omaru-san/casa-freecad/laminas/01_arquitectura.pdf

PLANTA PRIMER PISO | PLANTA SEGUNDO PISO

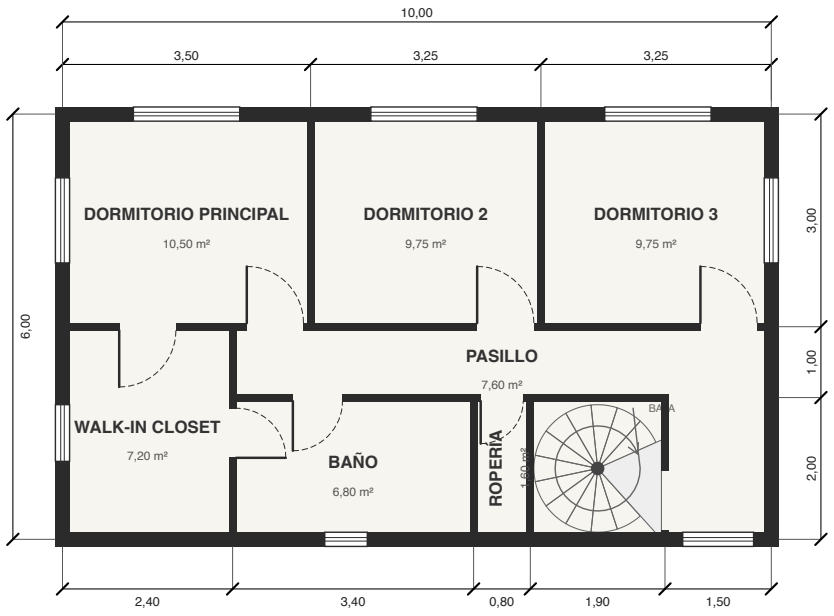
[picture p4: figure]
BAJA; DORMITORIO PRINCIPAL; DORMITORIO 2; DORMITORIO 3; WALK-IN CLOSET; BAÑO; ROPERÍA; PASILLO
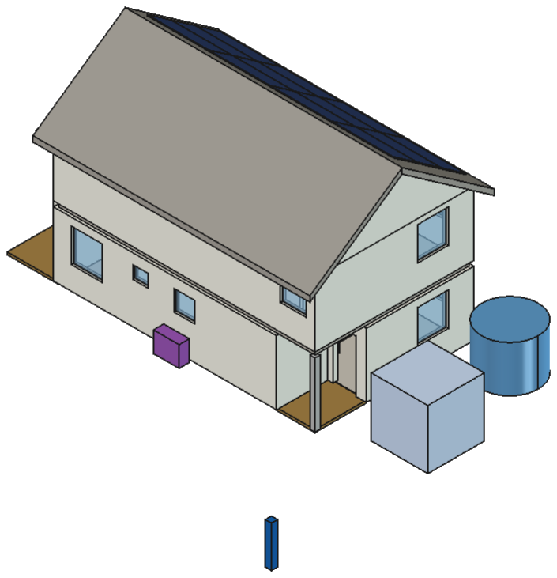
[picture p5: figure]

PROYECTO | VIVIENDA 2 PISOS — ANTEPROYECTO
LÁMINA | PLANTAS DE ARQUITECTURA
ESCALA | 1:100 (imprimir en A3)
FECHA | 20-10-2026
CÓDIGO | ARQ-01 · 1 de 14

Medidas aproximadas — verificar en terreno. +Y = norte geográfico.

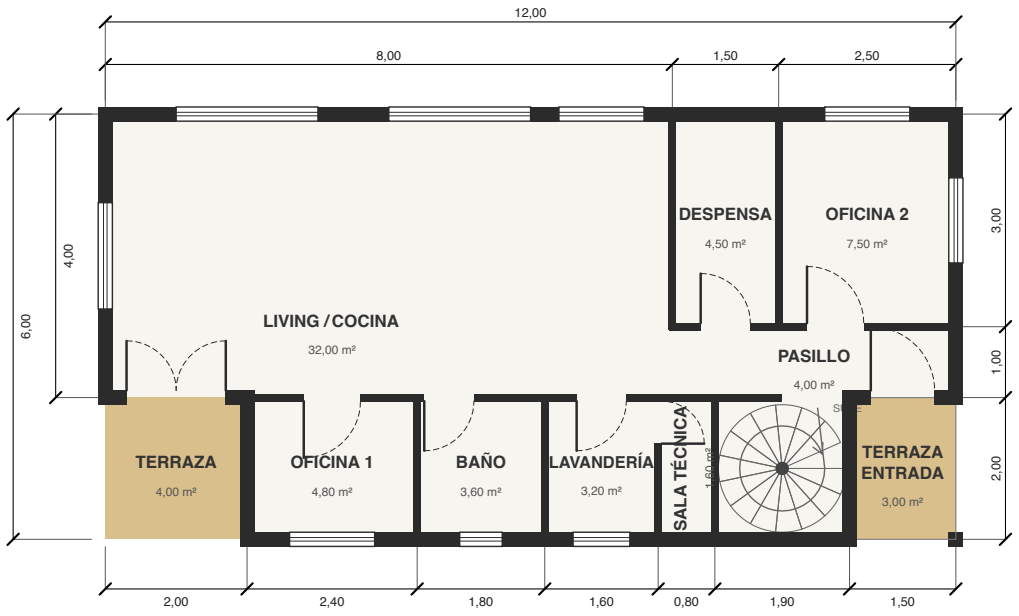
[picture p6: figure]
SUBE; LIVING / COCINA; TERRAZA; OFICINA 1; BAÑO; LAVANDERÍA; SALA TÉCNICA; TERRAZA ENTRADA; DESPENSA; OFICINA 2; PASILLO

CUADRO DE SUPERFICIES | m²
Primer piso | 65,00
Segundo piso | 60,00
Total edificado | 125,00
Terrazas (no edificadas) | 7,00

Superficies medidas a eje de muros

## NOTAS

1. Medidas en metros, a eje de muro. Escala 1:100 en A3.
2. Muros exteriores 20 cm, tabiques 10 cm. Piso-cielo P1 2,36 m, P2 2,50 m (≥ 2,30, OGUC 4.1.1).
3. Entrepiso acústico de madera 34 cm (piso flotante + cielo desacoplado,
detalle en ELE-02). Nivel piso 2 = +2,70 m. El P2 no lleva piso radiante.
4. Escalera helicoidal Ø 1,80 m (ESC-01): 15 contrahuellas de
18 cm, huella 25 cm en la línea de huella. Se entra de frente
desde el pasillo; llega al hall del P2. Barrotes < 10 cm y puertas
de seguridad arriba y abajo (bebé, gatos). Libera la sala técnica.
6. Ventanas P2 con antepecho 1,00 m y limitador de apertura 10 cm.
7. Superficie ≤ 140 m² y 2 pisos → F-15 (OGUC 4.3.5 n°14), DS1 ok.
8. Mesones 0,85 m y muebles altos a 1,40 m (estatura 1,64 m).
9. Medidas en casa_datos.py; regenerar: python3 generar_laminas.py

## VISTA 3D (modelo FreeCAD)

## SIMBOLOGÍA

Muro / tabique

Ventana

Puerta (abatimiento)

Terraza exterior
