omaru-san/casa-freecad/laminas/02_electrico.pdf

PLANTA PRIMER PISO | PLANTA SEGUNDO PISO

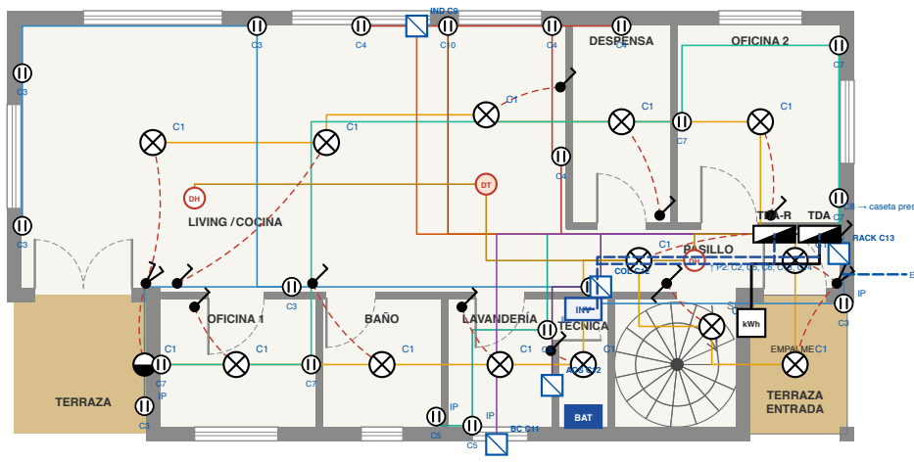
[picture p7: figure]
SUBE; LIVING / COCINA; TERRAZA; OFICINA 1; BAÑO; LAVANDERÍA; SALA; TÉCNICA; TERRAZA ENTRADA; DESPENSA; OFICINA 2; PASILLO; IND C9; ACS C12; COL C12; RACK C13; TDA-R; TDA; kWh; EMPALME; INV; BAT
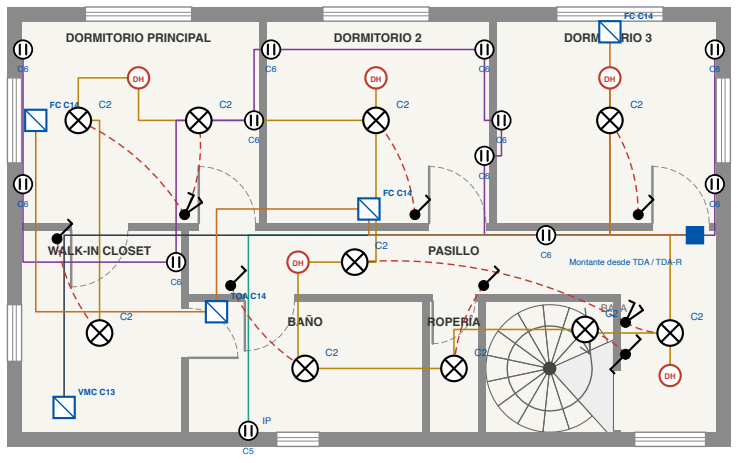
[picture p8: figure]
BAJA; DORMITORIO PRINCIPAL; DORMITORIO 2; DORMITORIO 3; WALK-IN CLOSET; BAÑO; ROPERÍA; PASILLO; VMC C13; TOA C14; Montante desde TDA / TDA-R

C8 → caseta presurizadora / pozo

EV → cargador 11 kW (estac.)

PROYECTO | VIVIENDA 2 PISOS — ANTEPROYECTO
LÁMINA | INSTALACIÓN ELÉCTRICA
ESCALA | 1:100 (imprimir en A3)
FECHA | 20-10-2026
CÓDIGO | ELE-01 · 2 de 14

Medidas aproximadas — verificar en terreno. +Y = norte geográfico.

Circ. | Destino | Protección | Conductor | Fase · dif.
C1 | Alumbrado P1 y terrazas (IP54) | 10 A curva B | 1,5 mm² | R · IDR1
C2 | Alumbrado P2 + detectores de humo | 10 A curva B | 1,5 mm² | S · IDR1
C13 | Ventilación VMC + rack red/domótica | 10 A curva C | 1,5 mm² | R · IDR1
C4 | Enchufes cocina (exclusivo, refrigerador) | 16 A curva C | 2,5 mm² | R · IDR2
C8 | Tablero caseta: presurizadora + bomba pozo | 16 A curva C | 2,5 mm² | T · IDR2
C3 | Enchufes living-comedor y exterior | 16 A curva C | 2,5 mm² | S · ID1
C6 | Enchufes dormitorios P2 | 16 A curva C | 2,5 mm² | T · ID1
C7 | Enchufes oficinas 1 y 2 | 16 A curva C | 2,5 mm² | T · ID1
C5 | Enchufes lavandería y baños | 16 A curva C | 2,5 mm² | T · ID2
C14 | Ventiloconvectores P2 + toallero baño P2 | 10 A curva C | 1,5 mm² | S · ID2
C15 | Exterior: alumbrado, bodega y portón | 16 A curva C | 4 mm² (caída de tensión)T · ID2
C9 | Encimera inducción (limitada a 4,6 kW) | 25 A curva C | 4 mm² | R · ID3
C10 | Horno eléctrico (exclusivo) | 16 A curva C | 2,5 mm² | S · ID3
C11 | Bomba de calor aire-agua (exterior) | 20 A curva C | 4 mm² | S · ID4 tipo A
C12 | Apoyo ACS + circuladores calefacción | 16 A curva C | 2,5 mm² | T · ID4 tipo A
EV | Cargador auto 11 kW (RIC 15, TE6) | 3×16 A curva C | 5×4 mm² | RST · tipo B
FV | Inversor híbrido 6 kW + batería (AFCI) | 3×16 A + DPS | 5×4 mm² | RST · 100 mA

## CUADRO DE CARGAS — TDA (Tablero de distribución)

Empalme trifásico 3×25 A (contratar 3×16 A para mantener BT1 ≤ 10 kW) · general 4P 25 A · alimentador ≥ 6 mm² (apto 3×32 A)

TN-S, tierra ≤ 20 Ω · DPS tipo 1+2 (zona rural, línea aérea) · respaldo desde inversor híbrido: TDA-R con C1, C2, C4, C8, C13

## NOTAS (DS 8/2019 · pliegos RIC SEC)

1. Anteproyecto. Lo calcula, ejecuta y declara (TE1) un instalador SEC; FV con TE4 (RGR 01/02) y cargador EV con TE6 (RIC 15).
2. Diferencial ≤ 30 mA en todo circuito de alumbrado y enchufes, máx. 3 circuitos por diferencial (RIC 10 5.1.3.5 y 5.1.3.7). Tipo A en cargas electrónicas; tipo B en el EV.
3. Enchufes de alvéolos protegidos (RIC 10 5.1.2.8), con tierra.
4. Baños: sin enchufes en volúmenes 0-1-2 (≥ 0,60 m de la ducha). Exterior IP44 bajo alero / IP54 a la intemperie (RIC 10 5.2).
5. Recintos > 10 m²: 2 centros, cada uno con su interruptor.
6. Alturas (estatura 1,64 m): interruptores 1,05 m · enchufes 0,30 m
- cocina y lavandería 1,05 m (mesón 0,85 m) · TDA eje 1,50 m.
7. Canalización PVC conduit Ø20 embutida en cámara técnica (no perfora la barrera de vapor). Nada a la vista (mascotas).
8. Detectores de humo interconectados 220 V + batería (DH) y térmico en cocina (DT). Sin gas: no se requiere detector de CO.
9. Inversor híbrido con AFCI (Res. SEC 33.038, desde 01-01-2026); su salida de respaldo alimenta el TDA-R (C1, C2, C4, C8, C13).
10. Canalización dibujada como árbol por circuito (color) desde su tablero; al P2 sube por una montante en el tabique del pasillo. Diagrama unilineal, cuadro de cargas y frente del tablero: TAB-01.
11. Exterior (C15, EV, C8 caseta, pozo): ductos enterrados en EXT-01.

# SIMBOLOGÍA

### Luminaria de cielo

### Aplique de muro

### Interruptor 9/12

### Interruptor doble 9/32

### Conmutador 9/24

Enchufe 10/16 A alvéolos prot.

IP

### Enchufe IP44 (húmedo)

### Tablero distribución TDA

### Conexión fija de equipo

DH | Detector humo / térmico
kWh | Medidor bidireccional
INV | Inversor híbrido 6 kW
BAT | Batería LiFePO4 11 kWh Retorno interruptor→luz
C3 | N° de circuito
| Montante a P2

## CANALIZACIÓN POR CIRCUITO

C1 | C2 | C3 | C4
C5 | C6 | C7 | C8
C9 | C10 | C11 | C12
C13 | C14 | C15
