omaru-san/casa-freecad/laminas/07_elevaciones_corte.pdf

PROYECTO | VIVIENDA 2 PISOS — ANTEPROYECTO
LÁMINA | ELEVACIONES Y CORTE — ENVOLVENTE TÉRMICA
ESCALA | 1:100 (imprimir en A3)
FECHA | 20-10-2026
CÓDIGO | ELE-02 · 7 de 14

Medidas aproximadas — verificar en terreno. +Y = norte geográfico.

NPT ±0,00 = 26,05 msnm

plataforma −0,30

NPT +2,70

+7,30

# ELEVACIÓN NORTE (paneles y vanos principales)

E O

BC

NPT ±0,00 = 26,05 msnm

plataforma −0,30

NPT +2,70

+7,30

# ELEVACIÓN SUR (acceso y servicios)

O E

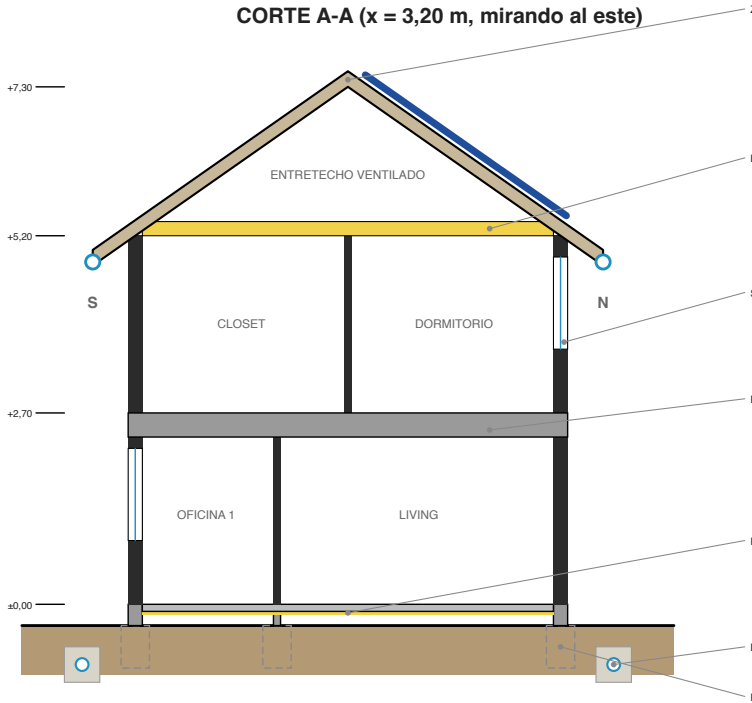
[picture p11: figure]
CORTE A-A (x = 3,20 m, mirando al este); OFICINA 1; LIVING; CLOSET; DORMITORIO; ENTRETECHO VENTILADO

Zinc-alum 0,4 mm · fieltro · OSB 11 mm · cerchas · paneles FV a 35°

Lana mineral 2 × 100 mm · barrera de vapor · yeso-cartón 12,5 mm (U 0,19)

Siding · cámara ventilada · barrera hum. · OSB · 2×6 + lana 140 · b. vapor · cámara técnica 40 · yeso RF 15 (U 0,32, F-15)

Entrepiso acústico 34 cm: porcelanato · piso flotante yeso-fibra · lámina antiimpacto · OSB 18 · vigas 2×10 + lana 100 · canal resiliente · 2 yeso-cartón

Radier 10 cm · polietileno 0,2 mm · grava 10 cm · EPS 50 mm en sobrecimiento

Drenaje perimetral Ø100 + grava + geotextil

Fundación: proyecto por terceros (fuera de alcance)

Elemento | Solución propuesta | U prop. | U máx.
Techumbre | Cielo: 2 capas lana mineral 100 mm cruzadas + barrera vapor | 0,19 | 0,28
Muros | 2×6 + lana min. 140 + OSB + barrera hum. + siding ventilado + cámara técnica + yeso RF (F-15) | 0,32 | 0,40
Piso ventilado | Losa sobre terraza entrada + EPS 80 mm por cara inferior | 0,35 | 0,39
Sobrecimiento | EPS 50 mm por exterior hasta 30 cm bajo terreno (R100 ≈ 130) | — | R100 ≥ 91
Ventanas | PVC DVH low-e, clase 3 de permeabilidad (U 1,6) | 1,60 | según %
Puerta acceso | Puerta aislada con burletes | 1,70 | 1,70

## ENVOLVENTE TÉRMICA — ZONA TÉRMICA G (Mariquina) · OGUC 4.1.10 / DS 15 MINVU

Ventanas sobre muro: N 26 % (máx. 76 %) · S 13 % (máx. 26 %) · O-E 12 % (máx. 40 %) con U 1,6.

Hermeticidad: ≤ 5,0 ren/h a 50 Pa (prov. Valdivia). Partida de sellos en EETT.

Memoria de condensación (Res. Ex. 1802: ext. 3,5 °C / 98 % HR) y ventilación NCh 3309: VMC 35 L/s con recuperador 80 %.

Zona sísmica 3: cálculo estructural (> 100 m²). Fuego: F-15 en soportantes (OGUC 4.3.5 n°14, ≤ 140 m² y 2 pisos).

## DETALLE ENTREPISO ACÚSTICO (34 cm, esquemático · el P2 no lleva piso radiante)

Porcelanato símil madera 20×120 + adhesivo flexible C2S1 · 12 mm

Piso flotante: 2 placas de yeso-fibra 12,5 mm encoladas · 25 mm

Lámina antiimpacto 10 mm (ΔLw ≥ 20 dB) + banda perimetral · 10 mm

OSB 18 mm machihembrado (diafragma estructural) · 18 mm

Vigas 2×10 @ 40 + lana mineral 100 mm en la cavidad · 235 mm

Canal resiliente 13 mm (el cielo no toca las vigas) · 13 mm

2 × yeso-cartón 12,5 mm (la primera RF) · 25 mm

banda

Clave: el piso flotante y el cielo no tocan muros ni vigas rígidamente (banda elástica

perimetral 5 mm, zócalo separado, sello flexible). Escalera apoyada en bandas elastoméricas.

Peso propio 1,06 kN/m² (incluido en calculo/estructura.py). Meta L'nT,w ≤ 55 dB (madera simple ≈ 75 dB).
