omaru-san/casa-freecad/laminas/11_iluminacion_domotica.pdf

PLANTA PRIMER PISO | PLANTA SEGUNDO PISO

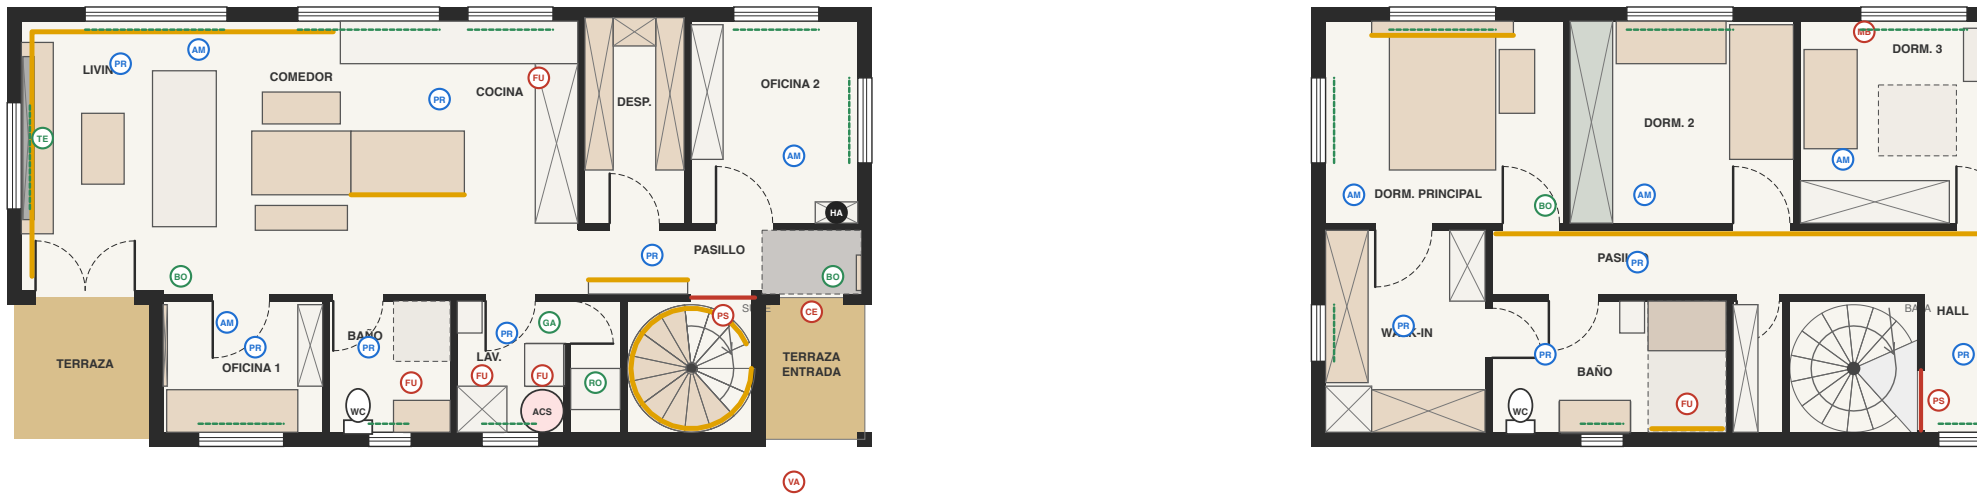
[picture p12: figure]
SUBE; BAJA; LAV; ACS; LIVING; COMEDOR; COCINA; OFICINA 1; BAÑO; LAV.; DESP.; OFICINA 2; PASILLO; TERRAZA; ENTRADA; DORM. PRINCIPAL; DORM. 2; DORM. 3; WALK-IN; HALL
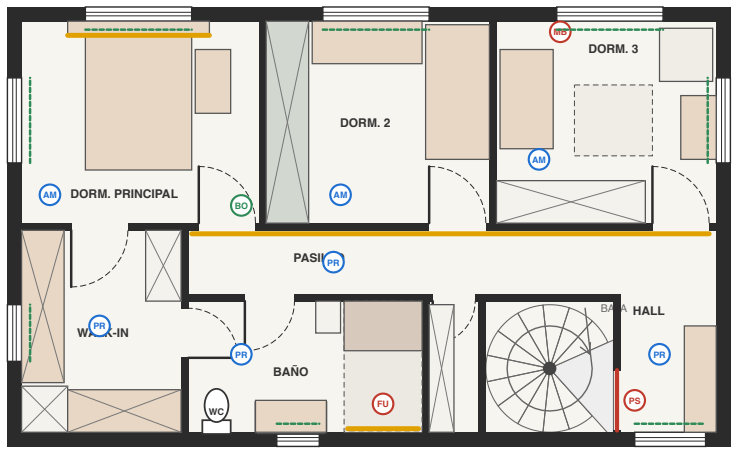
[picture p13: figure]

PROYECTO | VIVIENDA 2 PISOS — ANTEPROYECTO
LÁMINA | ILUMINACIÓN Y DOMÓTICA
ESCALA | 1:100 (imprimir en A3)
FECHA | 20-10-2026
CÓDIGO | INT-02 · 11 de 14

Medidas aproximadas — verificar en terreno. +Y = norte geográfico.

## ESCENAS (Home Assistant, funcionan sin internet)

Escena | Se activa con | Qué hace
Buenos días | Alarma del celular, lun-vie | Cortinas suben, cabecero 30 % → 100 % en 15 min, ACS ok
Cine | Botonera living | Baja el telón, sube el proyector, cortinas cerradas, fosa LED 10 %
Siesta bebé | Botón en dorm. 3 | Timbre en silencio, pasillo P2 ámbar 5 %, VMC en modo bajo
Llegada | Cerradura abre con huella | Genkan + zapatero, clima a confort, aviso si puerta seguridad abierta
Salir | Botonera entrada | Apaga todo, baja temperatura 2 °C, cámaras y sensores de fuga en guardia
Noche | 23:00 o botón cabecero | Guía nocturna ámbar por presencia, puertas de seguridad vigiladas
Sol a favor | Excedente FV > 2 kW | Secadora, lavavajillas, ACS a 60 °C y carga del auto
Fuga | Cualquier sensor FU | Cierra la válvula general y avisa al celular

## ARQUITECTURA DE LA DOMÓTICA

1. Controlador Home Assistant local en el armario técnico G2 (junto al TDA), con UPS. Sin nube obligatoria.
2. Protocolos abiertos: Zigbee 3.0 / Thread-Matter para sensores; Wi-Fi sólo para equipos grandes.
3. Se conservan los interruptores físicos: micromódulos Zigbee detrás (RIC 10, un efecto por luminaria).
4. Cat6 a cada recinto + PoE para cámaras y videoportero. Ducto vacío de reserva al entretecho.
5. Piso radiante: una zona por recinto, termostato = sensor AM; la bomba de calor recibe SG-Ready.
6. VMC sube automáticamente con CO₂ > 900 ppm o HR > 65 % (baños, cocina, lavandería).
7. Cortinas motorizadas a batería recargable (sin cordones: seguridad bebé y gatos).
8. Ver INTERIORISMO.md para equipos sugeridos, etapas y presupuesto.

## EQUIPOS POR ETAPA (referencial 2026, cotizar)

Etapa | Equipos | CLP
1 · Obra gruesa | Cat6 a cada recinto, ducto de reserva, cajas profundas tras interruptores, enchufe en G2 | 0,3–0,5 MM
2 · Mudanza | Home Assistant (mini PC) + coordinador Zigbee/Thread, cerradura digital, 6 sensores de fuga + válvula | 0,6–0,9 MM
3 · Confort | Sensores AM por zona, presencia mmWave, micromódulos en interruptores, contactos puertas seg. | 0,6–1,0 MM
4 · Cuando haya capital | Cortinas motorizadas (17 ventanas), telón + proyector UST, LED indirecto, videoportero PoE | 2,5–4,5 MM

# SIMBOLOGÍA

HA | Home Assistant + rack (en G2)
PR | Sensor de presencia mmWave
AM | Sensor ambiente T° / HR / CO₂ (zona piso radiante)
FU | Sensor de fuga de agua
VA | Válvula motorizada de corte de agua
CE | Cerradura digital + videoportero
PS | Contacto en puerta de seguridad
MB | Monitor de bebé local (sin nube)
TE | Motor del telón + proyector
GA | Gatera con lector de microchip
RO | Base de aspiradora robot
BO | Botonera de escenas (reemplaza interruptor)
| LED indirecto regulable
| Cortina motorizada
| Puerta de seguridad
