omaru-san/casa-freecad/laminas/13_obras_exteriores.pdf

PROYECTO | VIVIENDA 2 PISOS — ANTEPROYECTO
LÁMINA | OBRAS EXTERIORES: CERCO, ACCESOS, LUCES Y DUCTOS
ESCALA | 1:200
FECHA | 20-10-2026
CÓDIGO | EXT-01 · 13 de 14

Medidas aproximadas — verificar en terreno. +Y = norte geográfico.

# PLANTA DE OBRAS EXTERIORES

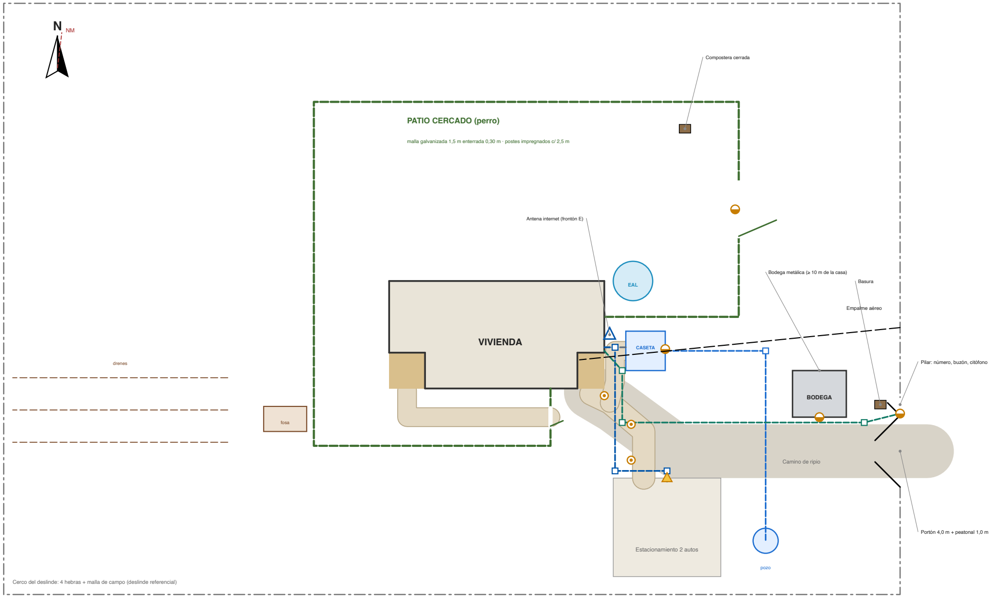
[picture p14: figure]
Estacionamiento 2 autos; Camino de ripio; Portón 4,0 m + peatonal 1,0 m; Pilar: número, buzón, citófono; fosa; drenes; CASETA; pozo; EAL; VIVIENDA; BODEGA; Bodega metálica (≥ 10 m de la casa); PATIO CERCADO (perro); Compostera cerrada; Basura; Antena internet (frontón E); Empalme aéreo

Cerco del deslinde: 4 hebras + malla de campo (deslinde referencial) malla galvanizada 1,5 m enterrada 0,30 m · postes impregnados c/ 2,5 m

0 | 10 m
Ítem | Especificación | Cantidad
Patio cercado (perro) | Malla galv. 1,5 m enterrada 0,30 m, postes 3×3" impregnados c/ 2,5 m | 78,80 m
Puertas del patio | Peatonal 1,0 m con cierre automático + portón 3,0 m de jardín | 2 u
Cerco del deslinde | 4 hebras + malla de campo (largo referencial: definir con la escritura) | 161 m
Portón de acceso | Vehicular 4,0 m batiente con motor 24 V y batería + peatonal 1,0 m | 1 + 1 u
Pilar de acceso | Número iluminado, buzón, citófono IP, caseta de basura cerrada | 1 u
Senderos | Adoquín o baldosa sobre base compactada 15 cm, drenante | 20,53 m²
Bodega exterior | Metálica 3,0 × 2,6 m sobre radier, luz y enchufe (C15) | 7,80 m²
Luminarias exteriores | LED 2700 K apantalladas, sensor + crepuscular (C15) | 3 bal. · 1 foco · 4 apl.
Ductos enterrados | Zanja 0,60 m, energía y datos separados, cinta, cámaras 40×40 | 48 m
Residuos | Caseta de basura junto al camino + compostera de 2 cámaras | 2 u
Internet rural | Antena 4G/5G o satelital en frontón E + ducto al rack | 1 u

## CUADRO DE OBRAS EXTERIORES (cantidades del dibujo; cotizar con el deslinde real)

# SIMBOLOGÍA

## Cerco patio (perro)

## Cerco del deslinde

## Sendero pavimentado

## Baliza de sendero

## Foco con sensor

## Aplique exterior

## Ducto C15 + datos

## Ducto cargador EV

## Ducto C8 caseta

## Cable bomba del pozo

## Cámara de paso 40×40

## Residuos

# CRITERIOS

1. El patio usa la casa como parte del cierre: la entrada, la caseta, la fosa y el estacionamiento quedan fuera (camión limpiafosas sin abrir el patio).
2. La malla enterrada evita que el perro excave. Los gatos no se contienen con cerco.
3. Bodega metálica a ≥ 10 m de la casa (CONAF): no hay leña ni combustibles junto a los muros.
4. Luz cálida 2700 K hacia abajo (fauna, cielo oscuro); se enciende con sensor y escena HA.
5. Zanja común a 0,60 m: energía y datos en ductos separados ≥ 0,20 m, cinta de advertencia encima.
6. Senderos drenantes: el barro de Los Ríos queda fuera del genkan.
7. Basura cerrada junto al camino (recolección rural), compost dentro del patio en compostera cerrada.
8. Fajas CONAF, fosa, drenes y aguas lluvias: EMP-01.
