omaru-san/casa-freecad/laminas/14_escaleras.pdf

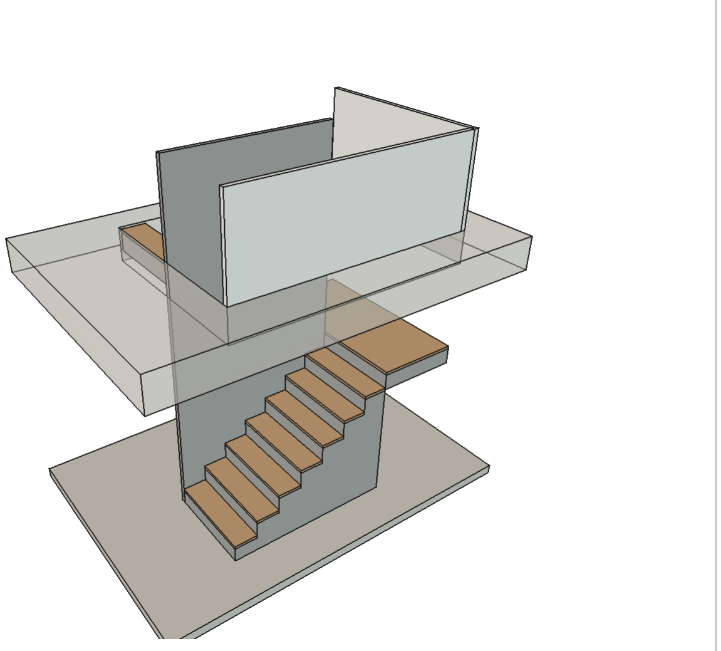
[picture p15: figure]
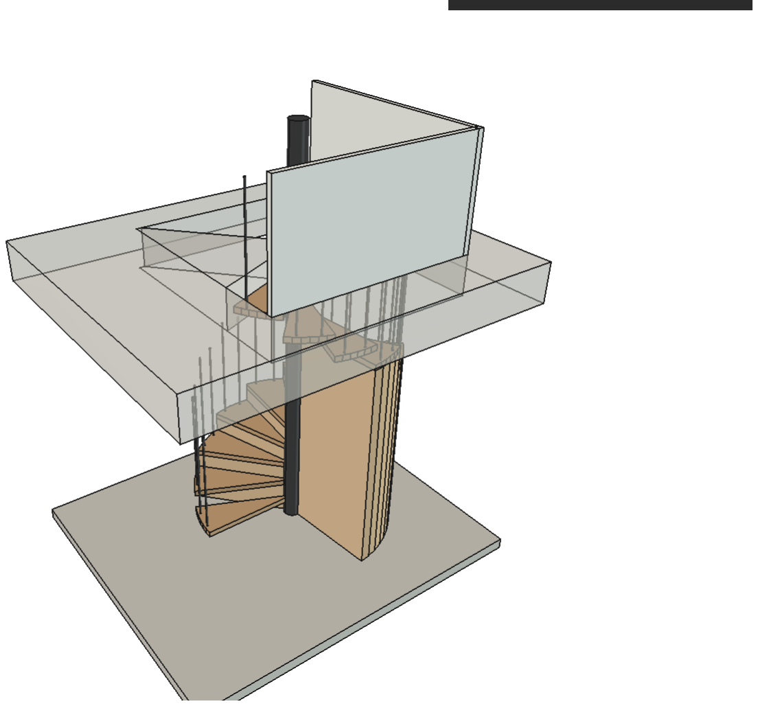
[picture p16: figure]

PROYECTO | VIVIENDA 2 PISOS — ANTEPROYECTO
LÁMINA | ALTERNATIVAS DE ESCALERA
ESCALA | 1:50 (plantas) · 3D sin escala
FECHA | 20-10-2026
CÓDIGO | ESC-01 · 14 de 14

Medidas aproximadas — verificar en terreno. +Y = norte geográfico.

## A · KAIDAN-DANSU (ANTERIOR)

Escalera-mueble japonesa: peldaños macizos con cajones

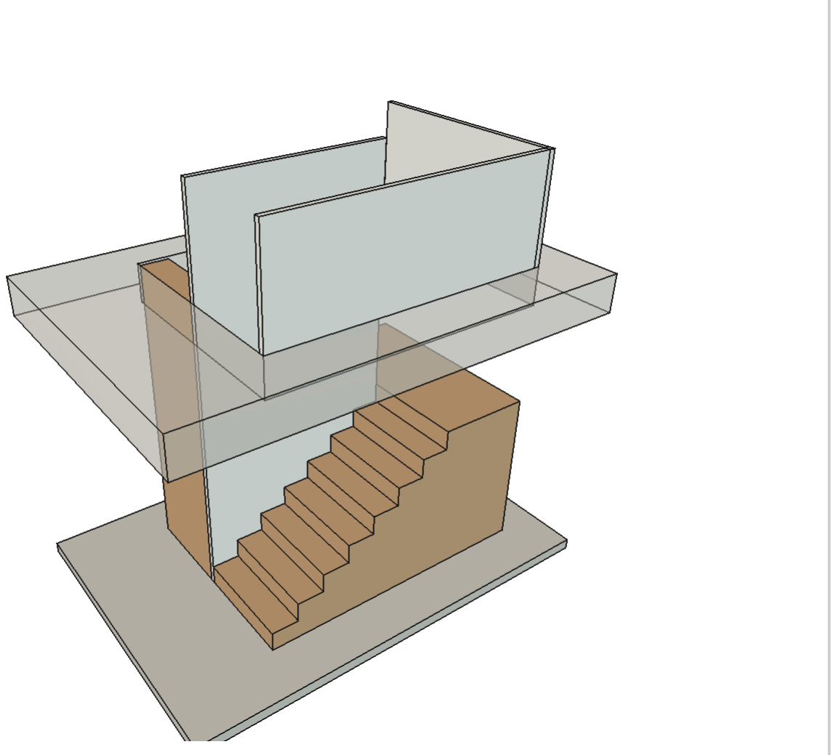
[picture p17: figure]

Vista 3D (muros perimetrales ocultos)

PLANTA P1 1:50

pasillo P1 · SUBE

hall P2

7 cajones (E1)

Bodega + sala técnica

ESTRUCTURA

Cajones-peldaño de lenga sobre zócalo, tramo 2
en zanca de madera apoyada en bandas elastoméricas. Contrahuella cerrada; tabique guarda central.

A FAVOR

- Máximo guardado (cajones + bodega)
- Sin huecos: segura para bebé y gatos
- Peldaños anchos: se sube con la bebé en brazos

CUIDADOS

- Caja cerrada: no pasa luz
- Madera hueca: algo de eco en los pasos
Costo referencial: | base (100 %)
Se construye en: | Terminaciones (Etapa 6)
¿Cambia la planta?: | No

## B · CELOSÍA FLOTANTE (TATEGOSHI)

Peldaños en voladizo y celosía de listones hasta la baranda del P2

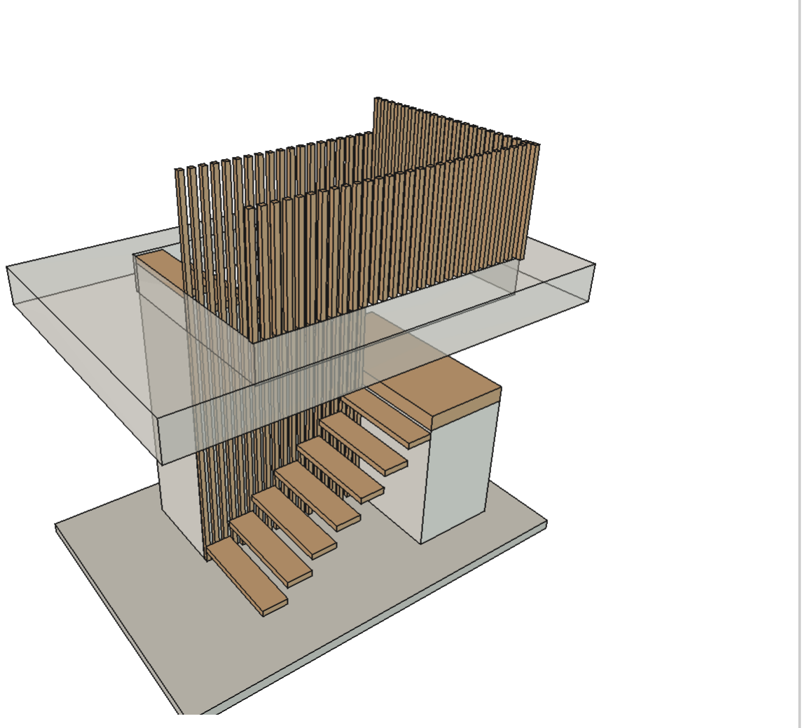
[picture p18: figure]

Vista 3D (muros perimetrales ocultos)

PLANTA P1 1:50

pasillo P1 · SUBE

hall P2

Bodega + sala técnica (cerrada)

ESTRUCTURA

Peldaños de lenga 60 mm empotrados con pletinas de acero 8 mm al muro norte reforzado (pies derechos dobles). Contrahuella abierta con hueco ≤ 10 cm.

A FAVOR

- Luz del hall P2 baja al pasillo P1
- La más liviana a la vista: japandi puro
- La celosía no se escala (listones verticales)

CUIDADOS

- Se pierden los 7 cajones
- Peldaño volado: más resonante
- Pletinas y muro reforzado en obra gruesa
Costo referencial: | +20–30 %
Se construye en: | Pletinas en Etapa 4, peldaños en Etapa 6
¿Cambia la planta?: | No

## C · COMPACTA COMPENSADA

Giro en abanico sin descanso: hueco 0,70 m más corto

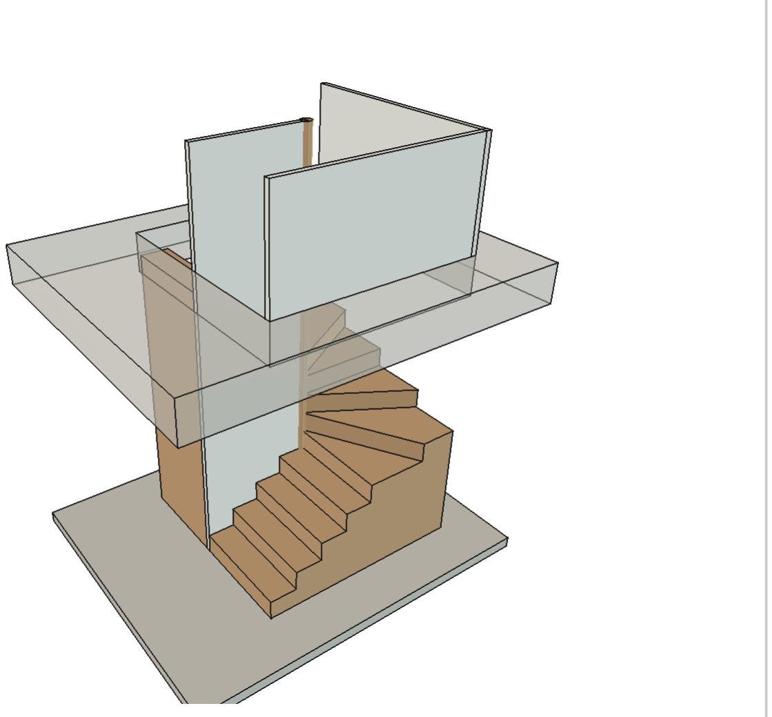
[picture p19: figure]

Vista 3D (muros perimetrales ocultos)

PLANTA P1 1:50

+0,70
lavand.

pasillo P1 · SUBE

hall P2

4 cajones

Sala técnica

ESTRUCTURA

4 peldaños + 6 compensados + 4 peldaños, macizos de lenga; poste-núcleo en el pivote y pasamanos continuo por el lado exterior (línea de huella).

A FAVOR

- Lavandería P1 y baño P2 crecen 0,70 m
- Menos hueco en el entrepiso: más barata
- Sigue cerrada abajo

CUIDADOS

- Borde interior del abanico angosto
- Mover el tabique x 7,80 en ambos pisos
- Bodega bajo la escalera se reduce
Costo referencial: | −10–15 %
Se construye en: | Terminaciones (Etapa 6)
¿Cambia la planta?: | Sí: tabique 7,80 → 8,50

## D · MACIZA ACÚSTICA

Hormigón revestido en lenga, desolidarizada de la casa

Vista 3D (muros perimetrales ocultos)

PLANTA P1 1:50

pasillo P1 · SUBE

hall P2

Bodega + sala técnica

ESTRUCTURA

Tramo 1 macizo sobre radier engrosado; descanso y tramo 2 en losa quebrada 15 cm sobre apoyos de neopreno. Huella de lenga 30 mm sobre antiimpacto.

A FAVOR

- Casi no suena: la masa corta los golpes
- Masa térmica junto al piso radiante
- Dura toda la vida sin crujir

CUIDADOS

- ~5 t: radier engrosado bajo el tramo 1
- Se hace en obra gruesa (moldaje)
- Sin cajones bajo el tramo 1
Costo referencial: | +40–60 %
Se construye en: | Obra gruesa (Etapa 3–4)
¿Cambia la planta?: | No

## E · HELICOIDAL Ø 1,80 (ELEGIDA)

De frente desde el pasillo; guardado oculto bajo los peldaños

Vista 3D (muros perimetrales ocultos)

EN LOS PLANOS

PLANTA P1 1:50

+0,80
sala
técnica

pasillo P1 · SUBE

hall P2

ESTRUCTURA

Pilar de acero Ø 160 anclado al radier; peldaños
de lenga 50 mm en ménsula. Bajo los peldaños 3–11, tambor de listones con puertas push invisibles.

A FAVOR

- Libera 0,80 m: sala técnica y ropería
- ~1,8 m³ de guardado que no se ve
- Primer peldaño de frente al entrar

CUIDADOS

- Muebles grandes no suben: por ventana
- Peldaño angosto junto al pilar
- Tambor curvo: carpintería a medida
Costo referencial: | +10 a +25 %
Se construye en: | Terminaciones (Etapa 6)
¿Cambia la planta?: | Sí: tabique nuevo x 8,60

## COMÚN A TODAS

1. Entrada por el mismo vano del pasillo P1 y llegada al hall del P2: 15 contrahuellas de 18 cm, huella 25 cm en la línea de huella (2ch + h = 0,61 m).
2. Baranda 0,95 m en el P2 y pasamanos continuo a 0,90 m; ningún hueco > 10 cm (bebé y gatos).
3. Puertas de seguridad arriba y abajo con sensor; nariz antideslizante y luz LED en peldaños.
4. Apoyos en bandas elastoméricas, sin contacto rígido con los muros de los dormitorios.

## LECTURA

5. A–D ocupan 2,60 × 1,90 m; E sólo 1,80 × 1,90 y deja 0,80 m para sala técnica (P1) y ropería (P2).
6. Huella a 15 cm del borde interior: C 0,08 m, E 0,10 m (en la línea de huella: 0,25 / 0,25).
7. E: altura libre mínima 2,00 m; camas y clósets al P2 desarmables o por ventana.
8. D pesa ≈ 4,6 t. Costos relativos a la A (lenga + carpintería); cotizar.

## COMPARACIÓN (●●● mejor · ●○○ peor)

Criterio | A · Kaidan-dansu | B · Celosía flotante | C · Compacta compensada | D · Maciza acústica | E · Helicoidal Ø 1,80

Guardado bajo la escalera

Luz natural al 1er piso

Silencio al subir y bajar

Seguridad bebé y gatos

Espacio que libera

Total | 10 | 9 | 9 | 10 | 11
