omaru-san/casa-freecad/normas/README.md

# Biblioteca normativa — Casa Puringue Pobre (Mariquina, Los Ríos)

> **En el repositorio de GitHub los PDF no están incluidos** (656 MB de documentos de terceros). Los índices `INDICE.md` de cada carpeta tienen las fuentes oficiales para volver a descargarlos.

Descargada el 19-10-2026. Son 152 PDF oficiales y gratuitos, unos 656 MB, todos verificados como PDF reales.
Cada carpeta tiene un `INDICE.md` con:
- la tabla de documentos;
- las exigencias concretas que aplican a esta casa;
- las normas pagadas, que no se descargaron;
- los puntos por confirmar.

| Carpeta | Contenido | Abrir primero |
|---|---|---|
| [01_permisos_urbanismo_estructura](01_permisos_urbanismo_estructura/INDICE.md) | Permisos, urbanismo, estructura y aislación. Ver detalle abajo. | OGUC 2026 (art. 4.1.10 y Título 5 Cap. 6), DDU 455 |
| [02_electrico_solar_domotica](02_electrico_solar_domotica/INDICE.md) | Electricidad, solar y telecomunicaciones. Ver detalle abajo. | RIC-10, RGR-02, RIC-15 |
| [03_agua_alcantarillado_gas_calefaccion](03_agua_alcantarillado_gas_calefaccion/INDICE.md) | Agua, alcantarillado, gas y calefacción. Ver detalle abajo. | DS 236, RIDAA, guía de bombas de calor |
| [04_fuego_sustentabilidad_ventilacion_subsidios](04_fuego_sustentabilidad_ventilacion_subsidios/INDICE.md) | Fuego, sustentabilidad, ventilación y subsidios. Ver detalle abajo. | Listado de fuego ED17, ECSV Tomo I, ficha DS1 |
| [05_NCh_INN](05_NCh_INN/INDICE.md) | Normas NCh del INN: cómo leerlas gratis (visor MINVU), precios y valores públicos que las reemplazan | Visor [normastecnicas.minvu.cl](https://normastecnicas.minvu.cl/) |

**Detalle por carpeta:**
- **01 Permisos, urbanismo y estructura:**
  - LGUC y OGUC actualizadas a 2026.
  - Reglamentación térmica DS 15 y LOSCAT Ed. 14.
  - Área rural (art. 55), Ley 21.718 y DS 10/2025.
  - Decretos que oficializan NCh433:2026 y NCh1198:2024.
  - Manuales de madera (CORMA, CIM UC) y de suelos del sur.
- **02 Electricidad, solar y telecomunicaciones:**
  - DS 8/2019 y los 19 pliegos RIC de la SEC.
  - Net billing: Ley 20.571, Ley 21.118, DS 57, RGR 01/02/06 y AFCI 2026.
  - Formularios SAESA y RIC 15 (cargador de auto eléctrico), con su trámite TE6.
  - Tarifas y telecomunicaciones.
- **03 Agua, alcantarillado, gas y calefacción:**
  - RIDAA y DS 236 (fosa séptica).
  - DS 735, Ley 20.998 de servicios sanitarios rurales y DS 40 de aguas grises.
  - Código de Aguas, DS 66 de gas y DS 13/2026.
  - Guía de bombas de calor, guías de agua lluvia y prevención de Legionella.
- **04 Fuego, sustentabilidad, ventilación y subsidios:**
  - Listado de Comportamiento al Fuego ED17.
  - Guías CONAF de interfaz urbano-forestal.
  - Estándares de Construcción Sustentable (ECSV, Tomos I a VI).
  - Manuales de hermeticidad, ventilación y CEV.
  - Fichas de los subsidios DS1 y DS10.

**Las normas NCh del INN son pagadas.** No se descargaron copias piratas. Cada índice lista las relevantes con su link a la tienda del INN.
Las obligatorias (NCh433, NCh1198, NCh853, NCh3308/3309, etc.) se leen gratis en el [visor oficial del MINVU](https://normastecnicas.minvu.cl/), solo en pantalla. Los proyectistas deberían tener las demás.

El manual de construcción que usa todo esto está en [../MANUAL_CONSTRUCCION.md](../MANUAL_CONSTRUCCION.md).
