omaru-san/casa-freecad/CUMPLIMIENTO_NORMATIVO.md

# Cumplimiento normativo — anteproyecto Casa Puringue Pobre

> Generado por `python3 -I calculo/verificar_normas.py` a partir de los archivos de datos. Se vuelve a generar después de cada cambio de diseño.
> **Fundaciones fuera de alcance** (las proyecta un tercero; la lámina 08 entrega las cargas).

**Resultado:** 67 de 67 verificaciones cumplen.

Estados:
- **CUMPLE:** calculado por el script o especificado en los planos.
- **a verificar en obra:** requiere una prueba física.
- Tipo **criterio:** buena práctica más exigente que la norma.

| Tema | Exigencia | Proyecto | Estado | Fuente |
|---|---|---|---|---|
| Arquitectura | Altura piso-cielo ≥ 2,30 m (piso 1) | 2,36 m | CUMPLE | OGUC 4.1.1 |
| Arquitectura | Altura piso-cielo ≥ 2,30 m (piso 2) | 2,50 m | CUMPLE | OGUC 4.1.1 |
| Fuego / subsidio | Superficie edificada ≤ 140 m² y ≤ 2 pisos → F-15 en soportantes; tope DS1 | 125,0 m² | CUMPLE | OGUC 4.3.5 n°14 · DS1 MINVU |
| Arquitectura | Ventana al exterior en local habitable: Living / Cocina | sí | CUMPLE | OGUC 4.1.2 |
| Arquitectura | Ventana al exterior en local habitable: Oficina 1 | sí | CUMPLE | OGUC 4.1.2 |
| Arquitectura | Ventana al exterior en local habitable: Oficina 2 | sí | CUMPLE | OGUC 4.1.2 |
| Arquitectura | Ventana al exterior en local habitable: Dormitorio Principal | sí | CUMPLE | OGUC 4.1.2 |
| Arquitectura | Ventana al exterior en local habitable: Dormitorio 2 | sí | CUMPLE | OGUC 4.1.2 |
| Arquitectura | Ventana al exterior en local habitable: Dormitorio 3 | sí | CUMPLE | OGUC 4.1.2 |
| Seguridad niños | Antepecho ventanas P2 ≥ 0,95 m (art. 4.2.7 no rige en vivienda unifamiliar; se aplica igual) | 1,00 m | CUMPLE | OGUC 4.2.7 (recomendación) |
| Arquitectura | Escalera cómoda: 0,60 ≤ 2·ch + h ≤ 0,65 m, ch ≤ 0,18 m | ch 0,180 · 2ch+h 0,611 | CUMPLE | Buena práctica (OGUC 4.2.11 sólo rige en evacuación) |
| Arquitectura | Escalera helicoidal: altura libre de paso ≥ 2,00 m (bajo el descanso P2 y al entrar) | 2,00 m | CUMPLE | Buena práctica (2,00 m habitual) |
| Arquitectura | Alternativas de escalera (ESC-01): 0,60 ≤ 2·ch + h ≤ 0,65 m en la línea de huella | A 0,611 · B 0,611 · C 0,611 · D 0,611 · E 0,611 | CUMPLE | Buena práctica |
| Térmica zona G | U techumbre ≤ 0,28 W/m²K | 0,19 | CUMPLE | OGUC 4.1.10 (DS 15) |
| Térmica zona G | U muros ≤ 0,40 W/m²K | 0,32 | CUMPLE | OGUC 4.1.10 (DS 15) |
| Térmica zona G | U piso ventilado ≤ 0,39 W/m²K | 0,35 | CUMPLE | OGUC 4.1.10 (DS 15) |
| Térmica zona G | U puerta acceso ≤ 1,70 W/m²K | 1,70 | CUMPLE | OGUC 4.1.10 (DS 15) |
| Térmica zona G | Ventanas N ≤ 76 % del muro (U ventana ≤ 1,6) | 26 % | CUMPLE | DS 15, Tabla 3 |
| Térmica zona G | Ventanas S ≤ 26 % del muro (U ventana ≤ 1,6) | 13 % | CUMPLE | DS 15, Tabla 3 |
| Térmica zona G | Ventanas EO ≤ 40 % del muro (U ventana ≤ 1,6) | 12 % | CUMPLE | DS 15, Tabla 3 |
| Térmica zona G | Hermeticidad ≤ 5,0 ren/h a 50 Pa (prov. Valdivia) | meta 3,0 (blower door) | CUMPLE | DS 15 · Actualización RT DITEC |
| Ventilación | Caudal NCh 3309 ≥ 0,15·A + 3,5·(dorm+1) = 32,8 L/s | impulsión 35 / extracción 35 L/s | CUMPLE | DS 15 → NCh 3309 (vía ECSV Tomo I) |
| Ventilación | Extracción continua Baño P1 ≥ 10 L/s | 10 L/s | CUMPLE | ECSV Tomo I / OGUC 4.1.3 |
| Ventilación | Extracción continua Baño P2 ≥ 10 L/s | 10 L/s | CUMPLE | ECSV Tomo I / OGUC 4.1.3 |
| Ventilación | Extracción continua Cocina ≥ 10 L/s | 10 L/s | CUMPLE | ECSV Tomo I / OGUC 4.1.3 |
| Eléctrico | Centros de luz Living / Cocina P1 (32,0 m²) ≥ 2 | 3 | CUMPLE | RIC 10 5.2 a) |
| Eléctrico | Enchufes Living / Cocina P1: 1 por cada 8 m de perímetro → ≥ 3 | 4 | CUMPLE | RIC 10 5.2 b) |
| Eléctrico | Centros de luz Oficina 1 P1 (4,8 m²) ≥ 1 | 1 | CUMPLE | RIC 10 5.2 a) |
| Eléctrico | Enchufes Oficina 1 P1: 1 por cada 8 m de perímetro → ≥ 2 | 3 | CUMPLE | RIC 10 5.2 b) |
| Eléctrico | Centros de luz Baño P1 (3,6 m²) ≥ 1 | 1 | CUMPLE | RIC 10 5.2 a) |
| Eléctrico | Centros de luz Oficina 2 P1 (7,5 m²) ≥ 1 | 1 | CUMPLE | RIC 10 5.2 a) |
| Eléctrico | Enchufes Oficina 2 P1: 1 por cada 8 m de perímetro → ≥ 2 | 3 | CUMPLE | RIC 10 5.2 b) |
| Eléctrico | Cada centro con interruptor independiente (P1) | 14 centros, 12 mandos | CUMPLE | RIC 10 5.2 a) |
| Eléctrico | Centros de luz Dormitorio Principal P2 (10,5 m²) ≥ 2 | 2 | CUMPLE | RIC 10 5.2 a) |
| Eléctrico | Enchufes Dormitorio Principal P2: 1 por cada 8 m de perímetro → ≥ 2 | 4 | CUMPLE | RIC 10 5.2 b) |
| Eléctrico | Centros de luz Dormitorio 2 P2 (9,8 m²) ≥ 1 | 1 | CUMPLE | RIC 10 5.2 a) |
| Eléctrico | Enchufes Dormitorio 2 P2: 1 por cada 8 m de perímetro → ≥ 2 | 5 | CUMPLE | RIC 10 5.2 b) |
| Eléctrico | Centros de luz Dormitorio 3 P2 (9,8 m²) ≥ 1 | 1 | CUMPLE | RIC 10 5.2 a) |
| Eléctrico | Enchufes Dormitorio 3 P2: 1 por cada 8 m de perímetro → ≥ 2 | 6 | CUMPLE | RIC 10 5.2 b) |
| Eléctrico | Centros de luz Baño P2 (6,8 m²) ≥ 1 | 1 | CUMPLE | RIC 10 5.2 a) |
| Eléctrico | Cada centro con interruptor independiente (P2) | 10 centros, 8 mandos | CUMPLE | RIC 10 5.2 a) |
| Eléctrico | Cocina ≥ 3 enchufes dobles + circuito exclusivo 16 A + circuitos de inducción y horno | 3 en C4 + C9 + C10 | CUMPLE | RIC 10 5.2 d), e) |
| Eléctrico | Diferencial ≤ 30 mA en todo circuito de alumbrado/enchufes y ≤ 3 circuitos por diferencial | 6 diferenciales, máx. 3 circuitos | CUMPLE | RIC 10 5.1.3.5 y 5.1.3.7 |
| Eléctrico | Enchufes del baño P1 fuera de volúmenes 0-1-2 (≥ 0,60 m de la ducha) | 0,85 m | CUMPLE | RIC 11 sección 6 |
| Eléctrico | Enchufes del baño P2 fuera de volúmenes 0-1-2 (≥ 0,60 m de la ducha) | 1,55 m | CUMPLE | RIC 11 sección 6 |
| Eléctrico | Tablero fuera de dormitorios, baños, lavaderos y closets | PASILLO | CUMPLE | RIC 10 5.1.3.2 |
| Eléctrico | Enchufes de alvéolos protegidos; cargador EV con circuito exclusivo y diferencial tipo B | especificado | CUMPLE | RIC 10 5.1.2.8 · RIC 15 |
| Solar | Inversor con detección de arco (AFCI); diferencial 100 mA (5–10 kW) | inversor 6 kW | CUMPLE | Res. SEC 33.038 · RGR 02 |
| Eléctrico | Fases equilibradas: desbalance de demanda ≤ 10 % | R 5.120 · S 5.250 · T 5.200 W (2,5 %) | CUMPLE | Buena práctica (RIC 10) |
| Eléctrico | Demanda por fase ≤ empalme 25 A (EV con gestión dinámica) | 22,8 A | CUMPLE | RIC 10 / cuadro de cargas TAB-01 |
| Eléctrico | Subtablero de respaldo (TDA-R) desde la salida backup del inversor; DPS tipo 1+2 por línea aérea rural | TDA-R: C1, C2, C13, C4, C8 | CUMPLE | RIC 10 · RGR 02 · IEC 61643 |
| Estructura | Flecha viga de entrepiso ≤ L/360 (piso de porcelanato sobre madera) | 10,2 mm ≤ 11,1 mm | CUMPLE | Fabricantes de adhesivos (ANSI A108 / TCNA) |
| Acústica | Entrepiso con piso flotante sobre lámina antiimpacto y cielo desacoplado (meta L'nT,w ≤ 55 dB) | 34 cm · 1,06 kN/m² | **a verificar en obra** | Criterio (OGUC 4.1.6 rige sólo entre unidades distintas) |
| Sanitario | Pendiente de descargas 3 %–15 % (1 % sólo justificado) | 3 % (rótulo y notas) | CUMPLE | RIDAA art. 88 |
| Sanitario | Drenes y fosa a ≥ 20 m del pozo | drenes 30,5 m · fosa 26,3 m | CUMPLE | DS 236 |
| Sanitario | Fosa ≥ 24 h de retención + lodos 2 años (5 pers. ≈ 1,1 m³) | 2,4 m³ | CUMPLE | DS 236 |
| Sanitario | Presión ≥ 14 m.c.a. tras la llave de paso; bomba aspira de estanque; partida-detención ≤ 12 m.c.a. | presurizadora VSD 30–42 m.c.a. desde estanque 3.000 L | CUMPLE | RIDAA art. 52 f) y bombeo k) |
| Sanitario | Agua caliente sin gas: acumulación ≥ 60 °C semanal (Legionella) y salida ≤ 48 °C (niños) | acumulador 300 L + VMT 45 °C | CUMPLE | Guías Legionella (Sanidad ES / Gob. Vasco) |
| Sanitario | Agua fría/caliente fuera del radier (piso radiante): por muros o entrepiso, nunca embutida en el piso | 2 tramos por entrepiso · 0 puntos fuera de muro | CUMPLE | Criterio de mantención (RIDAA art. 52: cañerías accesibles) |
| Sanitario | Cámara desgrasadora en la descarga de la cocina, antes de la fosa | C.D. | CUMPLE | DS 236 · Manual SUBDERE (soluciones particulares) |
| Calefacción | Temperatura superficial de piso radiante (P1) ≤ 29 °C en zonas de estar | 24,9 °C (51 W/m²) | CUMPLE | UNE-EN 1264 (referencia) |
| Calefacción | P2 sin piso radiante: cada dormitorio con ventiloconvector ≥ su carga (equipo mín. 800 W a 35 °C) | Dorm. principal 313 W · Dormitorio 2 291 W · Dormitorio 3 291 W | CUMPLE | Balance térmico VEN-01 |
| Calefacción | Sin artefactos de combustión ni chimeneas (riesgo CO e incendio) | bomba de calor + inducción | CUMPLE | Criterio de diseño (DS 66 no aplica: sin gas) |
| Fuego | Faja de defensa 0–2–10–30 m, techo metálico, aleros cerrados con malla | dibujada en EMP-01 | CUMPLE | CONAF Comunidades Preparadas · MINVU Chile se Prepara |
| Fuego | Detectores de humo interconectados en dormitorios y circulaciones | 7 DH + 1 DT | CUMPLE | Buena práctica (proyecto de ley en trámite) |
| Fuego | Bodega exterior no combustible a ≥ 10 m de la casa | 10,5 m | CUMPLE | CONAF Comunidades Preparadas |
| Exterior | Patio cercado del perro deja fuera fosa (camión), estacionamiento y caseta de agua | ok | CUMPLE | Criterio de diseño (EXT-01) |

## Cambios hechos al diseño para cumplir (20-10-2026)

### Casa todo eléctrica
- Se eliminaron el gas, el calefont y la estufa a pellet.
- **Calefacción:** bomba de calor aire-agua (~6 kW): piso radiante en el 1er piso y ventiloconvectores
  (fancoils) a la misma temperatura en los dormitorios del 2° piso; toallero eléctrico en el baño P2.
- **Agua caliente:** acumulador de 300 L con válvula mezcladora termostática a 45 °C.
- **Cocina:** encimera de inducción.
- **Resultado:** sin CO ni chimeneas, sin trámite TC6.

### Ventilación
- VMC de doble flujo con recuperador de calor 80 %, 35 L/s (NCh 3309).
- Reemplaza los extractores, las rejillas de gas y la microventilación.

### Electricidad
- **Circuitos:** de 9 a 17, con circuitos exclusivos para:
  - cocina;
  - inducción;
  - horno;
  - bomba de calor;
  - apoyo de agua caliente y circuladores de calefacción;
  - ventilación con domótica;
  - cargador EV de 11 kW;
  - ventiloconvectores del 2° piso (C14) y exterior: luces, bodega y portón (C15).
- **Tableros:** TDA general + TDA-R de respaldo (salida backup del inversor: luces, refrigerador,
  bombas de agua, VMC y red siguen con corte de luz). Unilineal y cuadro de cargas en TAB-01.
- **Diferenciales:** 30 mA, con un máximo de 3 circuitos cada uno.
- **Iluminación:**
  - 2° centro de luz en el dormitorio principal (> 10 m²);
  - un interruptor independiente por centro.
- **Enchufes de baño fuera de la zona de ducha:**
  - en el P2 estaba dentro de la ducha;
  - en el P1 estaba a 0,5 m.
- **Detectores:** de humo interconectados, y térmico en la cocina.
- **Empalme:** trifásico, con DPS tipo 1+2 (línea aérea rural) y fases equilibradas.

### Sanitario
- **Pendiente de alcantarillado:** 3 % (antes 1 %).
- **Agua del pozo:** pasa por un estanque de 3.000 L y una presurizadora de velocidad variable en una caseta (RIDAA: la bomba aspira de un estanque).
- **Llaves de paso:** en cada recinto húmedo.
- **Agua fría/caliente fuera del radier:** por la cámara técnica de los muros y el entrepiso.
- **Cámara desgrasadora** en la salida de la cocina; tratamiento del pozo con filtro Fe/Mn si el análisis lo pide.

### Seguridad
- **Ventanas del P2:** antepecho de 1,00 m y limitador de apertura.
- **Escalera:** helicoidal Ø 1,80 m, barrotes < 10 cm, baranda 0,95 m y puertas de seguridad.
- **Faja CONAF:** de 2/10/30 m alrededor de la casa.
- **Cargador EV:** estacionamiento para 2 autos con el cargador.

### Estructura
- Se quitó el diseño de fundaciones.
- Ahora se entregan las cargas a la fundación (D, L, pilar, hold-down y corte basal) para quien las proyecte.

### Acústica y entrepiso
- El 2° piso no lleva piso radiante: entrepiso seco con piso flotante sobre lámina antiimpacto y
  cielo con canal resiliente (34 cm). El cielo del 1er piso queda a 2,36 m; el nivel del 2° piso no cambia.

### Terreno y exterior
- La casa va en un sector plano: sólo escarpe y base granular, sin corte ni relleno.
- Patio cercado para el perro, portón de acceso, senderos, bodega metálica a 10 m, luces exteriores,
  residuos y ductos enterrados (EXT-01).

### Muros
- Se agregó una cámara técnica de 40 mm, para que las instalaciones no perforen la barrera de vapor.
- Revestimiento interior de yeso-cartón RF (F-15).

## Pendiente de proyectos firmados
- Cálculo estructural definitivo (zona sísmica 3; NCh433:2026 rige desde ~feb-2027).
- Proyecto eléctrico TE1, solar TE4 y cargador TE6 (instalador SEC).
- Proyecto sanitario aprobado por la SEREMI de Salud.
- Mecánica de suelos (la hace quien proyecta las fundaciones).
- Prueba de hermeticidad (blower door) en obra.
- Memoria térmica y de condensación firmada para el permiso DOM.
