omaru-san/casa-freecad/normas/01_permisos_urbanismo_estructura/INDICE.md

# Normativa: permisos, urbanismo, térmica y estructura

**Proyecto:** vivienda unifamiliar de 2 pisos y unos 130 m², autoconstruida por etapas.
**Ubicación:** Puringue Pobre, comuna de Mariquina, Región de Los Ríos (rural, −39.47 / −73.00).
**Parámetros:** zona térmica **G** y zona sísmica **3**.
**Fecha de revisión:** 19-10-2026. Todos los PDF se descargaron de fuentes oficiales o institucionales gratuitas y se comprobó con `file` que son PDF válidos.

---

## 1. Ley y Ordenanza (texto actualizado)

| Archivo | Norma | Versión / fecha | Fuente |
|---|---|---|---|
| `2026_BCN_LGUC_DFL-458_texto-actualizado-2026-08-12.pdf` | LGUC, DFL 458 (V. y U.) 1975 | Versión 12-08-2026 (incluye Ley 21.718) | [LeyChile: DFL 458 LGUC](https://www.bcn.cl/leychile/navegar?idNorma=13560) |
| `2026_BCN_OGUC_DS-47_texto-actualizado-2026-10-02.pdf` | OGUC, DS 47 (V. y U.) 1992 | Versión 02-10-2026 (incluye DS 15 térmico y DS 10/2025), 332 págs. | [LeyChile: DS 47 OGUC](https://www.bcn.cl/leychile/navegar?idNorma=8201) |

**LGUC**
- **Art. 55 inc. 1°:** en el área rural solo se puede construir lo necesario para la explotación agrícola y **"las viviendas del propietario del mismo y sus trabajadores"**. Esta casa cabe en esa excepción.
- **Art. 116:** las obras rurales también requieren **permiso de la DOM**. La DOM emite el **Certificado de Informaciones Previas (CIP)** a petición del interesado.
- **Art. 118:** la DOM tiene **25 días hábiles** para resolver el permiso (15 si hay revisor independiente) y 15 para obras menores. A los 5 días hábiles sin declarar inadmisibilidad, la solicitud se entiende acogida a trámite. Si vence el plazo, puede invocarse el silencio administrativo negativo.
- **Art. 130:** derechos municipales de **1,5 % del presupuesto** para obra nueva o ampliación, y 1,0 % para obras menores o alteraciones. El presupuesto se calcula con la tabla de costos unitarios MINVU. Con 130 m² el monto es bajo, pero hay que provisionarlo.

**OGUC**
- **Art. 4.1.1:** altura mínima de piso a cielo de **2,30 m** en locales habitables (obra terminada) y 2,0 m bajo vigas.
- **Art. 4.1.2:** cada local habitable necesita al menos una ventana. En dormitorios se exige **1,5 m libres** frente a la ventana.
- **Art. 4.1.3:** baño o cocina sin ventana se ventila con un ducto de ≥ 0,16 m² que salga 1 m sobre la cubierta.
- **Art. 5.1.6:** expediente de obra nueva:
  - solicitud y FUN;
  - CIP;
  - formulario INE;
  - informe del arquitecto bajo declaración jurada (para una sola vivienda);
  - planos 1:50, cuadro de superficies y especificaciones técnicas que acrediten el art. 4.1.10;
  - levantamiento topográfico;
  - proyecto de cálculo estructural, cuando corresponda.

  En zona rural sin empresa sanitaria se agrega el **proyecto de agua potable y alcantarillado aprobado por la autoridad** (SEREMI de Salud). En vivienda, la acreditación térmica puede reemplazarse por el **Informe de Precalificación Energética** (CEV).
- **Art. 5.1.7:** el proyecto de cálculo estructural se exige sobre **100 m²**. Hay una excepción para las **clases C, D, E (madera) y F con carga de ocupación < 20 personas**, siempre que se declare que la obra se ejecuta según el **Título 5, Capítulo 6** (art. 5.6.1: solo para 1 y 2 pisos).
- **Arts. 5.6.7, 5.6.8 y 5.6.13 (madera sin cálculo):**
  - máximo **2 pisos** (incluida la mansarda) y **7 m** de altura;
  - humedad de la madera en zona Sur entre **12 % y 22 %**;
  - el **pino insigne es "no durable"** y debe ir **preservado según NCh 819**;
  - pilares de **95×95 mm**, o **145×145 mm** si cargan un 2° piso;
  - soleras ancladas al sobrecimiento con **acero liso de Ø6 mm cada ≤ 0,50 m**;
  - diafragmas unidos con **3 pernos de Ø8 mm** por piso;
  - arriostramiento de techumbre de **19×95 mm** como mínimo y peso propio de la techumbre **< 0,8 kPa**.
- **Art. 1.1.2:** una "obra menor" incluye ampliaciones sucesivas hasta **100 m²** en total. **Art. 5.1.4:** el permiso de obra menor se resuelve en 15 días con expediente simplificado. Esto es útil para crecer por etapas, aunque conviene pedir el permiso por los 130 m² completos desde el inicio.
- **Art. 5.3.1:** las clases de construcción son E (madera), C (albañilería confinada), etc. La clase determina tanto la excepción de cálculo como las exigencias contra fuego.

## 2. Área rural (art. 55 LGUC)

| Archivo | Norma | Versión / fecha | Fuente |
|---|---|---|---|
| `2021_MINVU_DDU-455_Recapitulativa-art55-LGUC-area-rural.pdf` | Circular DDU 455 (recapitulativa art. 55 y DL 3.516) | 18-01-2021 | [MINVU: circulares DDU, facultades y responsabilidades](https://www.minvu.gob.cl/elementos-tecnicos/circulares-division-de-desarrollo-urbano-ddu/facultades-y-responsabilidades) |
| `2019_MINVU_DDU-417_Aplicacion-art55-LGUC.pdf` | Circular DDU 417 | 12-04-2019 | [MINVU: construcciones en el área rural](https://www.minvu.gob.cl/elementos-tecnicos/circulares-division-de-desarrollo-urbano-ddu/construcciones-en-el-area-rural) |
| `2024_SAG_RE-8609_Tarifas-IFC.pdf` | SAG Res. Ex. 8.609/2024, tarifas del Informe de Factibilidad para Construcciones (IFC) | 2024 | [SAG: IFC](https://www.sag.gob.cl/ambitos-de-accion/informe-de-factibilidad-para-construcciones-ajenas-la-agricultura-en-area-rural-ifc) |

- **DDU 455 (pág. 5 y pág. 12):** para la **vivienda del propietario** (art. 55 inc. 1°), el permiso **NO requiere los informes favorables de la SEREMI MINVU ni del SAG** (incisos 3° y 4°). Se tramita "conforme a las reglas generales" ante la DOM, y tampoco aplica el art. 2.2.4 bis.
- **El IFC del SAG solo aplica** a construcciones ajenas a la agricultura: industria, equipamiento, turismo, poblaciones o viviendas de hasta 1.000 UF en conjunto. Por eso **no aplica a esta casa**. Se deja el documento de tarifas como referencia, por si la DOM lo pidiera; si lo hace, hay que citarle la DDU 455.
- **DL 3.516:** si el predio viene de una subdivisión rural, el lote mínimo es **0,5 ha**. Conviene confirmar en el CIP y en la inscripción de dominio que el lote es legal.

## 3. Ley 21.718 (agilización de permisos) y DS 10/2025 (declaraciones juradas)

| Archivo | Norma | Versión / fecha | Fuente |
|---|---|---|---|
| `2025_MINVU_PPT-Asistencia-Tecnica-Ley-21718.pdf` | Presentación MINVU sobre la Ley 21.718 | 15-05-2025 | [MINVU: asistencia técnica Ley 21.718](https://www.minvu.gob.cl/wp-content/uploads/2025/05/PPT-Asistencia-Tecnica-Ley-N°21.718.-15-de-mayo-2025.pdf) |
| `2025_MINVU_DDU-513_Ley21718-Grupo1.pdf` | DDU 513, normas del grupo 1 de la Ley 21.718 (vigentes desde 14-01-2025) | 10-01-2025 | [Colegio de Arquitectos: DDU 513](https://colegioarquitectos.com/noticias/wp-content/uploads/2025/06/DDU-513.pdf) |
| `2025_MINVU_DDU-525_Ley21718-Publicidad-permisos.pdf` | DDU 525, normas vigentes desde 30-05-2025 | 2025 | [MINVU: DDU 525](https://www.minvu.gob.cl/wp-content/uploads/2019/06/DDU-525.pdf) |
| `2026_MINVU_DS-10-2025_Tecnicas-habilitantes-alternativas_DO-2026-02-23.pdf` | DS 10 (V. y U.) 2025, que modifica la OGUC (declaraciones juradas) | DO 23-02-2026, vigente desde 25-04-2026 | [Diario Oficial: DS 10](https://www.diariooficial.interior.gob.cl/publicaciones/2026/02/23/44383/01/2768519.pdf) |
| `2026_MINVU_DDU-542_Tecnicas-habilitantes-alternativas-DS10-2025.pdf` | DDU 542, instrucciones sobre el DS 10 | 24-04-2026 | [MINVU: DDU 542](https://www.minvu.gob.cl/wp-content/uploads/2026/04/DDU-542.pdf) |
| `2026_MINVU_Indice-Circulares-DDU-hasta-548.pdf` | Índice de circulares DDU vigentes | 2026 | [MINVU: índice DDU hasta 548](https://www.minvu.gob.cl/wp-content/uploads/2019/06/INDICE-CIRCULARES-DDU-GENERALES-HASTA-DDU-548.pdf) |
| `2025_BCN_Ley-20898_Regularizacion-Autoconstruccion_texto-actualizado.pdf` | Ley 20.898 "Ley del Mono" (modificada por Ley 21.725) | Versión 01-03-2025 | [LeyChile: Ley 20.898](https://www.bcn.cl/leychile/navegar?idNorma=1087285) |

- **DDU 542, punto 5.1:** la declaración jurada de inicio de obras (sin permiso previo) es **obligatoria y taxativa**. Para vivienda solo cubre las obras con **subsidio DS 10/2015 de Habitabilidad Rural (tipología Construcción en Sitio del Residente)** y los casos de catástrofe. **Una casa con financiamiento propio sigue requiriendo permiso de edificación.**
- **Ampliaciones obra menor:** las que se financien con subsidio DS 10 también se habilitan con declaración jurada (OGUC art. 5.1.4 N°1).
- **Ley 20.898:** solo aplica a viviendas **construidas antes del 04-02-2016** con avalúo ≤ 1.000 UF (o ≤ 2.000 UF y 140 m² según el artículo). El plazo vence el 31-12-2027. **No sirve para regularizar después una casa nueva:** hay que tramitar el permiso desde el inicio. Además, la DDU 542 aclara que no se combina con la declaración jurada.
- **Ley 21.718:** plazos de 25 días hábiles para el permiso, examen de admisibilidad en 5 días, silencio negativo y publicación mensual de los permisos (art. 116 bis C).

## 4. Reglamentación térmica DS 15 (art. 4.1.10 OGUC, vigente desde 28-11-2025)

| Archivo | Norma | Versión / fecha | Fuente |
|---|---|---|---|
| `2024_MINVU_DS15_Modificacion-art-4110-OGUC_Reglamentacion-Termica.pdf` | DS 15 (V. y U.) 2021, publicado DO 27-05-2024 | Vigente desde 28-11-2025 | [MINVU: modificación art. 4.1.10 OGUC](https://www.minvu.gob.cl/wp-content/uploads/2024/10/Modificacion-art-4110-OGUC_Reglamentacion-Termica.pdf) |
| `2025_MINVU-DITEC_Actualizacion-Reglamentacion-Termica.pdf` | Presentación DITEC sobre las implicancias | 11-2025 | [MINVU: actualización RT DITEC](https://www.minvu.gob.cl/wp-content/uploads/2025/11/Actualizacion-RT_DITEC.pdf) |
| `2026_MINVU-DITEC_Art-4110-Exigencias-Residencial-Edu-Salud.pdf` | Presentación DITEC de exigencias residenciales | 01-2026 | [MINVU: exigencias art. 4.1.10](https://www.minvu.gob.cl/wp-content/uploads/2026/01/Art-4-1-10-OGUC_RES-EDU-SAL_DITEC.pdf) |
| `2025_MINVU-DITEC_Estandar-Puertas-y-Ventanas.pdf` | Presentación DITEC de puertas y ventanas | 11-2025 | [MINVU: puertas y ventanas](https://www.minvu.gob.cl/wp-content/uploads/2025/11/Puertas-y-Ventanas_DITEC-1.pdf) |
| `2025_MINVU-DITEC_Riesgo-Condensacion.pdf` | Presentación DITEC de condensación | 11-2025 | [MINVU: condensación](https://www.minvu.gob.cl/wp-content/uploads/2025/11/Condensacion_DITEC.pdf) |
| `2025_MINVU_DS-Res-Ex-1802_DO-2025-12-03.pdf` | Res. Ex. 1802/2025 (condiciones del cálculo de condensación) | DO 03-12-2025 | [Diario Oficial: Res. Ex. 1802](https://www.diariooficial.interior.gob.cl/publicaciones/2025/12/03/44315/01/2735266.pdf) |
| `2025_MINVU_Comunicado-Actualizacion-Normativa-Termica.pdf` | Comunicado "Qué debes saber" | 11-2025 | [MINVU: comunicado RT](https://www.minvu.gob.cl/wp-content/uploads/2025/11/COMUNICADO-R-TERMICA.pdf) |
| `2026_MINVU-DITEC_LOSCAT-Ed14_Listado-Oficial-Soluciones-Termicas.pdf` | **Listado Oficial de Soluciones Constructivas para Acondicionamiento Térmico (LOSCAT), Ed. 14 (vigente)** | 05-2026, 373 págs. | [MINVU DITEC: LOSCAT E14](https://www.minvu.gob.cl/wp-content/uploads/2026/04/LOSCAT_E14_MAYO_2026.pdf) |
| `2026_MINVU_Res-abre-inscripcion-Listado-Oficial-Termico_DO-2026-04-28.pdf` | Resolución que abre la inscripción en el LOSCAT 2026 | DO 28-04-2026 | [Diario Oficial: resolución LOSCAT](https://www.diariooficial.interior.gob.cl/publicaciones/2026/04/28/44436/01/2800829.pdf) |
| `2024_MINVU_Tabla-Zonas-Termicas-por-Comuna.pdf` | Tabla de zonas térmicas por comuna (confirma **Mariquina = G**) | 2024 | [Calificación Energética: tabla ZT](https://www.calificacionenergetica.cl/media/TABLA-ZT_REGIONES_PROVINCIAS-Y-COMUNAS.pdf) |
| `2024_MINVU_Plano-Zonificacion-Termica-Nacional.pdf` y `2024_MINVU_Mapa-Zonas-Termicas-Zona-Sur.pdf` | Planos de zonificación térmica (NCh1079) | 2024 | [MINVU: nueva reglamentación térmica](https://www.minvu.gob.cl/nueva-reglamentacion-termica/) |
| `2023_MINVU-DITEC_Oficio-1163_Estandar-higrotermico-FSEV.pdf` | Estándar higrotérmico para viviendas con subsidio FSEV (referencia de buenas prácticas) | 2023 | [MINVU: Oficio 1163](https://www.minvu.gob.cl/wp-content/uploads/2026/06/Oficio-Ord-1163-de-20-7-2023-de-DITEC.pdf) |

No existe un "manual de aplicación" oficial del MINVU. El Instituto de la Construcción publicó un "Manual Práctico para la Reglamentación Térmica 2025", pero no se encontró en descarga libre (ver "Por confirmar"). Las herramientas oficiales están en la [página de la nueva reglamentación térmica](https://www.minvu.gob.cl/nueva-reglamentacion-termica/) y son planillas `.xlsx` y `.zip` que no se descargaron:

- planilla de cálculo de U de ventanas;
- planilla de análisis higrotérmico v2026-07;
- planilla de condensaciones v2026.04.

**Exigencias para zona G (DS 15, Tablas 1 a 9):**
- **Transmitancia U máxima:**
  - techumbre **0,28 W/m²K** (Rt ≥ 3,57);
  - muros **0,40** (Rt ≥ 2,50);
  - piso ventilado **0,39** (Rt ≥ 2,56);
  - puertas opacas **1,70**.

  Si se cumple por aislante rotulado según NCh 2251 (Tabla 2), el R100 mínimo es: techumbre **357**, muros **250**, piso ventilado **256**. Por ejemplo, R100 = 250 equivale a unos 100 mm de lana mineral de λ 0,040.
- **Ventanas (Tabla 3, zona G):** porcentaje máximo de ventana sobre el muro según el U de la ventana. Con U ≤ 2,8 (PVC con DVH típico): **Norte 67 %, Oriente-Poniente 34 %, Sur 19 %**, OGT 21 %. Con U ≤ 2,0: N 74 %, O-P 38 %, S 24 %. En la columna U ≤ 5,8 (vidrio simple) el porcentaje permitido es **0 %**, así que **el vidrio simple queda prohibido**. Con U ≤ 4,4 se permite N 46 %, O-P 20 % y S 0 %. Alternativamente se puede usar Upvm (Tabla 5). Las ventanas de techo (inclinación ≤ 60°) deben tener **U ≤ 3,6 W/m²K**.
- **Sobrecimiento (Tabla 6):** aislante **R100 ≥ 91**, por el exterior, desde el nivel de piso terminado hasta 30 cm bajo el terreno o hasta el hombro de la fundación. El radier no exige aislación inferior.
- **Infiltración y ventilación:**
  - provincia de **Valdivia: clase de infiltración ≤ 5,0 ach a 50 Pa** (Tabla 7). En lotes de ≤ 10 viviendas puede reemplazarse el ensayo NCh 3295 por una **partida de sellos** en las especificaciones técnicas (encuentros de vanos, soleras, perforaciones, etc.);
  - ventanas y puertas con **clase 3 de permeabilidad al aire** (NCh 3297, Tabla 9);
  - ventilación según **NCh 3308**, con un informe de acreditación de la tasa.
- **Condensación (Res. 1802):** memoria según NCh 1973 con exterior **3,5 °C / 98 % HR** (zona G) e interior **19 °C / 75 % HR**. Se exige incluir los puentes térmicos y que el vapor que entre a la solución pueda salir al exterior.

## 5. Estructura y sismo (decretos gratuitos)

| Archivo | Norma | Versión / fecha | Fuente |
|---|---|---|---|
| `2011_BCN_DS-61_Diseno-Sismico-Edificios.pdf` | DS 61 (V. y U.) 2011, reglamento de diseño sísmico que complementa NCh433 | DO 13-12-2011 (vigente hasta que rija NCh433:2026) | [LeyChile: DS 61](https://www.bcn.cl/leychile/navegar?idNorma=1034101) |
| `2026_MINVU_DEx-28_oficializa-NCh433-2026_DO.pdf` | D. Ex. 28/2026, que oficializa **NCh433:2026** (y NCh223, NCh523, NCh723) | DO 10-08-2026, **rige desde ~10-02-2027** | [Diario Oficial: D. Ex. 28](https://www.diariooficial.interior.gob.cl/publicaciones/2026/08/10/44521/01/2850138.pdf) |
| `2024_MINVU_DEx-54_oficializa-NCh1198-2024-y-NCh3171_DO.pdf` | D. Ex. 54/2024, que oficializa **NCh1198:2024** (madera) y la nueva NCh3171 | DO 17-10-2024 (NCh1198 rige ~17-01-2025 y NCh3171 ~17-04-2025) | [Diario Oficial: D. Ex. 54](https://www.diariooficial.interior.gob.cl/publicaciones/2024/10/17/43975/01/2555768.pdf) |
| `2011_MINVU_DS-60_Diseno-Calculo-Hormigon-Armado.pdf` | DS 60 (V. y U.) 2011, requisitos de hormigón armado (complementa NCh430) | 2011 | [MINVU: DS 60](https://www.minvu.gob.cl/wp-content/uploads/2019/05/DECRETO-60-2011-DISEN%CC%83O-Y-CALCULO-HORMIGON-ARMADO.pdf) |

- **Zona sísmica 3:** A₀ = **0,40 g** (NCh433). El DS 61 fija la clasificación de suelo (A–E) por Vs30 y ensayos. Cualquier estructura con cálculo debe declarar zona y tipo de suelo, según OGUC 5.1.7 N°4.
- **Proyecto con permiso antes de febrero de 2027:** se calcula con **NCh433 Of.96 Mod.2009 + DS 61**. Si el permiso se ingresa después de **~10-02-2027**, rige **NCh433:2026**, que trae nueva clasificación de sitios y fallas activas. **Conviene ingresar el permiso antes de esa fecha** o diseñar ya con la 2026.
- **Madera calculada:** se rige por **NCh1198:2024** desde enero de 2025. Las combinaciones de carga, por la nueva **NCh3171**.
- **Fundaciones de hormigón armado (sobrecimientos, zapatas):** NCh430 + DS 60.

## 6. Manuales gratuitos de buenas prácticas

| Archivo | Documento | Versión | Fuente |
|---|---|---|---|
| `2004_CORMA-CTT_Viviendas-Madera_Cap1…Cap5_*.pdf` (5 archivos) | **"La Construcción de Viviendas en Madera"**, CORMA, Centro de Transferencia Tecnológica | ~2004 (PDF de 2016) | [Curriculum Nacional (Mineduc): Cap. I](https://www.curriculumnacional.cl/614/articles-89533_recurso_pdf.pdf), [Cap. II](https://www.curriculumnacional.cl/614/articles-89534_recurso_pdf.pdf), [Cap. III](https://www.curriculumnacional.cl/614/articles-89535_recurso_pdf.pdf), [Cap. IV](https://www.curriculumnacional.cl/614/articles-89536_recurso_pdf.pdf), [Cap. V](https://www.curriculumnacional.cl/614/articles-89537_recurso_pdf.pdf) |
| `2021_CIM-UC_Manual-Diseno-Estructuras-en-Madera.pdf` | Manual de Diseño de Estructuras en Madera, CIM UC (v8) | 2021 | [CIM UC: manual de diseño](https://madera.uc.cl/images/recursos/manual-de-diseno-de-estructuras-en-madera.pdf) |
| `2021_CIM-UC_Manual-Soluciones-Constructivas-Edificaciones-Madera.pdf` | Manual de Soluciones Constructivas de entramado ligero, CIM UC | 2021 | [CIM UC: soluciones constructivas](https://madera.uc.cl/images/recursos/manual-de-soluciones-constructivas-para-edificaciones-en-madera.pdf) |
| `2026_CIM-UC-CENAMAD_Manual-Preservacion-Madera-TomoII.pdf` | Manual de Preservación de la Madera, Tomo II (75 MB) | 2026 | [Diseña Madera: manual de preservación](https://www.disenamadera.cl/Documentos%20y%20Guias/Manual_Preservacion_madera-Proteccion_de_Madera.pdf) |
| `2025_MINVU_Recomendaciones-Edificaciones-Suelos-Organicos-Sur-de-Chile.pdf` | Recomendaciones para edificaciones en **suelos orgánicos del sur de Chile** (ñadis, turbas, hualves; incluye Los Ríos) | 2025 | [MINVU: manuales técnicos DITEC](https://www.minvu.gob.cl/ditec/manuales-tecnicos-ditec/) |
| `2025_MINVU_Manual-Estudio-Suelos-Licuables.pdf` | Manual de estudio de suelos licuables | 2025 | [MINVU: manuales técnicos DITEC](https://www.minvu.gob.cl/ditec/manuales-tecnicos-ditec/) |
| `2025_MINVU_Caracterizacion-Analisis-Geotecnico-Mejoramiento-Suelos.pdf` | Caracterización y análisis geotécnico y mejoramiento de suelos | 2025 | [MINVU: manuales técnicos DITEC](https://www.minvu.gob.cl/ditec/manuales-tecnicos-ditec/) |
| `2018_MINVU_Manual-Control-de-Calidad-de-Obra.pdf` | Manual de Control de Calidad de Obra | 2018 | [MINVU: control de calidad de obra](https://csustentable.minvu.gob.cl/wp-content/uploads/2018/04/MANUAL-DE-CONTROL-DE-CALIDAD-DE-OBRA.pdf) |

- **CORMA (Caps. II y IV):**
  - entramados de pino radiata;
  - fundaciones aisladas de la humedad, con solera de montaje sobre barrera;
  - escuadrías típicas para 2 pisos;
  - cubiertas y revestimientos con cámara ventilada.

  Es el texto base para la autoconstrucción en madera.
- **Suelos orgánicos MINVU (cap. 1.4.1, Los Ríos):** en la zona de Valdivia y Mariquina son frecuentes los **ñadis, hualves y turbas**. Recomienda calicata y retiro del suelo orgánico antes de fundar. Es especialmente relevante en Puringue, cerca del río Cruces y de vegas.
- **Preservación:** el pino radiata estructural en contacto con el suelo o al exterior debe tener tratamiento CCA/CA según NCh 819, con la categoría de riesgo que corresponda (UC3 o UC4). Esto se vincula con el art. 5.6.8 de la OGUC.

---

## Normas pagadas / no descargadas

Las NCh del INN se venden. **No se descargaron copias no oficiales.** Se pueden comprar en la [tienda INN](https://ecommerce.inn.cl/search?q=NCh), y el INN tiene además una modalidad de visualización. El art. 2° de la LGUC obliga a publicarlas gratis: el MINVU las muestra en su visor oficial [Listado de Normas Técnicas Obligatorias](https://normastecnicas.minvu.cl/) (solo lectura en pantalla, sin descarga). Ver [05_NCh_INN](../05_NCh_INN/INDICE.md).

| Norma | Tema | Link |
|---|---|---|
| NCh433 Of.1996 Mod.2009 / **NCh433:2026** | Diseño sísmico de edificios | [INN: NCh433](https://ecommerce.inn.cl/search?q=NCh433) |
| **NCh1198:2024** | Madera, construcciones en madera, cálculo | [INN: NCh1198](https://ecommerce.inn.cl/search?q=NCh1198) |
| NCh1537:2009 | Cargas permanentes y sobrecargas de uso (vivienda ≈ 2,0 kPa, verificar) | [INN: NCh1537](https://ecommerce.inn.cl/search?q=NCh1537) |
| NCh3171 (vigente desde 2025) | Combinaciones de carga | [INN: NCh3171](https://ecommerce.inn.cl/search?q=NCh3171) |
| NCh430:2008 | Hormigón armado | [INN: NCh430](https://ecommerce.inn.cl/search?q=NCh430) |
| NCh432 / NCh431 | Viento / nieve | [INN: NCh432](https://ecommerce.inn.cl/search?q=NCh432), [INN: NCh431](https://ecommerce.inn.cl/search?q=NCh431) |
| NCh1207 / NCh1989 / NCh1970 | Pino radiata: clasificación visual y grados estructurales | [INN: NCh1207](https://ecommerce.inn.cl/search?q=NCh1207) |
| NCh819 / NCh789-1 | Preservación y durabilidad natural de la madera | [INN: NCh819](https://ecommerce.inn.cl/search?q=NCh819) |
| NCh1508 | Estudio de mecánica de suelos | [INN: NCh1508](https://ecommerce.inn.cl/search?q=NCh1508) |
| NCh853 / NCh1973 / NCh2251 / NCh1079 | Cálculo de U, condensación, rotulado de aislantes y zonificación | [INN: NCh853](https://ecommerce.inn.cl/search?q=NCh853) |
| NCh3295 / NCh3296 / NCh3297 / NCh3308 | Hermeticidad, permeabilidad de ventanas y ventilación | [INN: NCh3308](https://ecommerce.inn.cl/search?q=NCh3308) |

**Otros documentos gratuitos que no se pudieron descargar:**
- **CDT:** [Manual de Tolerancias para Edificaciones (2009)](https://cdt.cl/download/76541), [Condensación superficial (Ed. Técnicas N° 26)](https://cdt.cl/download/77003) y [Condensación intersticial (N° 27)](https://cdt.cl/download/77004). Son gratuitos pero exigen **iniciar sesión en cdt.cl** (el servidor devuelve HTML de login).
- **Planillas MINVU (.xlsx / .zip, no son PDF):** [cálculo de U de ventanas](https://www.minvu.gob.cl/wp-content/uploads/2025/11/Calculo-U-Ventanas-DITEC-V.2024.1.0.xlsx), [análisis higrotérmico](https://www.minvu.gob.cl/wp-content/uploads/2026/07/Analisis-higrotermico-v2026-07-13.zip) y [condensaciones](https://www.minvu.gob.cl/wp-content/uploads/2026/07/Condensaciones_DITEC_V2026.04.zip).
- **SAG:** [formulario de solicitud del IFC 2026 (.docx)](https://www.sag.gob.cl/sites/default/files/Solicitud_de_ifc_2026.docx), que no aplica a vivienda del propietario.
- **Listado de fuego (pertenece a la carpeta 04):** [LOFC Ed. 17 2025](https://www.minvu.gob.cl/wp-content/uploads/2025/02/00_Listado-Oficial-de-Comportamiento-al-Fuego-de-Elementos-y-Componentes-de-la-Construccion_-ED17-2025-NVO.pdf).
- **Ley 21.718 (texto original):** no se obtuvo la exportación en LeyChile. Su contenido ya está incorporado en la LGUC actualizada (art. 116, 116 bis C, 118, 144 bis, etc.).

## Por confirmar

1. **CIP en la DOM de Mariquina:** confirmar que Puringue Pobre está fuera del límite urbano y que no lo afecta un plan intercomunal, zona de riesgo (inundación por el río Cruces o el Mehuín) ni franja de restricción. También pedir las normas de distanciamiento y rasantes que aplicarán.
2. **Dominio del predio:** confirmar que el terreno está a nombre de quien construye. Así se encuadra como "vivienda del propietario" (art. 55 inc. 1°). Si es parcela del DL 3.516, verificar que el lote tiene ≥ 0,5 ha y que la subdivisión fue certificada por el SAG.
3. **Excepción de cálculo:** decidir si se usa la excepción del art. 5.1.7 (madera clase E, sin cálculo, ≤ 2 pisos y 7 m, ejecución según Tít. 5 Cap. 6) o si se encarga un cálculo a un ingeniero, que es lo recomendable en zona 3 con suelo blando u orgánico. Verificar el criterio de la DOM de Mariquina, porque algunas DOM exigen cálculo sobre 100 m² de todos modos.
4. **Fecha de ingreso del permiso frente a NCh433:2026** (rige ~10-02-2027): hay que definir con qué versión se calcula.
5. **Subsidio DS 10 Habitabilidad Rural:** si la familia postula, la obra se habilita por **declaración jurada** en vez de permiso (DDU 542) y los plazos cambian. Ver la carpeta 04 (subsidios).
6. **Precalificación energética (CEV)** en lugar de la memoria térmica completa: evaluar su costo frente a usar soluciones del LOSCAT E14 para zona G.
7. **"Manual Práctico para la Reglamentación Térmica 2025"** (Instituto de la Construcción y CChC): no se encontró una descarga libre oficial.
8. **Proyecto de ley de parcelaciones rurales** (que modifica el art. 55) y **boletines 18189/18163** (que extienden la Ley del Mono): siguen en tramitación a 10-2026 y no están vigentes.
9. **Sobrecarga de uso NCh1537** (≈ 2,0 kPa en vivienda), **viento NCh432** y **nieve NCh431** en Mariquina: verificar los valores en la norma comprada.
