omaru-san/casa-freecad/normas/05_NCh_INN/INDICE.md

# 05 · Normas chilenas NCh (INN): acceso legítimo y gratuito

Revisado el 20-10-2026 para la casa de Puringue Pobre (Mariquina, Los Ríos), en zona térmica **G** y zona sísmica **3**.

## Resumen

- **Hay un visor oficial y gratuito de las NCh obligatorias:** [MINVU: Listado de Normas Técnicas Obligatorias](https://normastecnicas.minvu.cl/). Existe porque el **art. 2° de la LGUC** obliga a publicar en internet, gratis, las normas técnicas obligatorias. Se sostiene en el convenio INN–MINVU (D. Ex. 315 del 30-12-2015). Tiene **228 registros**, entre ellos NCh433, NCh1198:2024, NCh1537, NCh432, NCh431, NCh3171, NCh819, NCh853, NCh1079, NCh1973, NCh3308, NCh3309, NCh3295/3296, NCh1928, NCh2123, NCh170 y NCh935.
  - **Solo permite ver las páginas, no descargarlas.** Cada página es una imagen con la marca de agua *"USO EXCLUSIVO – Convenio vigente entre INN y MINVU (Decreto Exento 315 del 30/12/2015) (PROHIBIDO LA REPRODUCCIÓN)"*. La portada dice además *"Prohibida reproducción y venta"*.
  - Por eso **no se armaron PDF a partir de esas imágenes**: sería reproducir el texto contra lo que dice la marca. Las normas se consultan en línea.
  - Esto corrige la nota de `01_permisos_urbanismo_estructura/INDICE.md`, que decía que no se había encontrado un visor oficial.
- **Se descargó 1 PDF oficial:** la NCh Elec. 4/2003, publicada por la propia SEC. Ya **no rige**: la reemplazaron el DS 8/2019 y los pliegos RIC, que están en `02_electrico_solar_domotica`. Se guarda como referencia histórica.
- **Proyectos de norma (prNCh) en consulta pública:** se revisó el [portal de consulta pública del INN](https://www.consultapublica.cl/) el 20-10-2026. **No hay ninguno abierto**: la búsqueda en los comités de Ingeniería Estructural, Madera, Comportamiento térmico, Especialidades y Materiales de construcción responde "No existen registros". El proyecto prNCh433 ya terminó su trámite: el INN aprobó la **NCh433:2026** y el D. Ex. 28/2026 la oficializó. Ese decreto está en la carpeta 01.
- **Copias no autorizadas (no se descargaron):** hay copias de NCh433 Mod 2009 en Scribd, de NCh409 en studylib y en ciperchile.cl, y de NCh Elec 4/2003 en un espejo del Banco Mundial (ESMAP RISE). En el último caso se usó la copia original de la SEC.

## Archivos descargados

| Archivo | Norma | Fuente | Verificación |
|---|---|---|---|
| `NChElec4_2003_SEC_Instalaciones-consumo-baja-tension.pdf` | NCh Elec. 4/2003, *Instalaciones de consumo en baja tensión* (SEC, oct. 2003). **Derogada** por el DS 8/2019 y los RIC. | [SEC: NCh Elec. 4/2003 completa](https://www.sec.cl/sitioweb/electricidad_norma4/norma4_completa.pdf) | PDF 1.5, 175 páginas, 3,9 MB |

## Tabla de normas

Estados posibles:
- **visor MINVU gratis:** se lee gratis en línea en el visor oficial, pero no se puede descargar;
- **solo pagada:** se vende en la tienda INN y no está en el visor MINVU;
- **descargada:** se bajó un PDF oficial.

Los precios son los de la [tienda INN](https://ecommerce.inn.cl/normas-chilenas), en formato "Visualización con impresión", con IVA incluido, consultados el 20-10-2026.

| Norma | Versión | Estado | Fuente | Precio INN aprox. |
|---|---|---|---|---|
| NCh433 Diseño sísmico de edificios | Of.1996 Mod.2009 (oficial; rige con DS 61 hasta ~10-02-2027) | visor MINVU gratis (con D. 406/2010 como anexo) | [MINVU: Normas Técnicas Obligatorias](https://normastecnicas.minvu.cl/) | [INN: NCh433:1996 Mod 2009](https://ecommerce.inn.cl/nch4331996-mod-200945350) $67.830 (no vigente en INN) |
| NCh433 Diseño sísmico de edificios | **2026** (oficializada por D. Ex. 28/2026) | solo pagada (aún no está en el visor) | [INN: NCh433:2026](https://ecommerce.inn.cl/nch433202688560) | $89.250 |
| prNCh433 (proyecto 2022–2025) | — | consulta cerrada, reemplazada por la NCh433:2026 | [INN: Sistema de Consultas Públicas](https://www.consultapublica.cl/) | — |
| NCh1198 Madera, cálculo | 2024 | visor MINVU gratis | [MINVU: Normas Técnicas Obligatorias](https://normastecnicas.minvu.cl/) | [INN: NCh1198:2024](https://ecommerce.inn.cl/nch1198202488155) $97.580 |
| NCh1537 Cargas permanentes y de uso | 2009 | visor MINVU gratis | [MINVU: Normas Técnicas Obligatorias](https://normastecnicas.minvu.cl/) | [INN: NCh1537:2009](https://ecommerce.inn.cl/nch1537200945398) $55.930 |
| NCh432 Viento | Of.1971 (la versión que figura como oficial en el visor) | visor MINVU gratis | [MINVU: Normas Técnicas Obligatorias](https://normastecnicas.minvu.cl/) | [INN: NCh432:2025](https://ecommerce.inn.cl/nch432202588539) $97.580 (vigente en INN, pero aún no oficializada) |
| NCh431 Nieve | 2010 | visor MINVU gratis | [MINVU: Normas Técnicas Obligatorias](https://normastecnicas.minvu.cl/) | [INN: NCh431:2010](https://ecommerce.inn.cl/nch431201045605) $47.600 |
| NCh3171 Combinaciones de carga | 2017 | visor MINVU gratis | [MINVU: Normas Técnicas Obligatorias](https://normastecnicas.minvu.cl/) | [INN: NCh3171:2017](https://ecommerce.inn.cl/nch3171201760757) $42.840 |
| NCh819 Madera preservada, pino radiata | 2019 | visor MINVU gratis | [MINVU: Normas Técnicas Obligatorias](https://normastecnicas.minvu.cl/) | [INN: NCh819:2019](https://ecommerce.inn.cl/nch819201968329) $45.220 |
| NCh1207 / NCh1970-2 / NCh1989 / NCh1990 Clasificación y tensiones de la madera | 2024 / 2017 | visor MINVU gratis | [MINVU: Normas Técnicas Obligatorias](https://normastecnicas.minvu.cl/) | — |
| NCh853 Resistencia y transmitancia térmica | 2021 | visor MINVU gratis | [MINVU: Normas Técnicas Obligatorias](https://normastecnicas.minvu.cl/) | [INN: NCh853:2021](https://ecommerce.inn.cl/nch853202179509) $89.250 |
| NCh1079 Zonificación climática y térmica | 2019 | visor MINVU gratis | [MINVU: Normas Técnicas Obligatorias](https://normastecnicas.minvu.cl/) | [INN: NCh1079:2019](https://ecommerce.inn.cl/nch10792019-es74937) $89.250 |
| NCh1973 Condensación (higrotérmico) | 2014 | visor MINVU gratis | [MINVU: Normas Técnicas Obligatorias](https://normastecnicas.minvu.cl/) | [INN: NCh1973:2014](https://ecommerce.inn.cl/nch1973201445963) $67.830 |
| NCh2251 Rotulado de aislantes térmicos | 2010 | visor MINVU gratis | [MINVU: Normas Técnicas Obligatorias](https://normastecnicas.minvu.cl/) | [INN: NCh2251:2010](https://ecommerce.inn.cl/nch2251201045658) $26.180 |
| NCh2457 / NCh3117 / NCh3136 / NCh3137 Vapor, suelo, puentes térmicos y ventanas | 2014–2018 | visor MINVU gratis | [MINVU: Normas Técnicas Obligatorias](https://normastecnicas.minvu.cl/) | — |
| NCh3308 Ventilación, calidad de aire interior | 2024 | visor MINVU gratis | [MINVU: Normas Técnicas Obligatorias](https://normastecnicas.minvu.cl/) | [INN: NCh3308:2024](https://ecommerce.inn.cl/nch3308202488313) $97.580 |
| NCh3309 Ventilación en edificios residenciales | 2022 | visor MINVU gratis | [MINVU: Normas Técnicas Obligatorias](https://normastecnicas.minvu.cl/) | [INN: NCh3309:2022](https://ecommerce.inn.cl/nch3309202277032) $55.930 |
| NCh3295 Hermeticidad (ensayo blower door) | 2013 | visor MINVU gratis | [MINVU: Normas Técnicas Obligatorias](https://normastecnicas.minvu.cl/) | [INN: NCh3295:2013](https://ecommerce.inn.cl/nch3295201345855) $55.930 |
| NCh3296 / NCh3297 Permeabilidad al aire de puertas y ventanas | 2013 | visor MINVU gratis | [MINVU: Normas Técnicas Obligatorias](https://normastecnicas.minvu.cl/) | [INN: NCh3296:2013](https://ecommerce.inn.cl/nch3296201345940) $26.180 |
| NCh888 Ventanas, requisitos generales | 2000 | solo pagada (el visor sí tiene NCh523, NCh890, NCh1972 y NCh2434) | [INN: NCh888:2000](https://ecommerce.inn.cl/nch888200041938) | $45.220 |
| NCh2485 Agua potable domiciliaria, diseño interior | 2000 | solo pagada | [INN: NCh2485:2000](https://ecommerce.inn.cl/nch2485200041601) | $45.220 |
| NCh3371 Alcantarillado domiciliario, diseño y cálculo | 2017 | solo pagada | [INN: NCh3371:2017](https://ecommerce.inn.cl/nch3371201749030) | $55.930 |
| NCh1105 Alcantarillado de aguas servidas, diseño | 2019 | solo pagada | [INN: NCh1105:2019](https://ecommerce.inn.cl/nch1105201971706) | $45.220 |
| NCh2592 Uniones domiciliarias de alcantarillado de PVC | 2019 | solo pagada | [INN: NCh2592:2019](https://ecommerce.inn.cl/nch2592201973464) | $47.600 |
| NCh691 Agua potable: producción, conducción y distribución | 2015 | solo pagada | [INN: NCh691:2015](https://ecommerce.inn.cl/nch691201547026) | $45.220 |
| NCh409/1 y /2 Calidad del agua potable | 2005 / 2004 | solo pagada (la SISS la deja consultar solo en su Centro de Documentación, sin reproducirla) | [SISS: Normas técnicas](https://www.siss.gob.cl/586/w3-propertyvalue-6375.html) | [INN: NCh409/1:2005](https://ecommerce.inn.cl/nch4091200545041) $42.840 |
| NCh935/1 a /3 Resistencia al fuego | 1997 / 1984 / 2013 | visor MINVU gratis | [MINVU: Normas Técnicas Obligatorias](https://normastecnicas.minvu.cl/) | [INN: NCh935/1:1997](https://ecommerce.inn.cl/nch9351199742655) $55.930 |
| NCh Elec. 4/2003 Instalaciones de consumo en baja tensión | 2003 (derogada) | **descargada** | [SEC: NCh Elec. 4/2003](https://www.sec.cl/sitioweb/electricidad_norma4/norma4_completa.pdf) | — (publicación SEC) |
| NCh2369 Diseño sísmico industrial | 2025 | visor MINVU gratis (no aplica a vivienda) | [MINVU: Normas Técnicas Obligatorias](https://normastecnicas.minvu.cl/) | [INN: NCh2369:2025](https://ecommerce.inn.cl/nch2369202587953) $97.580 |
| NCh1928 Albañilería armada | 1993 Mod.2009 | visor MINVU gratis | [MINVU: Normas Técnicas Obligatorias](https://normastecnicas.minvu.cl/) | [INN: NCh1928](https://ecommerce.inn.cl/nch19281993-modificaci%C3%B3n-200945058) $89.250 |
| NCh2123 Albañilería confinada | 1997 Mod.2003 | visor MINVU gratis | [MINVU: Normas Técnicas Obligatorias](https://normastecnicas.minvu.cl/) | [INN: NCh2123](https://ecommerce.inn.cl/nch21231997-mod-200344449) $55.930 |
| NCh170 Hormigón, requisitos generales | 2016 | visor MINVU gratis | [MINVU: Normas Técnicas Obligatorias](https://normastecnicas.minvu.cl/) | [INN: NCh170:2016](https://ecommerce.inn.cl/nch170201658328) $67.830 |
| NCh430 Hormigón armado | 2008 | visor MINVU gratis | [MINVU: Normas Técnicas Obligatorias](https://normastecnicas.minvu.cl/) | — |

**Nota sobre NCh2485 y NCh3371:** la NCh2485 es la norma de **agua potable** interior y la NCh3371 la de **alcantarillado** domiciliario. Ninguna trata de aguas lluvia. Para la casa, el reglamento que manda es el **RIDAA (DS 50/2002)**, que está en la carpeta 03 y transcribe gran parte de los criterios.

## Cómo acceder gratis

1. **Visor MINVU en línea (la vía principal).** Entrar a [MINVU: Listado de Normas Técnicas Obligatorias](https://normastecnicas.minvu.cl/) y buscar por código, por ejemplo "NCh1537". No pide registro.
   - Cada norma muestra además el **decreto que la oficializa** como anexo.
   - Se lee en pantalla. Las páginas llevan marca de agua de **uso exclusivo y prohibida la reproducción**: se pueden consultar y tomar notas, pero no redistribuir.
2. **Centro de Consulta Digital del INN, presencial.** Según las [FAQ del INN](https://www.inn.cl/faqs), las normas "pueden consultarse sin costo" en sala.
   - Dirección: Av. Libertador Bernardo O'Higgins 1449, Torre 7, piso 16, Santiago (Santiago Downtown). Teléfono +56 2 2445 8800.
   - Sirve para las normas que **no** están en el visor MINVU: NCh433:2026, NCh2485, NCh3371, NCh1105, NCh691, NCh409 y NCh888. Conviene llamar antes para confirmar horario.
3. **SISS, Centro de Documentación.** Permite consultar en sala las normas sanitarias (NCh409, NCh691, NCh1105, etc.), sin reproducirlas ([SISS: Normas técnicas](https://www.siss.gob.cl/586/w3-propertyvalue-6375.html)).
4. **Proyectos de norma en consulta pública.** En el [INN: Sistema de Consultas Públicas](https://www.consultapublica.cl/) se pueden leer y comentar gratis mientras están abiertos. El 20-10-2026 no había ninguno abierto. Hay que revisarlo periódicamente, porque ahí aparecerán las futuras revisiones de NCh1537, NCh853, etc.
5. **Prevención de incendios.** El INN indica que gran parte de las 34 NCh de protección contra incendio están gratis en el MINVU gracias al convenio ([INN: Normas vinculadas a la prevención de incendios](https://www.inn.cl/contenedor-de-noticias/normas-chilenas-vinculadas-a-la-prevencion-de-incendios/)). En la práctica están en el mismo visor.
6. **Profesionales del proyecto.** El calculista, el arquitecto y el proyectista sanitario deberían tener sus normas compradas. Se les puede pedir que citen en la memoria los valores usados.

## Datos técnicos clave que sí son públicos

Son valores que aparecen escritos en reglamentos oficiales gratuitos, y en esta casa sirven en lugar de la NCh. Los PDF están en las carpetas 01 a 03.

**Sismo (DS 61/2011 + NCh433 Of.96 Mod.2009, hasta ~10-02-2027):**
- Mariquina está en **zona sísmica 3**, con **A₀ = 0,40 g**.
- **El DS 61** clasifica el suelo de fundación en tipos A a E según Vs30 y fija los parámetros de cada tipo:

  | Tipo | S | T₀ | T' | n | p |
  |---|---|---|---|---|---|
  | A | 0,90 | 0,15 | 0,20 | 1,00 | 2,0 |
  | B | 1,00 | 0,30 | 0,35 | 1,33 | 1,5 |
  | C | 1,05 | 0,40 | 0,45 | 1,40 | 1,6 |
  | D | 1,20 | 0,75 | 0,85 | 1,80 | 1,0 |
  | E | 1,30 | 1,20 | 1,35 | 1,80 | 1,0 |

  En el PDF de LeyChile esa tabla viene como imagen: hay que verificarla. Los suelos orgánicos y turbas (ñadis) quedan **fuera de clasificación** y requieren estudio especial.
- **Exención de Vs30 in situ:** no es obligatorio medir Vs30 en estructuras de menos de 500 m², de no más de 2 pisos y menos de 8 m de altura (DS 61, art. 6). En ese caso basta el estudio de mecánica de suelos según NCh1508:2008.
- **Desde ~10-02-2027 rige la NCh433:2026** (D. Ex. 28/2026, carpeta 01).

**Madera sin cálculo (OGUC art. 5.1.7 y Título 5 Cap. 6):**
- Una vivienda de madera de hasta 2 pisos y 7 m puede construirse **sin cálculo estructural**, siguiendo las disposiciones prescriptivas de la OGUC: escuadrías, espaciamientos y anclajes.
- En esos casos la OGUC reemplaza a la NCh1198. El pino radiata debe ir **preservado según NCh819** cuando el riesgo lo exige (UC3 o UC4 en contacto con suelo o al exterior).

**Térmica, zona G (OGUC art. 4.1.10, texto del DS 15 de 2024):**
- **U máxima:** techumbre **0,28 W/m²K**; piso ventilado **0,39 W/m²K**. Los muros están en la tabla de la carpeta 01.
- **R100 mínimo de aislantes rotulados (NCh2251):** techumbre 357, muros 250, piso ventilado 256.
- **Ventanas:** el vidrio simple queda prohibido (0 % con U ≤ 5,8). Con U ≤ 2,8 se permite N 67 %, O-P 34 % y S 19 %. Las ventanas de techo deben tener U ≤ 3,6.
- **Infiltración:** en la provincia de Valdivia, **≤ 5,0 renovaciones por hora a 50 Pa** (Tabla 7). En lotes de 10 viviendas o menos, el ensayo NCh3295 puede reemplazarse por una partida de sellos.
- **Ventanas y puertas:** **clase 3** de permeabilidad al aire (NCh3297).
- **Ventilación:** según **NCh3308**, con su informe de tasa.
- **Condensación (Res. Ex. 1802/2025):** se calcula según NCh1973 con exterior **3,5 °C / 98 % HR** e interior **19 °C / 75 % HR**, incluyendo los puentes térmicos.
- **Alternativa sin cálculo:** usar soluciones del **LOSCAT Ed. 14** (carpeta 01). Así no se necesitan NCh853 ni NCh1973 para acreditar.

**Electricidad:** el DS 8/2019 y los RIC 01 a 19 de la SEC (carpeta 02) **reemplazan íntegramente** a la NCh Elec. 4/2003. Todos son gratuitos.

**Agua y alcantarillado:** el RIDAA (DS 50/2002) fija dotaciones, presiones y diámetros mínimos de instalaciones domiciliarias, y el DS 236 regula la fosa séptica y el drenaje. Ambos están en la carpeta 03 y bastan para el proyecto sanitario rural sin comprar NCh2485 ni NCh3371.

**Cargas, viento y nieve:** **no hay valores públicos** que reemplacen a NCh1537, NCh432 o NCh431. Se pueden leer **gratis en el visor MINVU**. Por ejemplo, la sobrecarga de uso de vivienda (≈ 2,0 kPa) hay que confirmarla ahí.

## Por confirmar

- Que el visor MINVU incorpore la NCh433:2026 y la NCh432:2025 cuando se oficialicen. Por ahora muestra NCh433 Of.96 Mod.2009 y NCh432 Of.71.
- El horario y las condiciones del Centro de Consulta Digital del INN: la página de FAQ no los publica.
