omaru-san/casa-freecad/normas/02_electrico_solar_domotica/INDICE.md

# Índice: normativa eléctrica, solar FV, electromovilidad y domótica

Casa rural en Puringue Pobre (Mariquina, Región de Los Ríos). Tiene 2 pisos y unos 130 m². Considera bomba de calor aire-agua con piso radiante, bomba de calor para agua caliente, FV on-grid de 3,6 kWp que pasa a 7,2 kWp (net billing), cargador de auto eléctrico y domótica.

Revisado el 19 y 20 de octubre de 2026. Todos los PDF se descargaron de fuentes oficiales: SEC, BCN/LeyChile, Diario Oficial, SAESA y Subtel. Se verificó con `file` que cada uno es un PDF real.

> **Ojo con la numeración de los RIC.** En el encargo, RIC 12 aparece como "autogeneración/respaldo" y RIC 11 como "baños". La numeración oficial es otra:
> - RIC 09 es Sistemas de autogeneración.
> - RIC 11 es Instalaciones especiales; los baños están en su sección 6 y la domótica en su sección 22.
> - RIC 12 es Ambientes explosivos.
> - RIC 15 es Infraestructura de recarga de vehículos eléctricos (IRVE).

---

## 1. Reglamento de instalaciones de consumo (DS 8/2019) y pliegos RIC

Los pliegos fueron dictados por la Res. Ex. SEC 33.877 (30-12-2020), publicada en el Diario Oficial el 12-01-2021. Rigen desde el 12-07-2021. Las versiones de abajo son las que la SEC publica como vigentes en su [página de Pliegos Técnicos RIC](https://www.sec.cl/pliegos-tecnicos-ric/) a octubre de 2026.

| Archivo | Norma | Versión/fecha | Fuente |
|---|---|---|---|
| `2019_Energia_DS-8_Reglamento-seguridad-instalaciones-consumo.pdf` | DS 8/2019 Min. Energía, Reglamento de Seguridad de las Instalaciones de Consumo de Energía Eléctrica | 31-01-2019 | [SEC – Reglamento DS 8](https://www.sec.cl/reglamento-de-seguridad-de-las-instalaciones-de-consumo-de-energia-electrica-decreto-08/) |
| `2020_SEC_ResEx-33877_Dicta-pliegos-RIC.pdf` / `2021_SEC_ResEx-33877_Diario-Oficial.pdf` | Res. Ex. 33.877, que dicta los pliegos RIC 01 a 19 | 30-12-2020 / DO 12-01-2021 | [SEC – Reglamento DS 8](https://www.sec.cl/reglamento-de-seguridad-de-las-instalaciones-de-consumo-de-energia-electrica-decreto-08/) |
| `2020_SEC_RIC-01_Empalmes.pdf` | RIC N°01 Empalmes | 2020 | [SEC – Pliegos RIC](https://www.sec.cl/pliegos-tecnicos-ric/) |
| `2021_SEC_RIC-02_Tableros-electricos.pdf` | RIC N°02 Tableros eléctricos | rev. 17-06-2021 | [SEC – Reglamento DS 8](https://www.sec.cl/reglamento-de-seguridad-de-las-instalaciones-de-consumo-de-energia-electrica-decreto-08/) |
| `2021_SEC_RIC-03_Alimentadores-y-demanda-V1.1.pdf` | RIC N°03 Alimentadores y demanda | V1.1 (03-2021) | [SEC – Pliegos RIC](https://www.sec.cl/pliegos-tecnicos-ric/) |
| `2020_SEC_RIC-04_Conductores-y-canalizaciones.pdf` | RIC N°04 Conductores, materiales y canalizaciones | 2020 | [SEC – Pliegos RIC](https://www.sec.cl/pliegos-tecnicos-ric/) |
| `2020_SEC_RIC-05_Medidas-de-proteccion.pdf` | RIC N°05 Medidas de protección contra tensiones peligrosas | 2020 | [SEC – Pliegos RIC](https://www.sec.cl/pliegos-tecnicos-ric/) |
| `2020_SEC_RIC-06_Puesta-a-tierra.pdf` | RIC N°06 Puesta a tierra y enlace equipotencial | 2020 | [SEC – Pliegos RIC](https://www.sec.cl/pliegos-tecnicos-ric/) |
| `2021_SEC_RIC-07_Instalaciones-de-equipos-V1.1.pdf` | RIC N°07 Instalaciones de equipos (motores, etc.) | V1.1 (03-2021) | [SEC – Pliegos RIC](https://www.sec.cl/pliegos-tecnicos-ric/) |
| `2020_SEC_RIC-08_Sistemas-de-emergencia.pdf` | RIC N°08 Sistemas de emergencia | 2020 | [SEC – Pliegos RIC](https://www.sec.cl/pliegos-tecnicos-ric/) |
| `2020_SEC_RIC-09_Sistemas-de-autogeneracion.pdf` | RIC N°09 Sistemas de autogeneración (respaldo, grupo electrógeno) | 2020 | [SEC – Pliegos RIC](https://www.sec.cl/pliegos-tecnicos-ric/) |
| `2020_SEC_RIC-10_Instalaciones-uso-general.pdf` | RIC N°10 Instalaciones de uso general (viviendas) | 2020 | [SEC – Pliegos RIC](https://www.sec.cl/pliegos-tecnicos-ric/) |
| `2020_SEC_RIC-11_Instalaciones-especiales.pdf` | RIC N°11 Instalaciones especiales (baños §6, domótica §22) | 2020 | [SEC – Pliegos RIC](https://www.sec.cl/pliegos-tecnicos-ric/) |
| `2020_SEC_RIC-12_Ambientes-explosivos.pdf` | RIC N°12 Ambientes explosivos | 2020 | [SEC – Pliegos RIC](https://www.sec.cl/pliegos-tecnicos-ric/) |
| `2020_SEC_RIC-13_Subestaciones-y-salas-electricas.pdf` | RIC N°13 Subestaciones y salas eléctricas | 2020 | [SEC – Pliegos RIC](https://www.sec.cl/pliegos-tecnicos-ric/) |
| `2020_SEC_RIC-14_Eficiencia-energetica-edificios.pdf` | RIC N°14 Eficiencia energética | 2020 | [SEC – Pliegos RIC](https://www.sec.cl/pliegos-tecnicos-ric/) |
| `2024_SEC_RIC-15_Infraestructura-recarga-VE.pdf` | RIC N°15 Infraestructura de recarga de vehículos eléctricos | **versión 2024** | [SEC – Pliegos RIC](https://www.sec.cl/pliegos-tecnicos-ric/) |
| `2020_SEC_RIC-16_Subsistemas-de-distribucion.pdf` | RIC N°16 Subsistemas de distribución | 2020 | [SEC – Pliegos RIC](https://www.sec.cl/pliegos-tecnicos-ric/) |
| `2020_SEC_RIC-17_Operacion-y-mantenimiento.pdf` | RIC N°17 Operación y mantenimiento | 2020 | [SEC – Pliegos RIC](https://www.sec.cl/pliegos-tecnicos-ric/) |
| `2020_SEC_RIC-18_Presentacion-de-proyectos.pdf` | RIC N°18 Presentación de proyectos (planos) | 2020 | [SEC – Pliegos RIC](https://www.sec.cl/pliegos-tecnicos-ric/) |
| `2021_SEC_RIC-19_Puesta-en-servicio.pdf` | RIC N°19 Puesta en servicio (TE1) | rev. 08-06-2021 | [SEC – Reglamento DS 8](https://www.sec.cl/reglamento-de-seguridad-de-las-instalaciones-de-consumo-de-energia-electrica-decreto-08/) |
| `2022_SEC_Consultas-y-respuestas-DS8.pdf` | Preguntas frecuentes SEC sobre el DS 8 | 01-2022 | [SEC – Documentos complementarios RIC](https://www.sec.cl/documentos-complementarios-de-los-pliegos-ric/) |
| `2021_SEC_Oficio-Circular-9677.pdf`, `2021_SEC_Oficio-Circular-89015.pdf`, `2025_SEC_Oficio-Circular-291953_Proyectos-por-etapas.pdf`, `2026_SEC_Oficio-Circular-338253.pdf` | Oficios sobre la transición al DS 8 y los proyectos por etapas | 2021 a 06-2026 | [SEC – Documentos complementarios RIC](https://www.sec.cl/documentos-complementarios-de-los-pliegos-ric/) |

### Exigencias concretas para esta casa

**DS 8/2019**
- Toda instalación debe ser proyectada, ejecutada y declarada por un **instalador eléctrico autorizado SEC** (DS 92) con licencia vigente.
- La puesta en servicio se comunica a la SEC con el **TE1**, según el RIC 19. La distribuidora conecta el empalme definitivo con el TE1 inscrito.
- Es obra nueva sin permiso de edificación anterior a 2021, así que **aplican todos los pliegos**. Los oficios de transición (9677, 89015, 291953, 338253) no la eximen.

**RIC 01, Empalmes**
- La capacidad del empalme se elige de la tabla normalizada del Anexo 1.3:
  - **Monofásico BT1:** hasta **40 A = 8 kW** (tipo A-9).
  - **Monofásico de 50 A (10 kW) o 63 A (13 kW):** tipo A-16, solo con tarifas residenciales distintas de BT1.
  - **Trifásico:** 16 A = 9,7 kW (A-16); 25 A = 15 kW; 32 A = 19 kW (A-27).
- El medidor va en la fachada, visible desde la vía de acceso y a no más de **15 m** de la puerta de acceso, con el borde inferior entre **0,80 y 2,10 m**. Si no, la ubicación se acuerda con la distribuidora (§7.2 y §7.4).
- La acometida no puede cruzar predios vecinos sin servidumbre. Si mide más de 10 m, se usa concéntrico de **2×6 mm²** (nota del estándar SAESA).

**RIC 02, Tableros**
- Todo tablero lleva **puerta exterior y cubierta cubre-equipos**. Grado mínimo **IP41 en interior, IP44 en exterior bajo techo e IP54 a la intemperie**.
- Los mandos van entre **0,45 y 2,0 m** de altura.
- En obra nueva, el gabinete debe tener **25 % de espacio de reserva** (§6.1.16.3). Para domótica y la etapa 2 FV, conviene más.
- No se permiten tableros en dormitorios, baños, lavaderos ni closets (RIC 10 §5.1.3.2).

**RIC 03, Alimentadores**
- La caída de tensión puede ser de hasta **3 % en el alimentador y 5 % total** en el punto más desfavorable. En una casa rural con un alimentador largo desde el medidor, esto fija la sección del cable.
- Factor de demanda para casa habitación (alumbrado): **100 % de los primeros 3 kW, 35 % de 3 a 120 kW**.
- Ese factor no se aplica a los circuitos finales ni a cargas permanentes (bomba de calor, cargador EV).

**RIC 04, Conductores y canalizaciones**
- Secciones mínimas: **1,5 mm² para iluminación, 2,5 mm² para enchufes y circuitos mixtos, 2,5 mm² para subalimentadores**. Los alimentadores y el neutro de la red llevan al menos 4 mm².
- Código de colores:
  - fase 1 **azul**, fase 2 **negro**, fase 3 **rojo**;
  - neutro **blanco**;
  - tierra **verde o verde/amarillo**.
- Las líneas aéreas a la intemperie llevan al menos 4 mm².
- Los cables libres de halógenos solo son obligatorios en lugares de reunión de personas. En la casa son **recomendables** (mascotas, niños, humo).

**RIC 05, Protecciones**
- La tensión de contacto límite es **50 V CA en lugares secos y 24 V CA en lugares húmedos**.
- El esquema preferente es **TN-S** (neutralización). Para viviendas es obligatorio (RIC 10 §5.2 f).
- Los diferenciales de **≤ 30 mA** se reconocen como protección complementaria contra contactos directos.

**RIC 06, Puesta a tierra**
- La **tierra de servicio debe ser ≤ 20 Ω**. Puede llegar a **≤ 80 Ω** en dos casos:
  - instalación de **≤ 10 kW** en TN-S, con interruptor general omnipolar, **diferencial de 300 mA en los alimentadores y 30 mA en todos los circuitos**; o
  - con protección de sobretensión permanente (UNE-EN 50550) y transitoria (IEC 61643-11) en todos los tableros.
- El neutro y el conductor de tierra de servicio llevan al menos **4 mm²**. Los electrodos de conductor desnudo, al menos **25 mm²**, y las barras se unen con al menos 16 mm².
- Se acepta como electrodo la enfierradura de las fundaciones si suma **≥ 15 m** de barras. Conviene coordinarlo con la obra gruesa.
- Debe quedar un **punto de medición accesible**.

**RIC 07, Equipos**
- Aplica a los motores y compresores de la bomba de calor aire-agua y de la bomba de calor ACS. Cada equipo lleva **circuito exclusivo y protección según la corriente de arranque** del fabricante.

**RIC 09, Autogeneración**
- Aplica si se instala un grupo electrógeno de respaldo, típico en zona rural con cortes de SAESA. Se exige **transferencia abierta con enclavamiento**: el grupo no puede inyectar a la red.
- Si la transferencia es cerrada, se exige todo el pliego (control de inyección cero, sellos, etc.).

**RIC 10, Viviendas (el más importante)**
- Empalme con **protección mínima de 25 A** y alimentador **≥ 4 mm²**. Interruptor general **omnipolar (fase y neutro)**, que no es el que está junto al medidor.
- Circuitos:
  - **mínimo 3 circuitos** (vivienda ≥ 30 m²);
  - **1 circuito exclusivo de enchufes de cocina y/o lavadero de ≥ 16 A**;
  - **circuito independiente adicional para horno o cocina eléctrica** (inducción), de ≥ 16 A según potencia.
- **Todo circuito de iluminación y enchufes lleva diferencial de ≤ 30 mA.** Un diferencial puede alimentar **máximo 3 circuitos** y nunca el 100 % de la instalación.
- **Todos los enchufes deben ser de alvéolos protegidos.** Es la protección para niños y mascotas que exige la norma.
- Interruptores entre **0,80 y 1,40 m**. La altura de los enchufes es libre ("según necesidades de uso").
- Cantidad mínima de enchufes y centros:
  - **1 enchufe doble/triple cada 8 m de perímetro** en dormitorios y living;
  - **3 enchufes 10/16 A en la cocina** y **1 en el lavadero**, más uno de ≥ 16 A por cada horno o cocina eléctrica;
  - **1 centro de luz por recinto de ≤ 10 m²** y **2 si es mayor**, cada uno con su interruptor.
- Cálculo de cargas:
  - **250 W por enchufe**, y **100 W por centro** si no se conoce la luminaria;
  - un circuito se carga hasta el 90 % de su capacidad, y se agrega 10 % de reserva.
- Curvas de referencia: **B para iluminación, C para enchufes, D o K para la protección general**.

**RIC 11 §6, Baños y duchas**
- Volúmenes:
  - **Volumen 0:** dentro de la tina o ducha.
  - **Volumen 1:** hasta 2,25 m de altura sobre la tina o ducha. Si la ducha no tiene receptáculo, radio de 0,6 m (rociador fijo) o 1,2 m (flexible).
  - **Volumen 2:** 0,6 m más allá del volumen 1. El **lavamanos también es volumen 2**: 0,3 m alrededor y 0,3 m por sobre él.
  - **Volumen 3:** 2,4 m más allá del volumen 2.
- Enchufes:
  - **Prohibidos en los volúmenes 0, 1 y 2**, salvo la toma de afeitadora con transformador de aislación en el volumen 2.
  - En el volumen 3 se permiten con **diferencial de ≤ 30 mA**.
  - En el volumen 1 solo se admite **MBTS de ≤ 12 V CA**, y calentadores fijos.
- Grado IP: **IPX7 en el volumen 0, IPX4 en el 1 y el 2** (IPX5 si hay chorros).
- Debe haber una **conexión equipotencial local suplementaria** que una las partes metálicas: tuberías, tina y la malla del piso radiante si es metálica.
- Los calefactores bajo el piso pueden ir bajo cualquier volumen si tienen malla o cubierta metálica conectada a la equipotencial.

**RIC 11 §22, Domótica ("instalaciones inteligentes")**
- Si los buses o nodos funcionan en **extra baja tensión**, se rigen por el RIC 05 §8.6.2 (MBTS).
- Si un cable de señal comparte ducto con cables de 220 V, **su aislación debe ser equivalente a la de los cables de 220 V**. Lo recomendable es usar ductos separados.
- Los equipos deben traer instrucciones de instalación y de compatibilidad electromagnética (EMC).

**RIC 14, Eficiencia energética**
- Exige uso eficiente: iluminación eficiente y control. En la práctica, su peso cae sobre edificios no residenciales.

**RIC 15 (2024), Cargador de vehículo eléctrico (IRVE)**
- **Modo 1 está prohibido** para autos. En la casa se usa **modo 3**: un cargador de pared (SAVE) con conector **Tipo 2**, o Tipo 1 o GB/T AC.
- Circuito:
  - **exclusivo por cada cargador**, con sección **≥ 2,5 mm²**;
  - **diferencial tipo B**, o **tipo A de 30 mA más detección de fuga en corriente continua de 6 mA** (RDC-DD, a menudo integrada en el wallbox);
  - **protección contra sobretensiones de tipo 2 o superior**.
- El cargador va **≥ 10 cm sobre el suelo** (riesgo de inundación).
- La puesta a tierra se comprueba con el RIC 06 (método de caída de potencial). Si se instala una tierra nueva para el cargador, se une a la existente con soldadura exotérmica o compresión.
- Se declara a la SEC con el **TE6**. Puede declararlo un instalador **clase A, B, C o D** en modo 2 o 3, y **A o B** en modo 4 (DC).
- El cargador debe estar **autorizado por la SEC** (Res. Ex. 26.804/2024). En vivienda, con una sola salida y las protecciones integradas, el cargador puede conectarse directo al empalme si está a ≤ 3 m de él.

**RIC 17, Operación y mantenimiento**
- Pide mantener la documentación y los registros de la instalación y de sus pruebas periódicas.
- Recomendación práctica: probar los diferenciales una vez al mes con su botón "T".

**RIC 18, Proyecto y planos**
- La **memoria explicativa es obligatoria si la potencia declarada supera 10 kW**. Si se declara más de 10 kW (por ejemplo, un empalme trifásico de 15 kW), habrá que hacerla.
- Planos en **formatos serie A** (NCh 13), de preferencia a **escala 1:50**. Incluyen cuadro de cargas, diagrama unilineal, simbología del Anexo 18.3 y archivo DWG.

**RIC 19, Puesta en servicio (TE1)**
- Antes de energizar se inspecciona y luego se ensaya, en este orden:
  - continuidad de los conductores de protección;
  - **resistencia de aislamiento ≥ 0,5 MΩ a 500 V CC**, o **≥ 0,25 MΩ a 250 V** en circuitos MBTS (domótica);
  - puesta a tierra, disparo de los diferenciales, polaridad, orden de fases y pruebas de funcionalidad.
- Un ensayo negativo obliga a repetir ese ensayo y todos los anteriores tras corregir.

---

## 2. Generación distribuida y net billing (FV 3,6 a 7,2 kWp, baterías)

| Archivo | Norma | Versión/fecha | Fuente |
|---|---|---|---|
| `2012_DO_Ley-20571_Generacion-distribuida.pdf` | Ley 20.571 (art. 149 bis de la LGSE), generadoras residenciales | DO 22-03-2012 | [SEC – Marco regulatorio GD](https://www.sec.cl/gda/marco-regulatorio/) |
| `2018_BCN_Ley-21118_Incentiva-generadoras-residenciales.pdf` | Ley 21.118, que modifica la Ley 20.571 (límite de 300 kW, excedentes, GD conjunta) | DO 17-11-2018 | [LeyChile – Ley 21.118](https://www.bcn.cl/leychile/navegar?idNorma=1125560) |
| `2020_DO_DS-57-2019_Reglamento-generacion-distribuida-autoconsumo.pdf` | DS 57/2019 Energía, Reglamento de Generación Distribuida para Autoconsumo | DO 24-09-2020 | [Diario Oficial – DS 57](https://www.diariooficial.interior.gob.cl/publicaciones/2020/09/24/42763/01/1819801.pdf) |
| `2019_CNE_Norma-tecnica-conexion-netbilling.pdf` | Norma Técnica de Conexión y Operación de Equipamiento de Generación en BT (net billing) | 2019 | [SEC – Declaración TE4](https://www.sec.cl/gda/declaracion-te4/) |
| `2022_BCN_Ley-21505_Almacenamiento-y-electromovilidad.pdf` | Ley 21.505, que promueve el almacenamiento y la electromovilidad | DO 21-11-2022 | [LeyChile – Ley 21.505](https://www.bcn.cl/leychile/navegar?idNorma=1184572) |
| `2025_SEC_RGR-01-2024-v8_Procedimiento-comunicacion-energizacion.pdf` | Instructivo **RGR N°01/2024 v8**, procedimiento TE4 | 01-2025 (Res. 29.787) | [SEC – Marco regulatorio GD](https://www.sec.cl/gda/marco-regulatorio/) |
| `2025_SEC_RGR-02-2024-v11_Instalaciones-FV-conectadas-red_REX33038.pdf` | Instructivo **RGR N°02/2024 v11**, diseño y ejecución de FV conectada a red | 07-2025 (Res. 33.038) | [SEC – Marco regulatorio GD](https://www.sec.cl/gda/marco-regulatorio/) |
| `2025_SEC_RGR-06-2024-v4_Almacenamiento-BESS_REX33038.pdf` | Instructivo **RGR N°06/2024 v4**, sistemas de almacenamiento (BESS) | 07-2025 | [SEC – Marco regulatorio GD](https://www.sec.cl/gda/marco-regulatorio/) |
| `2024_SEC_REX-29787_Modifica-instructivos-GD.pdf` | Res. Ex. 29.787, que establece RGR 01, 02 y 06 versión 2024 | 30-12-2024 | [SEC – Marco regulatorio GD](https://www.sec.cl/gda/marco-regulatorio/) |
| `2025_SEC_REX-33038_Modifica-instructivos-tecnicos-AFCI.pdf` | Res. Ex. 33.038, que modifica RGR 02 y 06 (diferencial según potencia, AFCI) | 08-07-2025 | [SEC – Plataforma autorización productos](https://www.sec.cl/gda/plataforma-autorizacion-de-productos/) |
| `2016_SEC_REX-13530_Obligatoriedad-TE4-electronico.pdf` | Res. Ex. 13.530, que hace obligatorio el TE4 electrónico | 16-05-2016 | [SEC – Declaración TE4](https://www.sec.cl/gda/declaracion-te4/) |
| `2023_SEC_Manual-usuario-TE4.pdf` | Manual de usuario de la plataforma TE4 | 12-2023 | [SEC – Declaración TE4](https://www.sec.cl/gda/declaracion-te4/) |
| `2019_SEC_Guia-checklist-prefiscalizacion-TE4.pdf` | Guía checklist de prefiscalización TE4 | 2019 | [SEC – Documentación GD](https://www.sec.cl/gda/documentacion-y-presentaciones/) |
| `2019_SEC_Guia-buenas-malas-practicas-FV.pdf` | Guía de buenas y malas prácticas FV | 2019 | [SEC – Documentación GD](https://www.sec.cl/gda/documentacion-y-presentaciones/) |
| `2019_SEC_Guia-operacion-mantenimiento-FV.pdf` | Guía de operación y mantenimiento FV | 2019 | [SEC – Documentación GD](https://www.sec.cl/gda/documentacion-y-presentaciones/) |
| `2021_SEC_Consideraciones-diseno-BESS.pdf` | Presentación SEC sobre diseño de BESS | 12-2021 | [SEC – Documentación GD](https://www.sec.cl/gda/documentacion-y-presentaciones/) |
| `2026_SAESA_NetBilling-Formulario-Solicitud-de-Conexion.pdf` | SAESA, formulario de Solicitud de Conexión (SC) | 01-2026 | [SAESA – Formularios](https://web.gruposaesa.cl/web/saesa/cliente-hogar/informacion-comercial/formularios) |
| `2026_SAESA_NetBilling-Formulario-Notificacion-de-Conexion-BT1.pdf` | SAESA, Notificación de Conexión (NC) para BT1 | 01-2026 | [SAESA – Formularios](https://web.gruposaesa.cl/web/saesa/cliente-hogar/informacion-comercial/formularios) |
| `2026_SAESA_NetBilling-Borrador-Contrato-BT1.pdf` | SAESA, borrador de contrato de generación residencial BT1 | 01-2026 | [SAESA – Formularios](https://web.gruposaesa.cl/web/saesa/cliente-hogar/informacion-comercial/formularios) |
| `2026_SAESA_NetBilling-Protocolo-conexion.pdf` | SAESA, protocolo de conexión del servicio | 01-2026 | [SAESA – Formularios](https://web.gruposaesa.cl/web/saesa/cliente-hogar/informacion-comercial/formularios) |
| `2026_SAESA_NetBilling-Solicitud-Factibilidad.pdf` | SAESA, solicitud de factibilidad | 01-2026 | [SAESA – Formularios](https://web.gruposaesa.cl/web/saesa/cliente-hogar/informacion-comercial/formularios) |
| `2025_SAESA_Empalme-EA-1F-*.pdf` (PF, VF, PP) | SAESA, estándar de empalme aéreo monofásico A-6/A-9 | 28-02-2025 | [SAESA – Formularios](https://web.gruposaesa.cl/web/saesa/cliente-hogar/informacion-comercial/formularios) |
| `2025_SAESA_Empalme-EAD-3F-*.pdf` (PF, PP) | SAESA, estándar de empalme aéreo trifásico directo EAD-18/27/42/75 | 02-2025 | [SAESA – Formularios](https://web.gruposaesa.cl/web/saesa/cliente-hogar/informacion-comercial/formularios) |

### Exigencias concretas

**Leyes 20.571 y 21.118, y DS 57**
- Límite de **300 kW** por inmueble: la casa está muy lejos de ese tope.
- La **energía inyectada se valoriza al precio de nudo** que la distribuidora traspasa a regulados, no a la tarifa minorista completa. Por eso conviene **maximizar el autoconsumo**: programar la bomba de calor de ACS y la carga del auto a mediodía.
- Los excedentes se descuentan en las boletas siguientes. Si no se usan, pueden aplicarse a otro inmueble del mismo titular con la misma distribuidora, o pagarse.
- Trámite del DS 57 (los plazos son en días hábiles):
  1. Solicitud de Información, opcional.
  2. **Solicitud de Conexión (SC)** a SAESA. SAESA puede pedir correcciones en 5 días.
  3. Respuesta de SAESA en **20 días**.
  4. **Manifestación de conformidad** del usuario, vigente por 6 meses.
  5. Construcción.
  6. **TE4** ante la SEC.
  7. **Notificación de Conexión (NC)**, con correcciones en 5 días.
  8. SAESA instala el medidor bidireccional y se firma el contrato.

**Norma técnica de conexión**
- Si el **empalme es monofásico, la capacidad del equipo de generación (EG) debe ser menor a 10 kW**: los 7,2 kWp de la etapa 2 caben con un inversor de ≤ 9,9 kW AC.
- La **capacidad del EG debe ser ≤ la capacidad del empalme**. Con un empalme monofásico de 25 A (5 kW), un inversor de 6 kW no cabe.
- Desbalance máximo de **5 kVA por fase**.
- Un EG total de **≥ 10 kW debe ser trifásico simétrico**.

**RGR 02/2024 v11 (FV)**
- Módulos con **IEC 61215 e IEC 61730**. Inversor con **IEC 62109-1 y -2** (o UL 1741) y **anti-isla IEC 62116 siempre activa**. Todo debe estar **autorizado por la SEC**.
- **Desde el 01-01-2026 solo se aceptan en el TE4 inversores con AFCI integrado** (IEC 63027 o UL 1699B), con un máximo de **80 m de cable CC** entre el AFCI y el último módulo.
- Diferencial del lado AC del EG, según la Res. 33.038:
  - **≤ 30 mA si el EG es de ≤ 5 kW** (etapa 1, 3,6 kWp);
  - **≤ 100 mA si es de más de 5 y hasta 10 kW** (etapa 2).
- Descargadores de sobretensión **tipo 2** en CC y CA.
- Los inversores individuales de **más de 5 kW deben tener Modbus** (RTU, TCP o RS485) o IEC 61850. Esto sirve también para la domótica.
- Rotulación y placas de advertencia según el §18.
- Zona costera salina = franja de **10 km** desde la costa. Puringue Pobre podría estar cerca: hay que verificarlo, porque exige estructura y materiales anticorrosión.

**RGR 01/2024 v8 (TE4)**
- **Instalador clase A o B.** Con microinversores (≤ 60 V CC) también clase C, o clase D si el EG es ≤ 10 kW y el conductor principal mide < 10 m.
- Si se amplía el empalme por consumo y además se instala el EG, se hacen **TE1 (consumo) y TE4 (EG)**.
- Si hay un tablero general para el cargador EV según RIC 15, **no puede ponerse otro tablero general FV aguas arriba**. Se usan los esquemas de los Anexos 6 y 7.

**RGR 06/2024 v4 (baterías, para el futuro)**
- Baterías con **IEC 62619 / UL 9540** y BMS obligatorio en litio.
- **Prohibido instalarlas**:
  - a menos de **600 mm** de salidas, **calentadores de agua o bombas de calor** y ventanas o tomas de ventilación (1.200 mm por debajo de ellas);
  - **en el entretecho o bajo escaleras**;
  - **a la intemperie**, salvo IP55 bajo techo.
- Ojo con la sala técnica: no pegar la batería al acumulador de ACS.

**Ley 21.505 (2022)**
- Reconoce el almacenamiento y la electromovilidad en la ley eléctrica, y eximió temporalmente del permiso de circulación a los vehículos eléctricos.
- **No encontré** cambios legales de 2025 o 2026 al net billing residencial. El último cambio técnico es el AFCI obligatorio desde 2026.

---

## 3. Certificación SEC de productos (inversores, paneles, cargadores)

| Archivo | Norma | Versión/fecha | Fuente |
|---|---|---|---|
| `2025_SEC_REX-31661_Autorizacion-productos-FV.pdf` + `2025_SEC_REX-31661_Anexo.pdf` | Res. Ex. 31.661, medida transitoria: autorización previa de unidades y componentes FV | 14-04-2025 | [SEC – Plataforma autorización productos](https://www.sec.cl/gda/plataforma-autorizacion-de-productos/) |
| `2024_SEC_Manual-plataforma-autorizacion-productos-ERNC.pdf` | Manual de la plataforma de autorización de productos ERNC | v3 | [SEC – Plataforma autorización productos](https://www.sec.cl/gda/plataforma-autorizacion-de-productos/) |

- **Antes de comprar** un panel, inversor, microinversor o batería, hay que verificar marca y modelo en el [buscador SEC de equipamiento autorizado](https://wlhttp.sec.cl/productManager/search) (ver la página [Equipamiento autorizado SEC](https://www.sec.cl/gda/equipamiento-autorizado/)). Si no aparece, **no se puede declarar en el TE4**.
- Los productos eléctricos de consumo (enchufes, interruptores, diferenciales, cables, luminarias) deben tener **sello SEC**. Se verifica en el [Sistema de Certificación de Productos SEC](https://www.sec.cl/sistema-de-certificacion-de-productos-sec/).
- Los cargadores EV deben estar autorizados según la Res. Ex. SEC 26.804/2024 (citada en la instrucción TE6; el PDF de la resolución no se descargó).

---

## 4. Electromovilidad: trámite TE6

| Archivo | Norma | Versión/fecha | Fuente |
|---|---|---|---|
| `2026_SEC_Instruccion-tecnica-TE6_Puesta-en-servicio-IRVE.pdf` | Instrucción Técnica General **RIC N°15.1/2026**, comunicación de puesta en servicio de la IRVE (TE6) | 01-2026 | [SEC – Instrucción técnica TE6 2026](https://www.sec.cl/sitio-web/descargar/1305/documentos-oficiales/47823/instruccion-tecnica-te6_2026.pdf) |
| `2024_SEC_Manual-usuario-TE6.pdf` | Manual de usuario de la plataforma TE6 | 2024 v5.1 | [SEC – Manual TE6](https://www.sec.cl/sitio-web/descargar/1172/te6/43740/manual-de-usuario-te6-2024-v5-1.pdf) |

- El proyecto IRVE lleva formato de planos, unilineal y cuadro de cargas (Anexos 1 a 5). Si después se cambia el cargador por uno igual o de menor potencia y autorizado, no hace falta redeclarar.
- Un cargador privado no debe declararse como público. Si se mezclan ambos usos, toda la instalación pasa a ser pública e interoperable.

---

## 5. Tarifas (SAESA, decreto VAD vigente)

| Archivo | Norma | Versión/fecha | Fuente |
|---|---|---|---|
| `2024_BCN_DS-5T_Formulas-tarifarias-distribucion-VAD-2020-2024.pdf` | DS 5T/2024 Energía, fórmulas tarifarias y opciones (BT1a, BT1b, TRBT, TRBT2, TRBT3, BT2 a BT4) | DO 07-06-2024 | [LeyChile – DS 5T](https://www.bcn.cl/leychile/navegar?idNorma=1204074) |
| `2018_SAESA_Tarifas-vigentes-Opciones-tarifarias.pdf` | SAESA, descripción de las opciones tarifarias | 27-02-2018 (publicado como "vigente" en 2026) | [SAESA – Tarifas vigentes](https://web.gruposaesa.cl/web/saesa/pago-y-boleta/tarifas-vigentes) |
| `2018_SAESA_Tarifas-vigentes-Cargos-tarifarios.pdf` | SAESA, estructura de cargos | 27-02-2018 | [SAESA – Tarifas vigentes](https://web.gruposaesa.cl/web/saesa/pago-y-boleta/tarifas-vigentes) |

Pliegos con valores en $ (ZIP, no descargados): [SAESA – Pliego tarifario octubre 2026 (ZIP)](https://webserver-websaesa-prd.lfr.cloud/documents/37727/10411315/2026.10.zip/23856b36-4b45-704e-3e11-921089760706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). Ver también [CNE – Opciones tarifarias a usuarios finales](https://www.cne.cl/en/tarificacion/electrica/valor-agregado-de-distribucion/opciones-tarifarias-a-usuarios-finales/).

- **BT1a o BT1b (tarifa simple por kWh):** solo para residenciales con **potencia conectada ≤ 10 kW o con limitador**. No tiene cargo por potencia.
  - En invierno puede haber cargo por "energía adicional de invierno" sobre el límite de invierno, si se consumen más de 430 kWh/mes.
  - Una **bomba de calor más el auto eléctrico** hacen que el consumo de invierno supere fácilmente ese umbral.
- **TRBT2 (≤ 10 kW) y TRBT3 (> 10 kW):** son las tarifas residenciales con **medidor inteligente de 15 minutos**. Cobran energía más **demanda máxima leída en horas de punta** y demanda máxima suministrada.
  - En SAESA, la **punta es de 18:00 a 23:00, del 1 de abril al 30 de septiembre** (según el documento SAESA de 2018; hay que confirmarlo para 2026).
  - Conviene si **no se carga el auto ni se usa resistencia de respaldo de 18 a 23 h en invierno**. La domótica puede bloquear esas cargas en ese horario.
- **TRBT:** requiere un medidor del SMMC (sistema de medición inteligente). El DS 5T agrega el "reconocimiento horario" para clientes con medidor de 15 minutos (§5.7), que paga según el aporte real a la punta.
- **BT4.3 (horaria):** es para clientes no residenciales o con contrato de potencia. En general no conviene para una casa.
- **Recomendación:** partir en **BT1** si el empalme se contrata en ≤ 10 kW. Con el cargador EV y la bomba de calor ya funcionando, pedir a SAESA una simulación **TRBT2/TRBT3** con 12 meses de datos y una estrategia de carga fuera de punta.

---

## 6. Telecomunicaciones, domótica y detectores de humo

| Archivo | Norma | Versión/fecha | Fuente |
|---|---|---|---|
| `2015_BCN_Ley-20808_Libre-eleccion-servicios-telecom.pdf` | Ley 20.808 ("ley de ductos"), libre elección de servicios de telecomunicaciones | DO 28-01-2015 | [LeyChile – Ley 20.808](https://www.bcn.cl/leychile/navegar?idNorma=1074272) |
| `2018_SUBTEL_Resumen-libre-eleccion-RIT.pdf` | Subtel, resumen del Reglamento (DS 167/2016) y la Norma Técnica de la Red Interna de Telecomunicaciones (RIT) | 2018 | [Subtel – Resumen libre elección](https://www.subtel.gob.cl/wp-content/uploads/2018/04/RESUMEN_LibreEleccion_24072018.pdf) |

- **Telecom:** el DS 167/2016 y la Res. 766/2018 de Subtel (RIT) aplican a **loteos, edificaciones y copropiedades con varias unidades**. Una **vivienda unifamiliar aislada en predio rural, en principio, no está obligada** (por confirmar con el art. 2 del DS 167).
  - Buena práctica igualmente: un ducto de reserva de Ø32 mm desde el límite del predio hasta el gabinete de telecomunicaciones, y un ducto aparte para la antena o el enlace 4G/5G o Starlink.
- **Domótica:** no tiene norma chilena propia aparte del RIC 11 §22. Buenas prácticas:
  - bus cableado (KNX, que es ISO/IEC 14543-3, o Modbus/RS485 para el inversor y la bomba de calor) en **ductos separados del 220 V**;
  - **rack con UPS** en la sala técnica;
  - cable UTP Cat6 en estrella a cada recinto;
  - **ningún actuador domótico debe reemplazar a una protección** (RIC 10 §5.1.3.8: las protecciones no se usan como maniobra).
- **Detectores de humo:** **hoy no son obligatorios** en viviendas en Chile.
  - El [Boletín 16.919 sobre detectores de humo y monóxido de carbono en viviendas](https://www.camara.cl/cms/2025/04/21/a-sala-obligacion-para-viviendas-de-contar-con-detectores-de-humo-para-prevenir-incendios/) fue aprobado por la Cámara en junio de 2025 y pasó al Senado.
  - En junio de 2026 se presentó otra moción que exige el detector antes de la recepción final ([Meganoticias – Proyecto detectores de humo viviendas nuevas](https://www.meganoticias.cl/nacional/525228-proyecto-instalacion-detectores-humo-viviendas-nuevas-caso-hijo-mariana-derderian-22-06-2026.html)).
  - **Recomendación:** instalar detectores **interconectados** (alimentados a 220 V con batería, o inalámbricos integrados a la domótica) en cada dormitorio, en el pasillo de cada piso y en la sala técnica. Agregar un **detector de CO** si hay cualquier combustión (estufa, cocina a gas, grupo electrógeno).

---

## Recomendaciones de diseño eléctrico para esta casa

### Cuadro de cargas estimado

| Carga | Potencia instalada | Simultaneidad en punta de invierno | Circuito sugerido |
|---|---|---|---|
| Iluminación LED (≈ 40 centros) | 0,8 kW reales (4 kW de cálculo con 100 W por centro si no se declaran) | 0,5 kW | 3 circuitos de 10 A (por piso o zona), 1,5 mm², curva B |
| Enchufes generales (≈ 30 puntos) | 7,5 kW de cálculo (250 W por punto) | 1,5 kW | 3 a 4 circuitos de 16 A, 2,5 mm², curva C |
| Enchufes de cocina | 3 kW | 1,5 kW | 1 circuito exclusivo de 16 A (obligatorio) |
| Cocina de inducción | 7,2 kW (4 zonas) | 3,5 kW (limitable en el equipo) | Exclusivo de 32 A, 6 mm² (o 2×16 A si es bifásica) |
| Horno eléctrico | 3 kW | 1,5 kW | Exclusivo de 16 A, 2,5 mm² |
| Lavadora, secadora con bomba de calor y lavavajillas | 2 + 1 + 2 kW | 1 kW | 2 circuitos de 16 A (lavadero y cocina) |
| **Bomba de calor aire-agua** (calefacción) | **3 kW de compresor** (+ resistencia de respaldo de 3 a 6 kW) | 3 kW (**resistencia bloqueada en punta**) | Exclusivo de 20 A, 4 mm² (o trifásico); diferencial tipo A o tipo F si tiene inverter |
| Bomba de calor ACS | 0,6 kW (+ resistencia de 1,5 kW) | 0,6 kW | Exclusivo de 16 A |
| Bombas de circulación del piso radiante y control | 0,2 kW | 0,2 kW | 10 A |
| **Cargador EV** (wallbox modo 3) | **7,4 kW** (32 A, monofásico) / 11 kW (3×16 A) | **0 en punta** (programado de noche o a mediodía con FV) | Exclusivo según RIC 15: 6 mm² monofásico (o 5×2,5–4 mm² trifásico); diferencial tipo B o tipo A + RDC-DD de 6 mA; SPD tipo 2 |
| Bomba de pozo o presurizadora (rural, si existe) | 1 kW | 0,5 kW | Exclusivo de 16 A |
| Rack de domótica, red, cámaras y portón | 0,3 kW | 0,3 kW | 10 A con UPS |
| Exterior (jardín, estacionamiento) | 1 kW | 0,2 kW | 16 A, IP44 o superior |
| **Total** | **≈ 37 kW instalados** | **≈ 14 kW sin gestión; ≈ 9 a 10 kW con gestión de cargas** | |

Consumo anual estimado: calefacción con SCOP de unos 3,5 da ≈ 3.000 a 3.700 kWh. ACS, ≈ 800 kWh. Un auto con unos 12.000 km/año, ≈ 2.000 kWh. Base de la casa, ≈ 3.000 kWh. **Total ≈ 9.000 a 10.000 kWh/año.**

La FV produce **≈ 5.400 kWh/año en la etapa 1** (3,6 kWp × 1.500) y **≈ 10.800 kWh/año en la etapa 2**. Pero la producción se concentra en verano y la demanda en invierno, así que el net billing hará de "batería" estacional, valorizada a precio de nudo.

### Empalme: monofásico o trifásico

- **El monofásico BT1 llega como máximo a 40 A (8 kW, tipo A-9).** No alcanza para inducción + bomba de calor + auto al mismo tiempo, salvo con una gestión de cargas muy estricta: wallbox a 10–16 A y bloqueo mutuo de cargas.
- **Recomendado: empalme trifásico 3×25 A (15 kW)**, ampliable a 3×32 A (19 kW, tipo A-27). Ventajas:
  - el wallbox puede cargar a 11 kW, o a 7,4 kW en una fase;
  - las cargas se reparten por fase;
  - la FV de la etapa 2 puede ser trifásica, y deja espacio para más de 10 kW a futuro.
- Si se quiere conservar la **tarifa BT1** (≤ 10 kW), una alternativa intermedia es **contratar el trifásico de 3×16 A (9,7 kW)**. El **alimentador y el tablero se dimensionan desde el principio para 3×32 A**, y luego se amplía solo el empalme con un TE1.
- Un empalme de más de 10 kW obliga a la **memoria explicativa** (RIC 18) y deja fuera la BT1, con lo que se pasa a TRBT3.
- Para cualquier opción hay que **pedir factibilidad a SAESA** (formulario descargado). En zona rural, la red de baja tensión cercana podría ser solo monofásica, y el trifásico podría requerir extensión de red con costo.
- **Gestión de cargas obligatoria en el diseño:** wallbox con balanceo dinámico (sensor de corriente en el empalme) y bomba de calor con entrada SG-Ready o EVU para bloquear la resistencia de respaldo. La domótica orquesta todo con la producción FV.

### Protecciones seguras para niños y mascotas

1. **Diferencial de 30 mA en todos los circuitos**, con máximo 3 circuitos por diferencial (obligatorio). Usar **tipo A** como mínimo (cargas electrónicas, inducción, inverter), **tipo B o A + RDC-DD** para el auto, y **≤ 30 mA en el diferencial del inversor FV de la etapa 1**. Agregar un diferencial general selectivo de 300 mA si se aprovecha la tierra de 80 Ω.
2. **Enchufes de alvéolos protegidos** en todos los puntos (obligatorio). En dormitorios infantiles y el living, ponerlos a **≥ 1,10 m** o detrás de muebles fijos (no es obligatorio).
3. **Nada de cables a la vista ni alargadores**: hay 3 gatos y 1 perro que muerden. Canalización **embutida o en tubo rígido**. El cable CC de la FV va en **tubo metálico** y fuera del alcance. Inversor, tablero y baterías en la **sala técnica con llave**.
4. **Protección contra sobretensiones tipo 2** en el tablero general (y en el de la FV y el del EV). Las líneas aéreas rurales de SAESA tienen muchas descargas y maniobras.
5. **Puesta a tierra ≤ 20 Ω** (o ≤ 80 Ω con 300 mA + 30 mA). Usar las fundaciones como electrodo (≥ 15 m de barra) más una barra copperweld en una cámara registrable.
6. **Baños:** ningún enchufe en los volúmenes 0 a 2. Equipotencial local. Luminarias **IPX4**.
7. **Exterior** (perro y lluvia de Los Ríos): enchufes y luminarias **IP44 o superior**. El wallbox va **≥ 10 cm sobre el piso** y con el cable recogido en un soporte.
8. **Detectores de humo interconectados más CO**, y **luz de emergencia** en la escalera (RIC 08 no lo exige en vivienda, pero es recomendable).
9. **Tablero en un lugar accesible** para adultos, no en un dormitorio, con **puerta con llave o pestillo** y **25 % o más de reserva** para la etapa 2 de la FV, baterías y domótica.

---

## Normas pagadas / no descargadas (solo link)

| Norma | Para qué | Dónde |
|---|---|---|
| IEC 60364 (serie), IEC 61008/61009 (diferenciales), IEC 62955 (RDC-DD de 6 mA) | Base técnica de los RIC 05 y 10, y del cargador EV | [IEC Webstore](https://webstore.iec.ch/) |
| IEC 61851-1, IEC 62196-2 | Cargador EV modo 3 y conector Tipo 2 | [IEC Webstore](https://webstore.iec.ch/) |
| IEC 62109-1/-2, IEC 62116, IEC 63027 / UL 1699B | Inversor FV: seguridad, anti-isla y AFCI | [IEC Webstore](https://webstore.iec.ch/) / [UL Standards](https://www.shopulstandards.com/) |
| IEC 61215, IEC 61730 | Módulos FV | [IEC Webstore](https://webstore.iec.ch/) |
| IEC 62619, UL 9540 | Baterías (BESS) | [IEC Webstore](https://webstore.iec.ch/) / [UL Standards](https://www.shopulstandards.com/) |
| IEC 61643-11, UNE-EN 50550 | Protección de sobretensión transitoria y permanente (para usar la tierra de 80 Ω) | [IEC Webstore](https://webstore.iec.ch/) / [UNE](https://www.une.org/) |
| NCh 13 Of.93 | Formatos de planos (RIC 18) | [INN – Catálogo de normas](https://ecommerce.inn.cl/) |
| ISO/IEC 14543-3 (KNX), EN 50491 | Domótica | [ISO](https://www.iso.org/) / [CENELEC](https://www.cenelec.eu/) |
| UNE-EN 14604 / UL 217 | Detectores de humo autónomos | [UNE](https://www.une.org/) / [UL Standards](https://www.shopulstandards.com/) |
| DS 167/2016 MTT (texto completo) | Reglamento de libre elección y RIT | Copia de terceros: [DO Decreto 167 (Televés)](https://docs.televes.com/web/Legislacion/latam/DO_decreto_167.pdf). No se descargó porque no es una fuente oficial. |
| Pliegos tarifarios SAESA 2026 con valores en $ | Comparar BT1 con TRBT | [SAESA – Pliego tarifario octubre 2026 (ZIP)](https://webserver-websaesa-prd.lfr.cloud/documents/37727/10411315/2026.10.zip/23856b36-4b45-704e-3e11-921089760706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). Es un ZIP, no un PDF. |
| Res. Ex. SEC 26.804/2024 | Autorización de cargadores EV | Citada en la instrucción TE6; no se encontró el PDF en sec.cl |

## Por confirmar

- **Distribuidora:** SAESA tiene concesión en Mariquina (línea Pichoy–Pelchuquín, decreto de 1994), pero no se confirmó para Puringue Pobre en particular. Revisar la boleta de un vecino o pedir factibilidad. Si fuera una cooperativa, cambian los formularios y los estándares de empalme.
- **Red trifásica disponible** en el poste más cercano, y el costo de extenderla si no la hay.
- **Distancia a la costa:** si la casa está a menos de 10 km del mar, la RGR 02 la trata como **zona salina** (estructura y conectores anticorrosión).
- **Horas de punta 2026 de SAESA** (en 2018 eran de 18 a 23 h, de abril a septiembre) y si existe en 2026 el "límite de invierno" en BT1a. Revisar el ZIP del pliego de octubre de 2026.
- **Si SAESA ya ofrece la tarifa TRBT** con medidor inteligente (SMMC) en la zona rural.
- **Si los pliegos RIC 01 a 14 y 16 a 19 tienen una nueva versión en consulta.** La SEC tiene un proceso de modificación abierto, pero a octubre de 2026 publica como vigentes las versiones 2020–2021, salvo el RIC 15, que es de 2024.
- **Estado en el Senado del Boletín 16.919** (detectores de humo obligatorios).
- **Bomba de calor:** si el modelo elegido es monofásico o trifásico, la potencia real de la resistencia de respaldo y si tiene entrada SG-Ready. Esto define el circuito y la gestión de cargas.
