omaru-san/casa-freecad/normas/03_agua_alcantarillado_gas_calefaccion/INDICE.md

# 03 · Agua potable, alcantarillado, aguas grises/lluvias, gas y calefacción

Normativa vigente a **octubre 2026** para una vivienda rural en Puringue Pobre, Mariquina (Región de Los Ríos): sin alcantarillado público (fosa séptica y drenes), agua desde APR/SSR o pozo propio, cosecha de aguas lluvia, ACS y piso radiante con bomba de calor aire-agua, y gas solo para cocina si se usa.

Descargado el 19-20 oct 2026. Los textos legales vienen de la [Biblioteca del Congreso Nacional, LeyChile](https://www.bcn.cl/leychile) en su última versión, generados en PDF por el servicio de exportación de LeyChile. Todos los archivos se verificaron con `file` y son PDF reales.

---

## 1. Tabla de archivos

| Archivo | Norma | Versión / fecha | Fuente |
|---|---|---|---|
| `2002_MOP_DS50-RIDAA-Reglamento-Instalaciones-Domiciliarias-AP-Alc.pdf` | DS 50/2002 MOP: RIDAA (Reglamento de Instalaciones Domiciliarias de Agua Potable y Alcantarillado) | Última versión 10-feb-2009 | [LeyChile, DS 50 MOP 2002](https://www.leychile.cl/Navegar?idNorma=207101) |
| `1926_MINSAL_DS236-Reglamento-Alcantarillados-Particulares-Fosas-Septicas.pdf` | DS 236/1926: Reglamento General de Alcantarillados Particulares | Última versión 26-jul-2004 (DS 75/2004) | [LeyChile, DS 236 de 1926](https://www.leychile.cl/Navegar?idNorma=171085) |
| `1969_MINSAL_DS735-Reglamento-Servicios-Agua-Consumo-Humano.pdf` | DS 735/1969: Reglamento de los servicios de agua destinados al consumo humano | Última versión 30-jul-2010 (DS 76/2010) | [LeyChile, DS 735 de 1969](https://www.leychile.cl/Navegar?idNorma=197226) |
| `2017_Ley20998-Servicios-Sanitarios-Rurales.pdf` | Ley 20.998, que regula los Servicios Sanitarios Rurales | Última versión 17-jul-2023 (Ley 21.581) | [LeyChile, Ley 20.998](https://www.leychile.cl/Navegar?idNorma=1100197) |
| `2020_MOP_DS50-Reglamento-Ley20998-SSR.pdf` | DS 50/2020 MOP: Reglamento de la Ley 20.998 | Versión 19-ene-2021 | [LeyChile, DS 50 MOP 2020](https://www.leychile.cl/Navegar?idNorma=1150724) |
| `2018_Ley21075-Aguas-Grises.pdf` | Ley 21.075 sobre recolección, reutilización y disposición de aguas grises | Última versión 29-sep-2025 | [LeyChile, Ley 21.075](https://www.leychile.cl/Navegar?idNorma=1115066) |
| `2024_MINSAL_DS40-Reglamento-Reutilizacion-Aguas-Grises.pdf` | **DS 40/2022 MINSAL** (publicado en el D.O. el 09-may-2024): Reglamento sobre condiciones sanitarias básicas para la reutilización de aguas grises. **Es el reglamento de la Ley 21.075**; no existe un "DS 47/2022". | Vigente desde 06-nov-2024 | [LeyChile, DS 40 Salud](https://www.leychile.cl/Navegar?idNorma=1203416) |
| `2007_MINECON_DS66-Reglamento-Instalaciones-Interiores-Gas.pdf` | DS 66/2007: Reglamento de Instalaciones Interiores y Medidores de Gas | Última versión 09-sep-2026 | [LeyChile, DS 66 de 2007](https://www.leychile.cl/Navegar?idNorma=263058) |
| `2026_MINENERGIA_DS13-Modifica-DS66-Gas-Multicapa_DiarioOficial.pdf` | DS 13/2026 Energía, que modifica el DS 66 (tuberías multicapa con capa de aluminio) | Diario Oficial 10-ago-2026 | [Diario Oficial, CVE 2851196](https://www.diariooficial.interior.gob.cl/publicaciones/2026/08/10/44521/01/2851196.pdf) |
| `1981_DFL1122-Codigo-de-Aguas-actualizado.pdf` | DFL 1.122/1981, Código de Aguas (incluye la reforma de la Ley 21.435 de 2022) | Última versión 09-oct-2026 (Ley 21.841) | [LeyChile, Código de Aguas](https://www.leychile.cl/Navegar?idNorma=5605) |
| `2023_DGA_Res2356-Art56-Pozos-Consumo-Humano.pdf` | Res. DGA 2.356/2023, criterios de caudal y volumen para consumo humano, saneamiento y subsistencia. Resume la Res. DGA 1.655/2022 (art. 56). | 2023 | [DGA, Res. 2356 de 2023](https://dga.mop.gob.cl/uploads/sites/13/2024/06/res_2356_2023.pdf) |
| `2026_ChileAtiende_Ficha-Derecho-Aguas-Subterraneas-DGA.pdf` | Ficha del trámite DGA para solicitar un derecho de aguas subterráneas | Actualizada 02-oct-2026 | [ChileAtiende, Derecho de aprovechamiento de aguas subterráneas](https://www.chileatiende.gob.cl/fichas/7106) |
| `2026_ChileAtiende_Ficha-Aprobacion-Proyecto-AP-Alc-Particular.pdf` | Ficha SEREMI de Salud: aprobación de un proyecto particular de agua potable o aguas servidas | Actualizada 19-feb-2026 | [ChileAtiende, Aprobación de proyectos de agua potable o aguas servidas particular](https://www.chileatiende.gob.cl/fichas/16614) |
| `2026_ChileAtiende_Ficha-Autorizacion-Funcionamiento-AP-Alc-Particular.pdf` | Ficha SEREMI de Salud: autorización de funcionamiento del sistema particular | Actualizada 19-feb-2026 | [ChileAtiende, Autorización de funcionamiento de sistema particular](https://www.chileatiende.gob.cl/fichas/16932) |
| `2026_SEREMISalud-Arica_Checklist-Proyecto-AP-Alc-Particular.pdf` | Checklist de la SEREMI de Salud de Arica para el proyecto particular (no se encontró uno publicado por Los Ríos) | ene-2026 | [SEREMI Salud Arica, checklist](https://www.seremisalud15.cl/docs/formularios/PROYECTO_AGUA_POTABLE_ALCANTARILLADO_PARTICULAR.pdf) |
| `2026_SEREMISalud-Arica_Instructivo-Autorizacion-AP-Alc-Particular.pdf` | Instructivo de la SEREMI de Salud de Arica para la autorización de funcionamiento | ene-2026 | [SEREMI Salud Arica, instructivo](https://www.seremisalud15.cl/docs/formularios/INSTRUCTIVO_AUTORIZACION_AGUA_POTABLE_ALCANTARILLADO_PARTICULAR.pdf) |
| `2026_ChileAtiende_Ficha-E-Declarador-SEC-TC6.pdf` | Ficha SEC: declaración de instalaciones por e-Declarador (TC6 corresponde al gas) | 2026 | [ChileAtiende, Declaración de instalaciones a través de e-Declarador](https://www.chileatiende.gob.cl/fichas/2656) |
| `2009_Ley20365-Franquicia-Sistemas-Solares-Termicos.pdf` | Ley 20.365, franquicia tributaria para sistemas solares térmicos | Última versión 05-feb-2016 (Ley 20.897) | [LeyChile, Ley 20.365](https://www.leychile.cl/Navegar?idNorma=1005169) |
| `2020_MinEnergia-GIZ_Guia-Bombas-de-Calor.pdf` | Ministerio de Energía y GIZ, "Bombas de Calor: Guía del usuario" | oct-2020 | [Ministerio de Energía, Guía Bombas de Calor](https://autoconsumo.minenergia.cl/wp-content/uploads/2020/10/Guia-Bombas-de-Calor.pdf) |
| `2016_INIA_Boletin321-Captacion-Aguas-Lluvias.pdf` | INIA, Boletín 321 "Técnicas de captación, acumulación y aprovechamiento de aguas lluvias" (copia espejo) | 2016 | [Boletín INIA 321 (espejo produccion-animal.com.ar)](https://www.produccion-animal.com.ar/agua_cono_sur_de_america/86-captacion_inia.pdf) |
| `2015_PNUD-INIA_Cosecha-Agua-Lluvia-Chile.pdf` | PNUD e INIA, guía de cosecha de agua lluvia (Chile) | dic-2015 | [PNUD, Cosecha de agua lluvia en Chile](https://global-prod.acquia.undp.org/sites/g/files/zskgke326/files/migration/latinamerica/UNDP-RBLAC-CosechaAguaLluviaCL.pdf) |
| `2018_SERVIU-RM_Cap5-Diseno-Elementos-Urbanos-Aguas-Lluvias.pdf` | MINVU/SERVIU RM, Cap. 5 "Diseño de elementos urbanos de infraestructura de aguas lluvias" | MOV SERVIU 2018 | [MINVU SERVIU RM, Cap. 5 Aguas Lluvias](https://pavimentacion.metropolitana.minvu.cl/doc/MPALL/mpall3docs/Cap%205%20Diseno%20elementos%20Urbanos%20de%20Infraestructura%20de%20Aguas%20Lluvias.pdf) |
| `2026_GobiernoVasco_Prevencion-Legionella-Viviendas.pdf` | Gobierno Vasco (Departamento de Salud), "Legionella y legionelosis: prevención en viviendas" | 2026 | [Euskadi.eus, Prevención de Legionella en viviendas](https://www.euskadi.eus/contenidos/informacion/legionella_prevencion/es_llo/adjuntos/Prevencion-de-Legionella-en-viviendas.pdf) |
| `2001_MSanidad-ES_Acciones-Preventivas-Legionella.pdf` | Ministerio de Sanidad de España, "Acciones preventivas" contra Legionella | 2001 | [Ministerio de Sanidad, acciones preventivas Legionella](https://www.sanidad.gob.es/ciudadanos/saludAmbLaboral/docs/accpreventivas_legionella.pdf) |

---

## 2. Exigencias concretas por norma

### RIDAA, DS 50/2002 MOP
- **Presión mínima de diseño:** 14 m.c.a. después de la llave de paso aguas abajo del medidor (art. 52 f, remite a NCh 2485). En el artefacto más desfavorable no se acepta menos de **7 m.c.a. cuando el agua viene de medios mecánicos** (bomba). El valor exigido para el abastecimiento desde la red aparece en blanco en el texto de BCN; ver "Por confirmar". La presión máxima es la que fija NCh 2485.
- **Velocidades y diámetros:** máximo 2,5 m/s en tuberías exteriores y de distribución principal, y 2,0 m/s en la red interior. Diámetro mínimo de **13 mm en cobre y 16 mm en plástico**. El gasto máximo probable se calcula como QMP = 1,7391·QI^0,6891 (L/min). Cada baño o cocina lleva llave de paso de agua fría y de agua caliente.
- **Elevación (bombas):** la bomba debe aspirar de un **estanque de acumulación sin presión**; no puede aspirar directo de la red (art. 81). La diferencia entre presión de partida y de detención es de **12 m.c.a. como máximo** (art. 84 k). Se exige válvula de retención en la impulsión y corte por nivel a 0,10 m sobre el chupador. Los estanques tienen radier con pendiente ≥1 % hacia el desagüe, y el nivel máximo queda ≥0,10 m bajo la boca de alimentación (arts. 69-71).
- **Alcantarillado:** la unión domiciliaria tiene un mínimo de **100 mm**. Pendiente de **3 % a 15 %** en tuberías con materia fecal (1 % como mínimo en casos justificados) y de 3 % a 33 % en la unión domiciliaria. Sifón con sello ≥50 mm. Hay **cámaras de inspección** en cada confluencia o cambio de dirección, separadas a lo más **30 m (D100)** o 50 m (D150). Ventilación principal hasta la techumbre.

### DS 236/1926: fosas sépticas y alcantarillado particular
- **Volumen de la fosa:** debe permitir una **retención de 24 h** del caudal diario más el lodo acumulado en **al menos 2 años**, con un claro libre ≥**25 cm** sobre el nivel del agua (arts. 25-26). Tapa de registro hermética de ≥**60 cm** (art. 27). Por debajo de 20 personas, la fosa se ventila por la cañería principal prolongada ≥30 cm sobre el techo (art. 28). La cañería de entrada es de ≥**100 mm** con pendiente ≥**3 %** (2 % en casos calificados, art. 29). Sobre 2.000 L útiles se exige cámara de dosificación con sifón (art. 31).
- **Drenes (infiltración):** tubería de juntas abiertas a ≥**50 cm de profundidad** en terreno permeable, con **5 a 25 m de dren por persona** según la permeabilidad (art. 8). Para 4-5 personas eso da entre 20 y 125 m. La cámara o pozo absorbente tiene ≥1,50 m de profundidad útil y 1 m² de superficie absorbente por cada 500 L/día (art. 59).
- **Distancias:** la cámara absorbente queda a ≥**20 m** de cualquier pozo, noria o fuente de agua de bebida (art. 60). Descargar al subsuelo sin tratamiento exige ≥**100 m** de las fuentes (art. 6). El lodo se retira cuando ocupa más de 1/4 de la capacidad, dejando un remanente (art. 73).
- El efluente que va a un curso de agua debe salir con <1.000 coliformes fecales/100 mL (art. 5). La SEREMI de Salud aprueba el proyecto y autoriza el funcionamiento (ver fichas de ChileAtiende).

### DS 735/1969 MINSAL: servicios de agua para consumo humano
- Rige todo servicio particular de agua potable, incluido un pozo propio que abastece una vivienda, y exige calidad de agua potable (NCh 409).
- **Cloro libre residual entre 0,2 mg/L como mínimo y 2 mg/L como máximo** cuando se desinfecta con cloro. El sistema se desinfecta antes de ponerlo en servicio.
- En la práctica, la SEREMI pide un análisis físico-químico y bacteriológico del pozo para la autorización sanitaria.

### Ley 20.998 y DS 50/2020 MOP (Servicios Sanitarios Rurales, ex APR)
- Dotación de referencia: **20 m³/mes por arranque** (15 m³ de consumo familiar y 5 m³ de subsistencia), según el art. 9 del DS 50/2020. Para 4 personas equivale a unos 125-165 L/hab/día.
- El operador SSR prioriza el consumo familiar y el saneamiento cuando hay escasez.
- Hay que pedir al comité APR/SSR local un **certificado de factibilidad**. Si es negativo, ese certificado es requisito para aprobar un proyecto particular ante la SEREMI.

### Ley 21.075 y DS 40/2022 MINSAL (aguas grises)
- **Aguas grises** son las de tinas, duchas, lavaderos y lavatorios, excluidas las aguas negras (art. 2 de la ley). Usos permitidos en vivienda: **riego de jardín y descarga de inodoros**. Usos prohibidos: consumo humano, riego de hortalizas a ras de suelo que se comen crudas, piscinas y similares (art. 9 de la ley).
- Requieren **aprobación del proyecto y autorización de funcionamiento de la SEREMI de Salud**. **Las aguas grises tratadas no se almacenan más de 48 h** (art. 17) y nunca se almacenan sin tratar (art. 18). Las tuberías son **de color morado** o llevan franjas moradas (art. 19).
- La red de aguas grises va **bajo la de agua potable** y **sobre la de aguas negras** en cruces y paralelismos (art. 20). El riego subsuperficial inyecta a ≥**15 cm** de profundidad (art. 23).
- El sistema debe mantener siempre una descarga de respaldo al alcantarillado o a la fosa (art. 24). Ojo: esa descarga suma caudal hidráulico a la fosa y a los drenes.

### Código de Aguas (DFL 1.122, reformado por la Ley 21.435/2022) y resoluciones DGA
- **Art. 56:** cualquiera puede cavar en suelo propio pozos para bebida y **usos domésticos de subsistencia** sin pedir un derecho de aguas, extrayendo hasta el volumen que fije la DGA para cada cuenca.
- **Res. DGA 1.655/2022**, según el resumen de la Res. 2.356/2023: para consumo humano y saneamiento, **caudal ≤0,5 L/s y hasta 20 m³/mes por familia**. Si se suma subsistencia (huerta, animales), ≤0,5 L/s y hasta 650 m³/mes. Para soluciones individuales se usa 0,05 L/s por habitante.
- Con un uso mayor, o para regularizar e inscribir, se pide un **derecho de aprovechamiento de aguas subterráneas** en la DGA: publicaciones en el Diario Oficial y aviso radial, más 30 días hábiles para oposiciones. La Ley 21.841 (oct-2026) prorrogó el plazo de regularización.

### DS 66/2007 (gas), DS 13/2026 y TC6
- Los cilindros de GLP de 45 kg van **al exterior**. Deben respetar las distancias de la **Tabla XIX** (aberturas, cámaras de alcantarillado, fuentes de ignición) y quedar a ≥0,60 m bajo cualquier abertura si están en gabinete (art. 65). Junto a una pared combustible, se interpone una plancha incombustible con 2 cm de separación (art. 65.5).
- Los artefactos y cilindros de 5/11/15 kg **no se instalan en dormitorios ni en baños**. El recinto necesita ventilación permanente de ≥**100 cm²** arriba y abajo (art. 64 y siguientes).
- Las tuberías pueden ser de cobre tipo K o L, acero, o **multicapa con capa de aluminio**. El DS 13/2026 permite esta última con restricciones: no sirve como conexión a artefactos y exige protección mecánica.
- Toda instalación interior nueva se declara ante la SEC con el **TC6** antes de su puesta en servicio, por un instalador de gas autorizado SEC (art. 85 y siguientes; e-Declarador).

### Ley 20.365 (franquicia para sistemas solares térmicos)
- Es un crédito tributario para **empresas constructoras**, solo por **colectores solares térmicos**, no por bombas de calor. Las tablas del beneficio terminan en **2020** y no hay prórroga en LeyChile a oct-2026. **No aplica a esta casa.**

### Guía de Bombas de Calor (Ministerio de Energía y GIZ, 2020)
- Una bomba de calor aire-agua típica calienta agua hasta ~60 °C, con COP de ~3-5. El caso de ejemplo de la guía usa una **bomba de calor de ACS con acumulador de 300 L**.
- El piso radiante es el emisor que mejor aprovecha la bomba de calor porque trabaja a baja temperatura de impulsión.

### Legionella (Gobierno Vasco y Ministerio de Sanidad de España; Chile no tiene una guía MINSAL específica para viviendas)
- Mantener el **acumulador de ACS sobre 60 °C** en todo momento. Purgar el fondo del acumulador semanalmente y limpiarlo y desinfectarlo una vez al año.
- Purgar semanalmente los grifos de poco uso, y desmontar y descalcificar duchas y aireadores una vez al año.
- Los sistemas instantáneos no presentan riesgo. La Legionella prolifera entre 20 y 45 °C.

### Aguas lluvias (INIA, PNUD/INIA y MINVU/SERVIU)
- No hay un reglamento chileno que regule la captación domiciliaria de aguas lluvias para uso no potable. Las guías INIA y PNUD dan el método: área de techo × precipitación × coeficiente de escorrentía (~0,8-0,9 en techo metálico), más **desviador de primeras aguas**, filtro y estanque opaco.
- El Cap. 5 del MINVU fija el diseño de la evacuación de aguas lluvias (tormentas de diseño, coeficientes de escorrentía). El RIDAA exige que las **aguas lluvias vayan separadas del alcantarillado de aguas servidas**: **no se conectan a la fosa**.

---

## 3. Recomendaciones para esta casa

Las cifras de esta sección son criterio de diseño (referencias de norma y buenas prácticas). Las debe validar el proyectista sanitario o térmico.

1. **Demanda de agua:** 4 personas × 150 L/hab/día dan unos **600 L/día**. Eso es coherente con los 20 m³/mes de la DGA y del SSR.
2. **Estanque de acumulación de agua potable y bomba presurizadora:**
   - Estanque de **2.000 a 3.000 L** (3 a 5 días de reserva ante cortes del APR o falla del pozo), de polietileno apto para agua potable, opaco, con tapa hermética y ventilación protegida.
   - Bomba presurizadora **de velocidad variable (presión constante)** ajustada a **~30-35 m.c.a.** de partida, más un hidroneumático pequeño de 20-24 L. Así cumple el diferencial de partida y detención ≤12 m.c.a. y deja ≥14 m.c.a. en el artefacto más desfavorable.
   - Válvula reductora si se superan ~40 m.c.a. (verificar el máximo de NCh 2485). Instalar válvula de retención, by-pass manual de servicio (no conectado a la red pública) y protección contra marcha en seco.
   - Dejar prevista una alimentación de respaldo para la bomba (UPS o solar), según la carpeta 02.
3. **Fosa séptica y drenes (napa alta):**
   - Volumen útil de ~**1.500-2.400 L** para 5 personas: 24 h × 750 L más lodos de 2 años más claro libre. Una fosa prefabricada certificada de ~2.000-2.400 L suele ser la que acepta la SEREMI.
   - Hacer un **test de infiltración** y una calicata en invierno para conocer la napa. Si la napa está cerca, usar drenes elevados, un montículo o un **biofiltro o planta domiciliaria**, que aprueba la SEREMI.
   - Mantener el fondo del dren a ≥1 m sobre la napa (criterio usual; confirmar con la SEREMI).
   - Ubicar la fosa y los drenes **aguas abajo del pozo y a ≥20 m de él** (art. 60; se recomiendan 30 m o más), con acceso para el camión limpiafosas.
4. **Cosecha de aguas lluvia:** un techo de ~150 m² × 1.700 mm × 0,85 capta unos **215 m³/año**. Para cubrir riego e inodoros (~150-200 L/día) en 2-3 meses secos de verano hacen falta **15-20 m³**. Una solución razonable es un estanque soterrado o un par de estanques de **10.000 L** con desviador de primeras aguas y filtro. Debe ser una **red no potable separada, identificada y sin conexión cruzada** con el agua potable. Si se agregan aguas grises, hay que tramitarlas según el DS 40.
5. **ACS con bomba de calor:** acumulador de **250-300 L** para 4 personas (40-60 L/persona/día a 60 °C, con margen para tina y duchas largas). Debe tener serpentín de intercambio de gran superficie, compatible con la bomba de calor, y resistencia de apoyo.
   - Programar un **ciclo antilegionella semanal a ≥60-65 °C**, y si la bomba de calor no lo alcanza, usar la resistencia.
   - Acumular a 55-60 °C.
6. **Seguridad de los niños:**
   - **Válvula mezcladora termostática a la salida del acumulador**, limitada a 45-48 °C.
   - **Griferías termostáticas** en la ducha y la tina, regulables a 38 °C, con tope de seguridad. Para bañar a niños pequeños, 37 °C comprobado con termómetro.
   - El ACS **nunca** se distribuye al consumo directamente a 60 °C.
7. **Piso radiante con la misma bomba de calor:**
   - Temperatura de impulsión de **30-40 °C** (en diseño, ~35 °C con el exterior a −2 °C en Mariquina) y salto térmico de 5-7 K.
   - Temperatura superficial ≤**29 °C** en zonas de estar y ≤35 °C en la periferia, según la referencia UNE-EN 1264.
   - Tubo **PEX-a o PE-RT** de 16-17 mm **con barrera antioxígeno (EVOH)**, a 10-20 cm entre tubos, con **circuitos de ≤100-120 m** y colector con caudalímetros.
   - Aislación bajo el radier (EPS ≥50-80 mm, en especial con napa alta) y banda perimetral.
   - Termostatos por zona. Agregar un buffer o una válvula de 3 vías para priorizar el ACS. Tubería multicapa o PEX también para las redes de agua fría y caliente.
8. **Gas solo para cocina:** cilindros de 45 kg en una caseta exterior ventilada, una sola cocina conectada, instalador SEC y TC6. Con encimera de inducción se elimina el gas por completo (sin TC6 ni riesgo de CO). Es la opción recomendada con niños pequeños en casa y una bomba de calor eléctrica.
9. **Trámites:**
   - Certificado de factibilidad del APR/SSR (o negativo).
   - Proyecto de agua potable y alcantarillado particular ante la **SEREMI de Salud Los Ríos**, a través de SEREMI en Línea, con un proyectista inscrito.
   - Autorización de funcionamiento al terminar la obra.
   - Si hay pozo: análisis de agua y uso dentro de los límites del art. 56 (≤0,5 L/s y 20 m³/mes) o derecho DGA.
   - Gas: TC6.

---

## 4. Normas pagadas o no descargadas (no hay copias oficiales gratuitas)

Se compran en el [catálogo de normas del INN](https://ecommerce.inn.cl/). No se descargaron copias no oficiales.

| Norma | Tema | Para qué sirve aquí |
|---|---|---|
| NCh 409/1 Of.2005 y NCh 409/2 Of.2004 | Calidad del agua potable y muestreo | Análisis del pozo o del estanque. La norma está en revisión y hubo consulta pública en 2022. |
| NCh 2485 Of.2000 | Instalaciones domiciliarias de agua potable: diseño, cálculo y requisitos de redes interiores | Presiones mínima y máxima en artefactos, velocidades (la cita el RIDAA) |
| NCh 691 | Agua potable: conducción, regulación y distribución | Presiones de la red pública o del SSR |
| NCh 1105 | Alcantarillado de aguas residuales: diseño y cálculo de la red | Diseño del alcantarillado |
| NCh 2592 | Cámaras de inspección domiciliarias | Cámaras (art. 91 del RIDAA) |
| NCh 3371 | Aguas lluvias (sistemas de recolección) | Referencia para la cosecha y la evacuación pluvial |
| NCh 2794 | Artefactos sanitarios / griferías | Certificación de los artefactos |
| NCh 1411/1 | Letreros de seguridad | Señalética de aguas grises (DS 40) |
| UNE-EN 1264 (partes 1-5) | Sistemas de calefacción por superficies radiantes | Diseño del piso radiante: temperaturas superficiales, cálculo y ensayo. Se compra en [UNE](https://www.une.org/). |
| UNE-EN 15316 / UNE 100030 | Rendimiento de sistemas de ACS / prevención de Legionella | Referencia para el ACS |
| DIN 4726 | Estanqueidad al oxígeno de tubos plásticos | Barrera EVOH del piso radiante |

**No se encontraron en versión gratuita oficial:**
- El "Manual de Normas Técnicas" SISS de 1981-1988: lo modificaron decretos antiguos, y en la práctica lo reemplazan el RIDAA y las NCh.
- El "Estudio de Soluciones Sanitarias para el Sector Rural" de SUBDERE: solo hay notas de prensa ([SUBDERE, estudio de soluciones sanitarias rurales](https://www.subdere.gov.cl/node/76779)), sin PDF público.
- Una guía específica de la SEREMI de Salud Los Ríos: se usaron las fichas nacionales de ChileAtiende y el checklist de Arica como referencia.
- El "Manual de diseño de sistemas solares térmicos" de la CDT: el enlace del sitio de la CDT exige registro ([CDT, descargas](https://cdt.cl/download/76474)).
- Una guía oficial chilena de piso radiante: no existe.
- Una guía MINSAL de Legionella en ACS domiciliaria: no se encontró.
- El texto completo de la Res. DGA 1.655/2022: solo existe el resumen dentro de la Res. 2.356/2023 ([vLex, Res. 1655 DGA](https://vlex.cl/vid/resolucion-n-1655-direccion-912640885)).
- El DS 10/2020 MINVU, que modifica la OGUC para permisos con aguas grises: LeyChile no tiene el texto, solo la ficha ([LeyChile, DS 10 Vivienda 2020](https://www.leychile.cl/Navegar?idNorma=1153728)).

---

## 5. Por confirmar

- **Presión mínima en el artefacto desde la red:** el texto de BCN del art. 52 d del RIDAA trae la cifra en blanco ("presión menor a __ mca"). Hay que confirmar el valor (según la práctica, 2-4 m.c.a.) y la **presión máxima de NCh 2485** (en la práctica ~40 m.c.a.) en la norma comprada o con el proyectista.
- **Volumen mínimo de fosa** y **distancia a la napa** que exige hoy la SEREMI de Salud Los Ríos (criterios internos), y si acepta drenes con napa alta o pide planta o biofiltro.
- **Distancias de la Tabla XIX del DS 66** (cilindros de 45 kg a aberturas): la tabla es imagen en el PDF de BCN y hay que leerla directamente en las págs. ~120-121.
- **Tablas de calidad de las aguas grises tratadas** del DS 40 (art. 36): están como imagen en el PDF, así que hay que revisar los coliformes, la DBO5 y la turbiedad para riego e inodoros.
- Si el **volumen fijado por la DGA para la cuenca del río Mariquina/Cruces** difiere de los 20 m³/mes por familia, y si el pozo debe informarse a la DGA (la Ley 21.435 exige registrar las extracciones de pozos del art. 56; verificar en la [DGA](https://dga.mop.gob.cl/)).
- Que el APR/SSR de Puringue tenga capacidad y entregue un certificado de factibilidad.
- Subsidios vigentes en 2026 para bomba de calor o calefacción sustentable en Los Ríos (MINVU, programa de Calefacción Sustentable del Ministerio de Energía o la AgenciaSE). La Ley 20.365 no aplica.
- Si Chile aplica una norma o guía MINSAL sobre Legionella en ACS domiciliaria; por ahora se usan las referencias españolas y vascas.
