omaru-san/casa-freecad/laminas/01_arquitectura.png

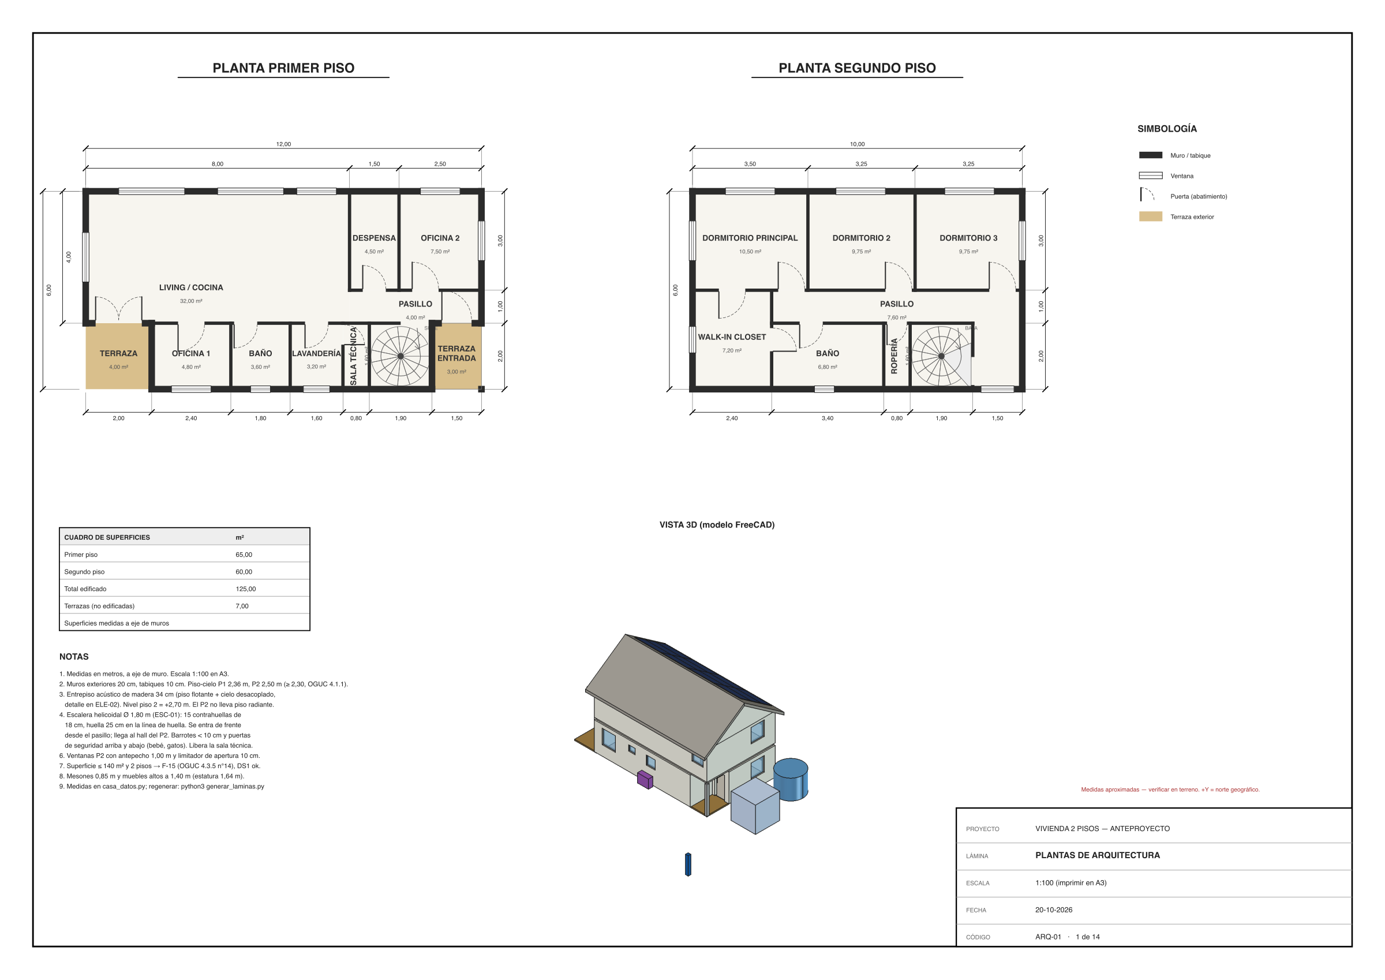
laminas/01_arquitectura.png
