omaru-san/casa-freecad/laminas/02_electrico.png

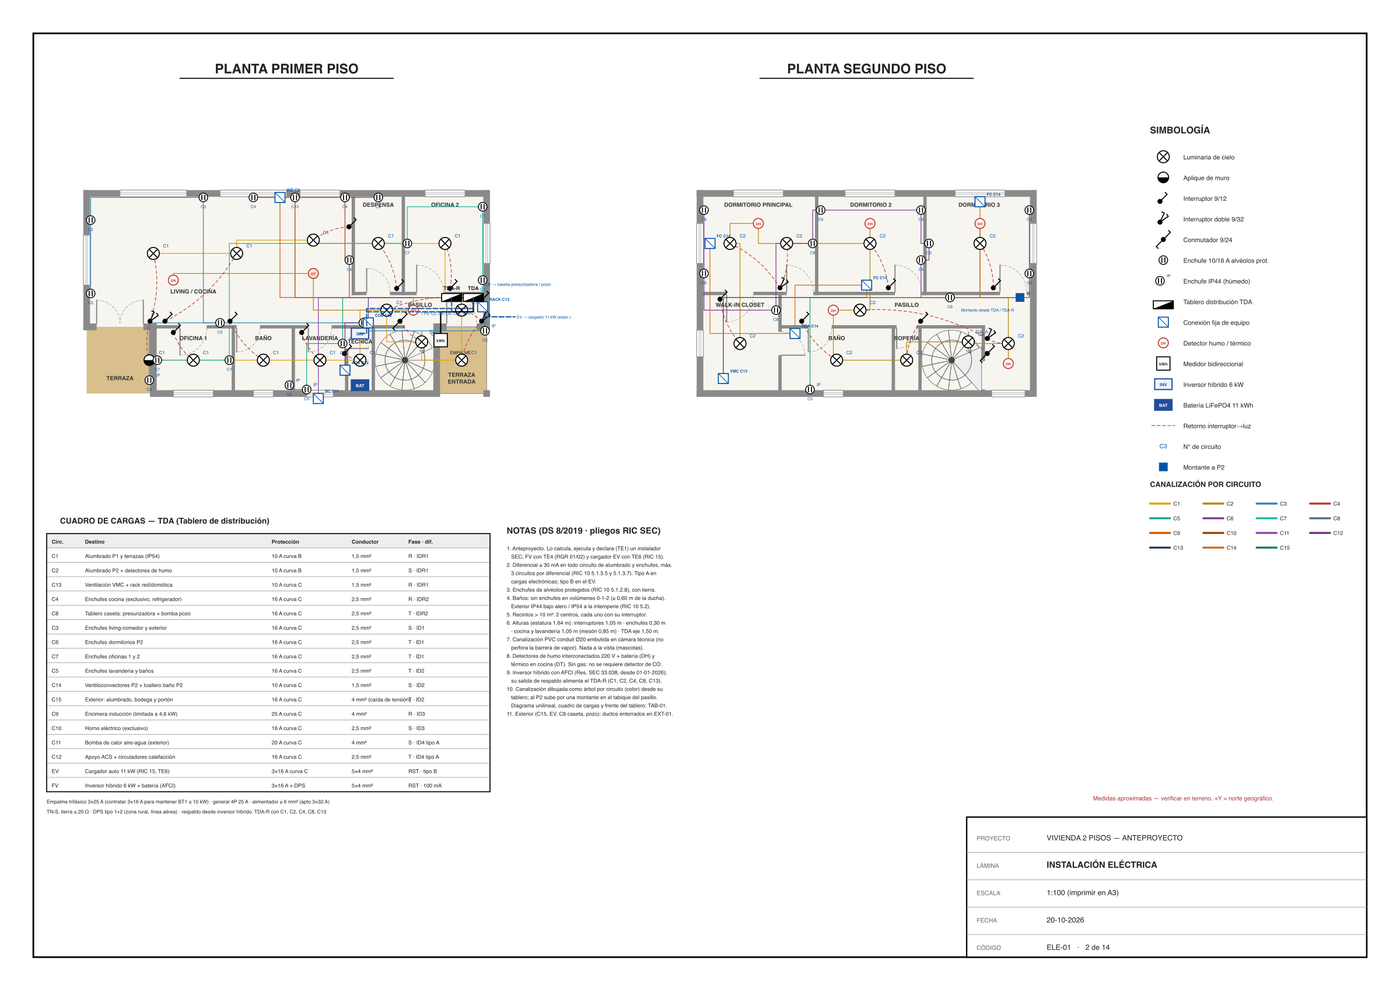
laminas/02_electrico.png
