omaru-san/casa-freecad/laminas/03_gasfiteria.png

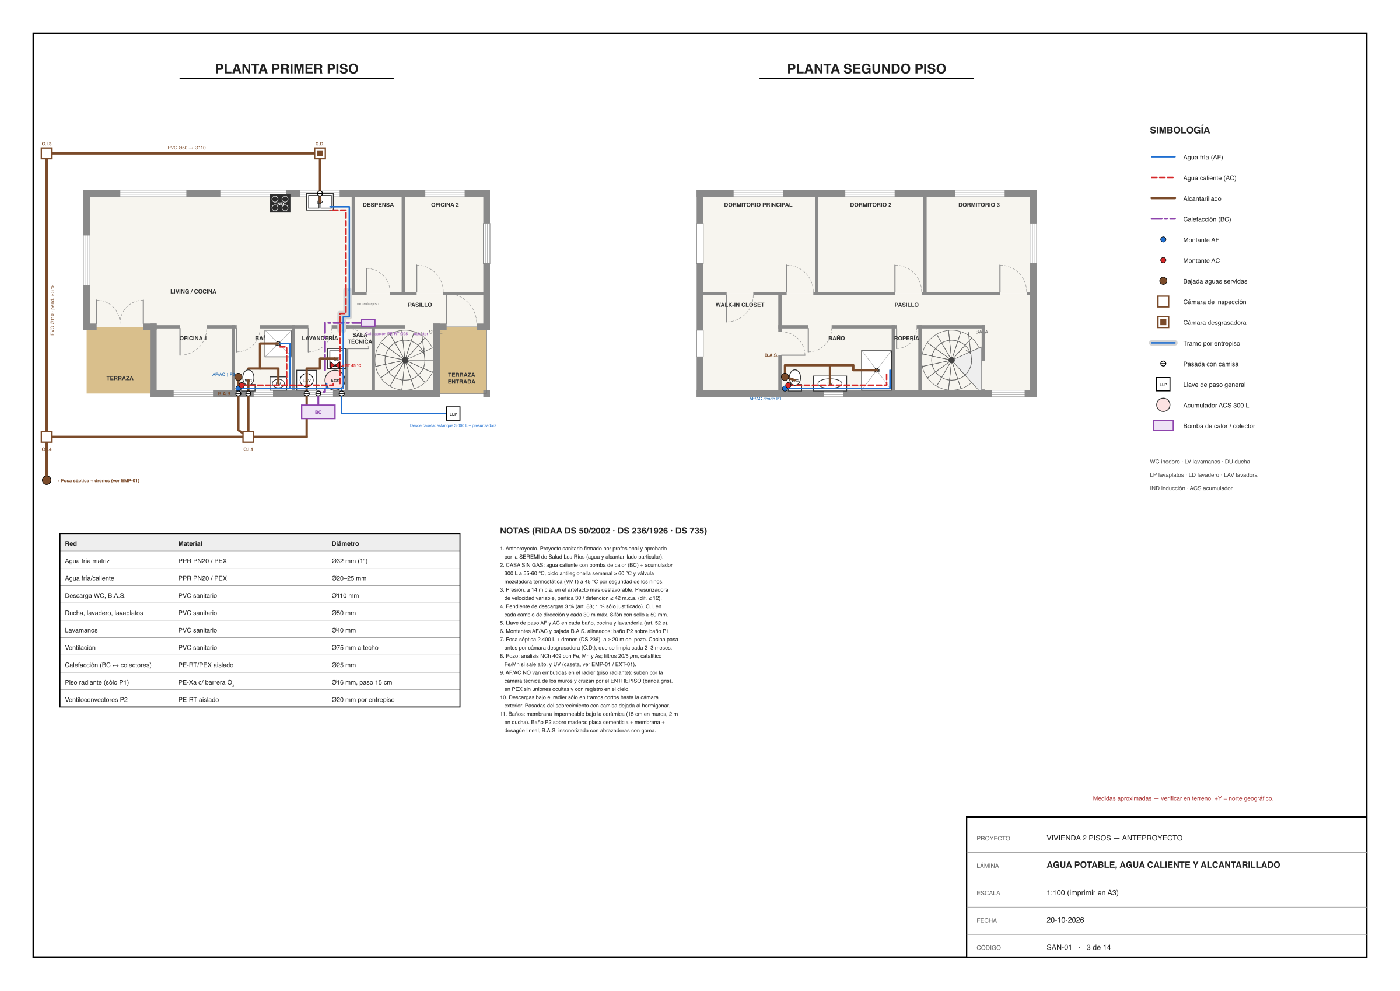
laminas/03_gasfiteria.png
