omaru-san/casa-freecad/laminas/04_emplazamiento.png

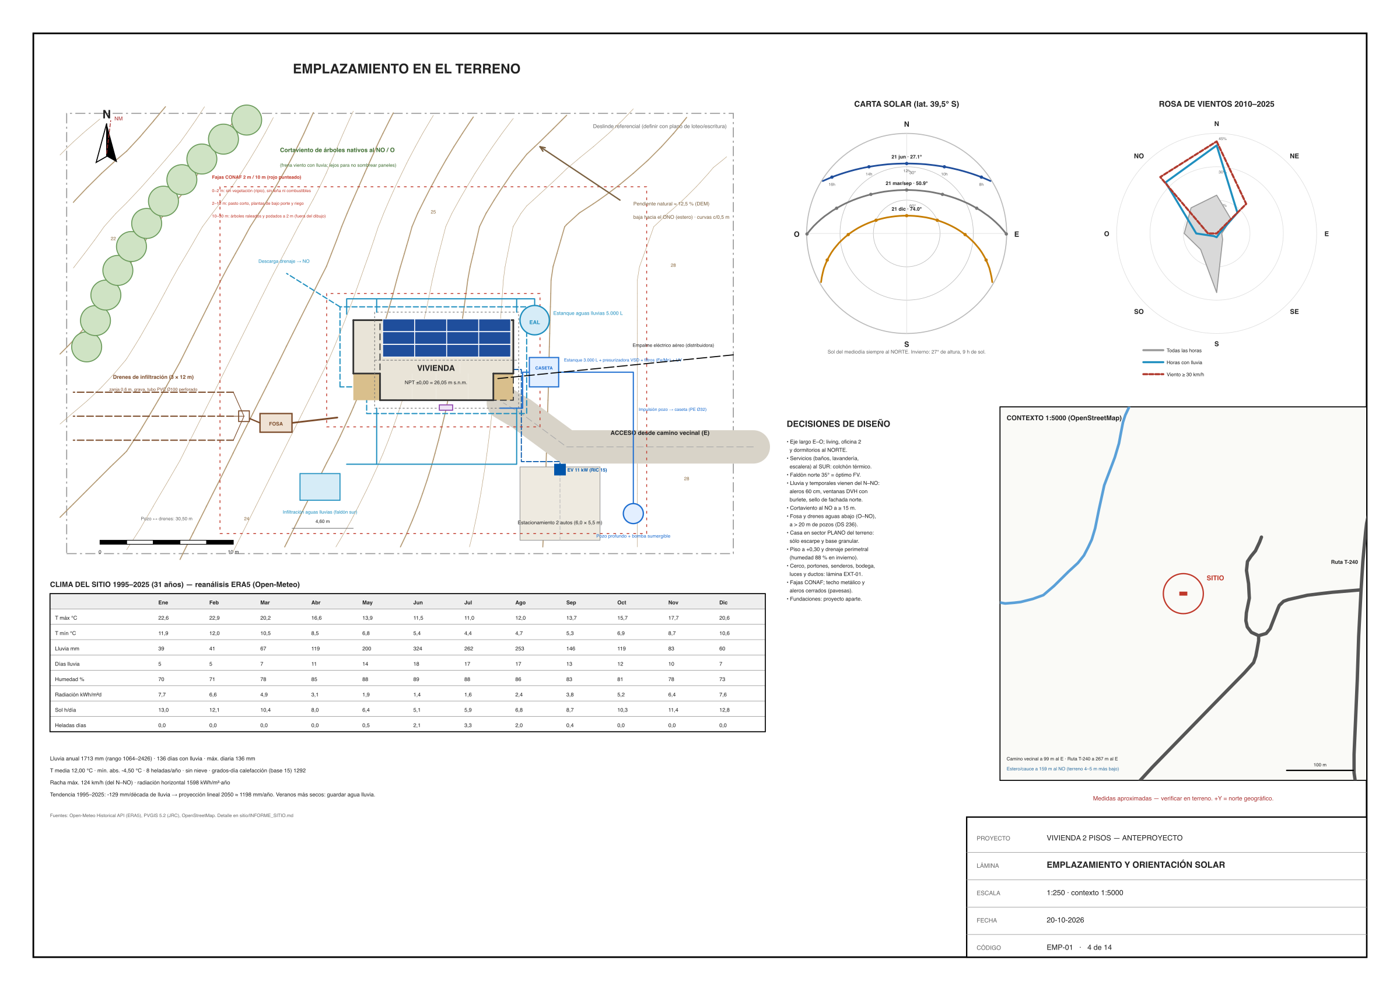
laminas/04_emplazamiento.png
