omaru-san/casa-freecad/laminas/05_techumbre_fv_lluvias.png

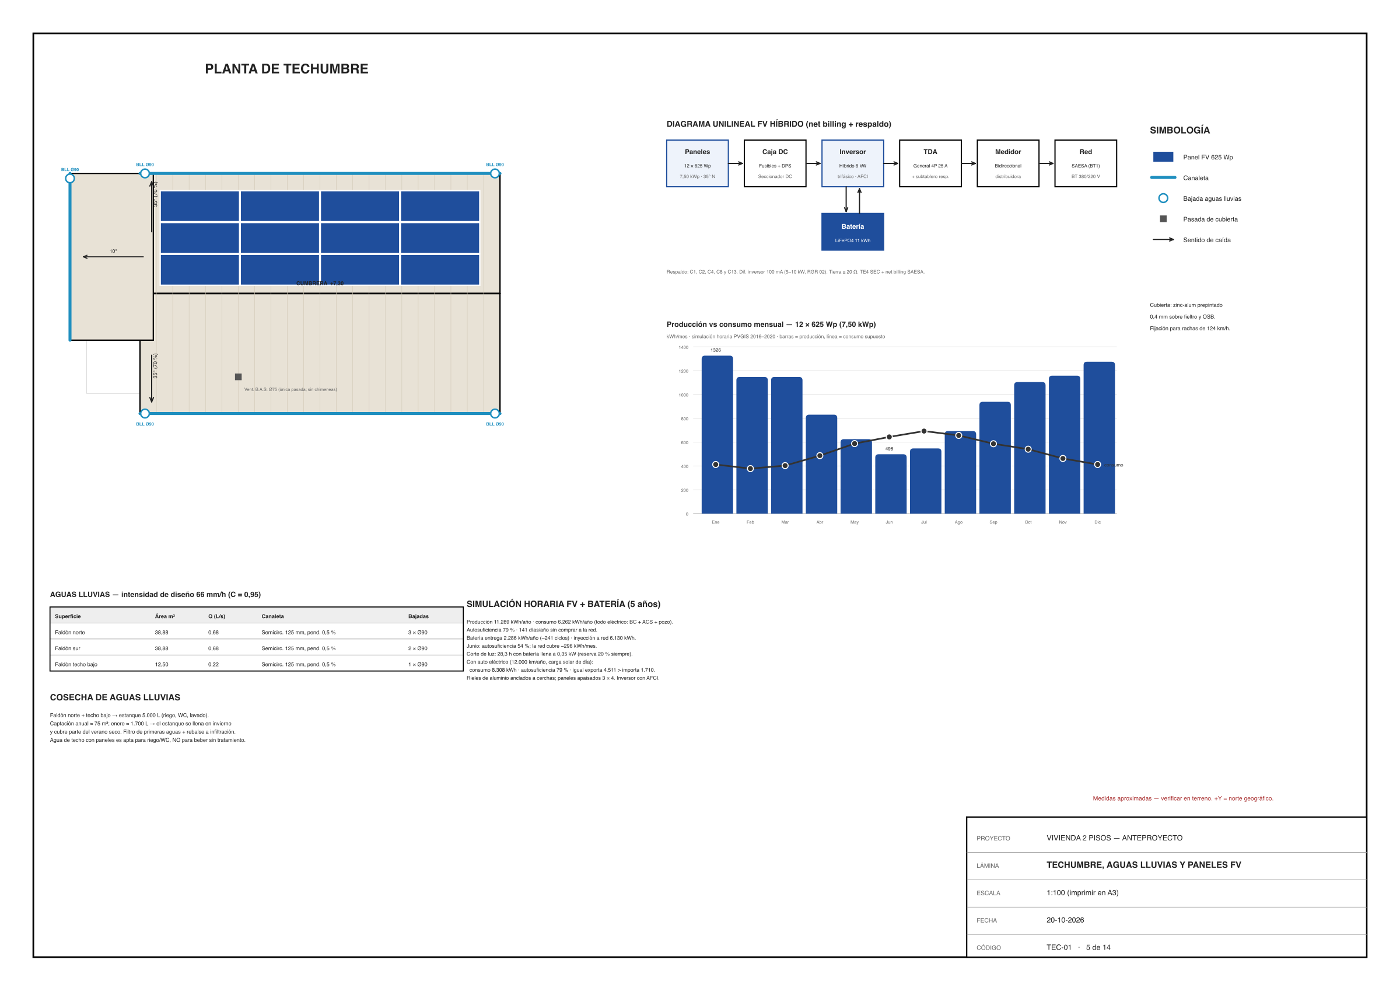
laminas/05_techumbre_fv_lluvias.png
