omaru-san/casa-freecad/laminas/06_ventilacion_calefaccion.png

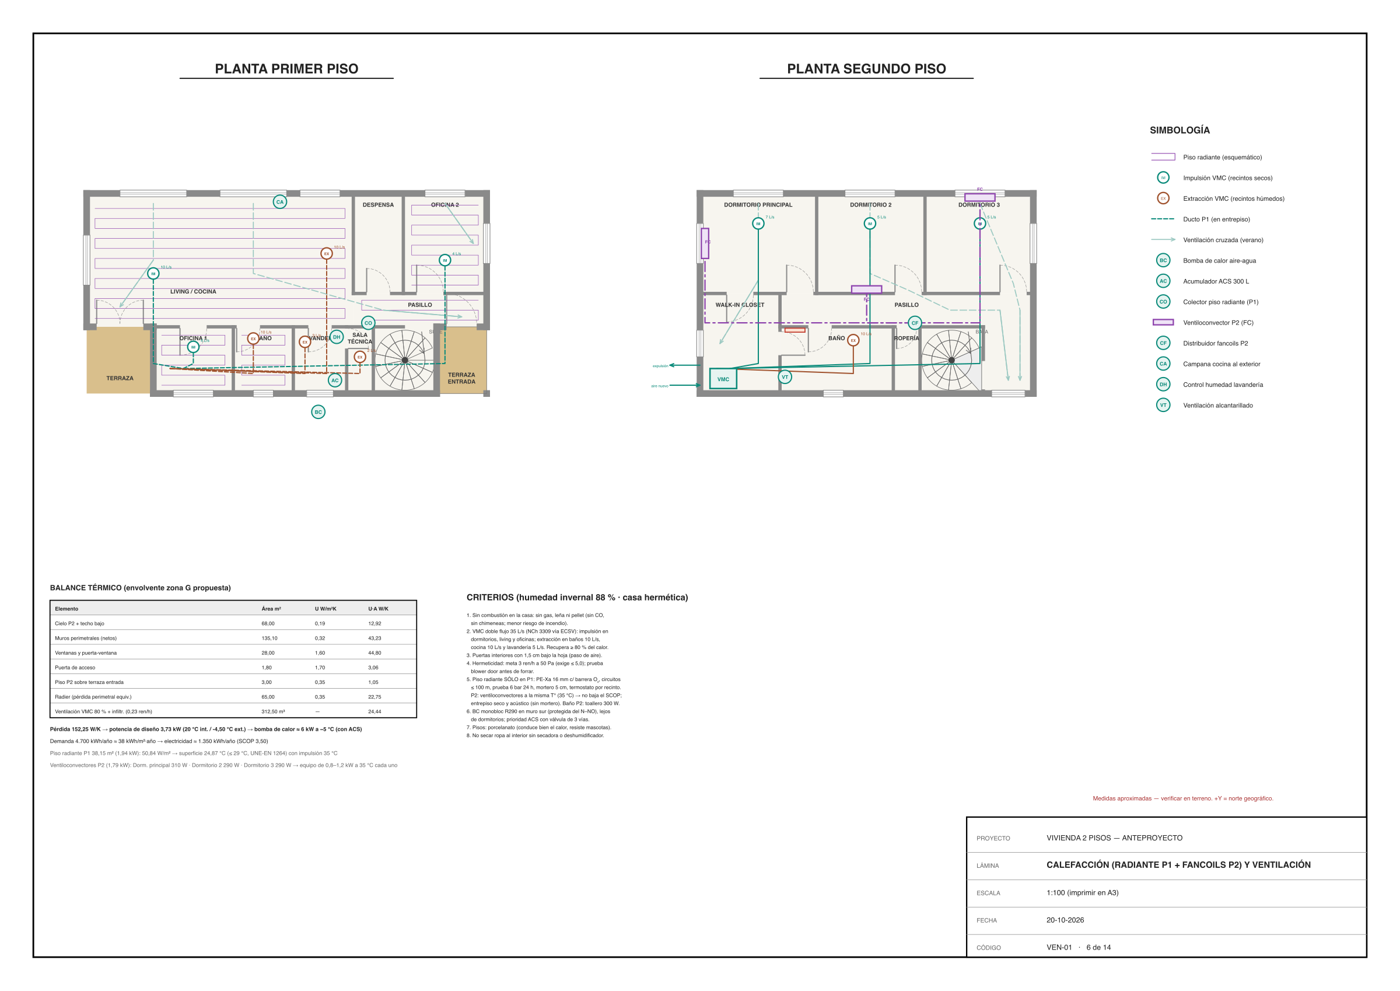
laminas/06_ventilacion_calefaccion.png
