omaru-san/casa-freecad/laminas/07_elevaciones_corte.png

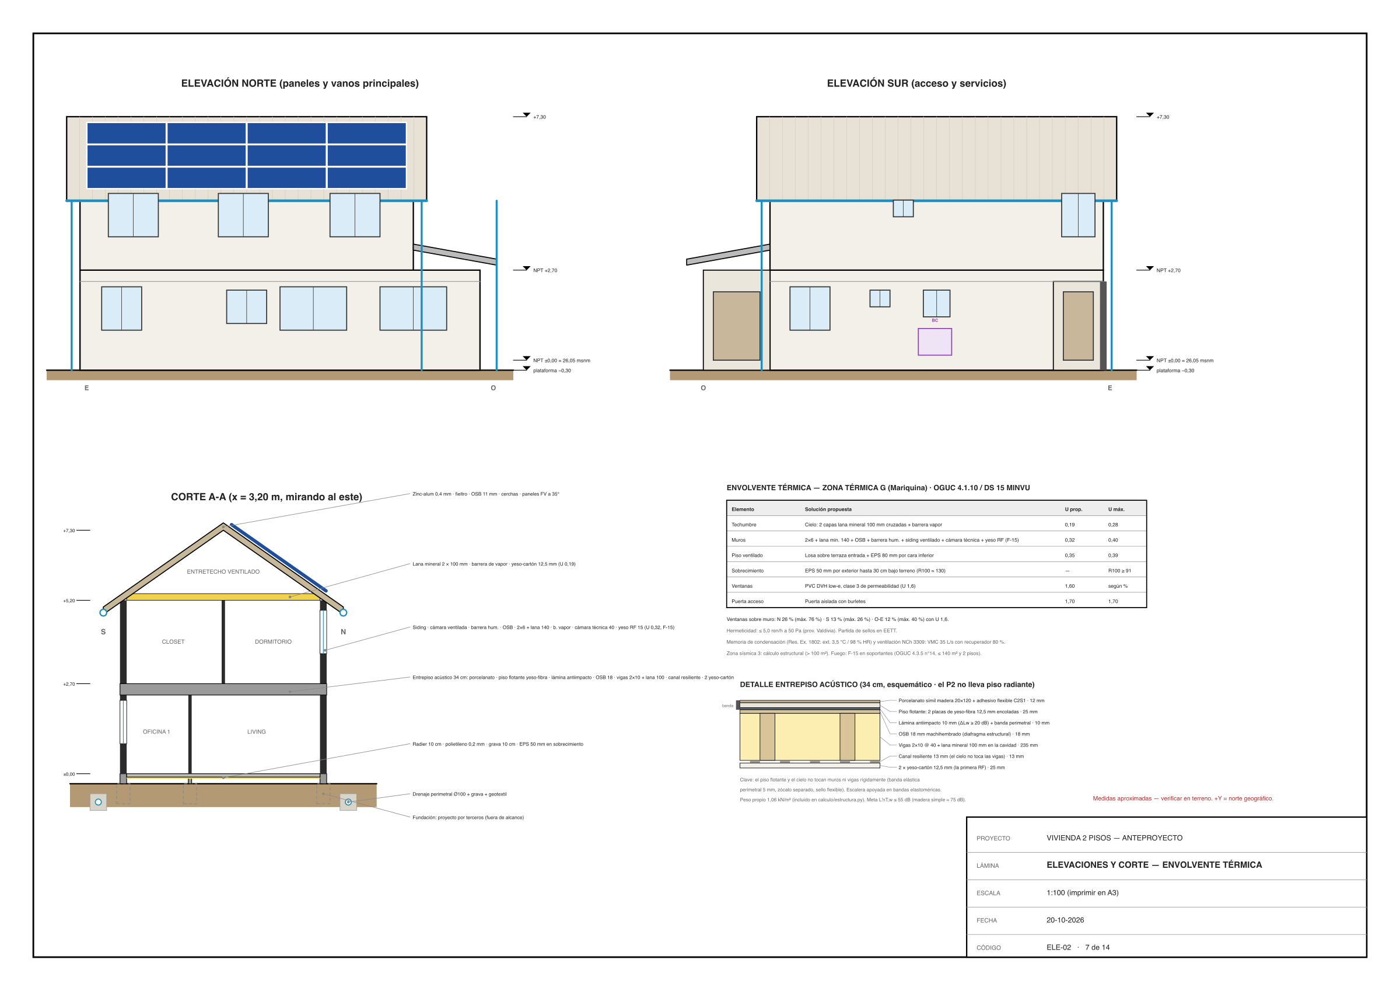
laminas/07_elevaciones_corte.png
