omaru-san/casa-freecad/laminas/08_estructura.png

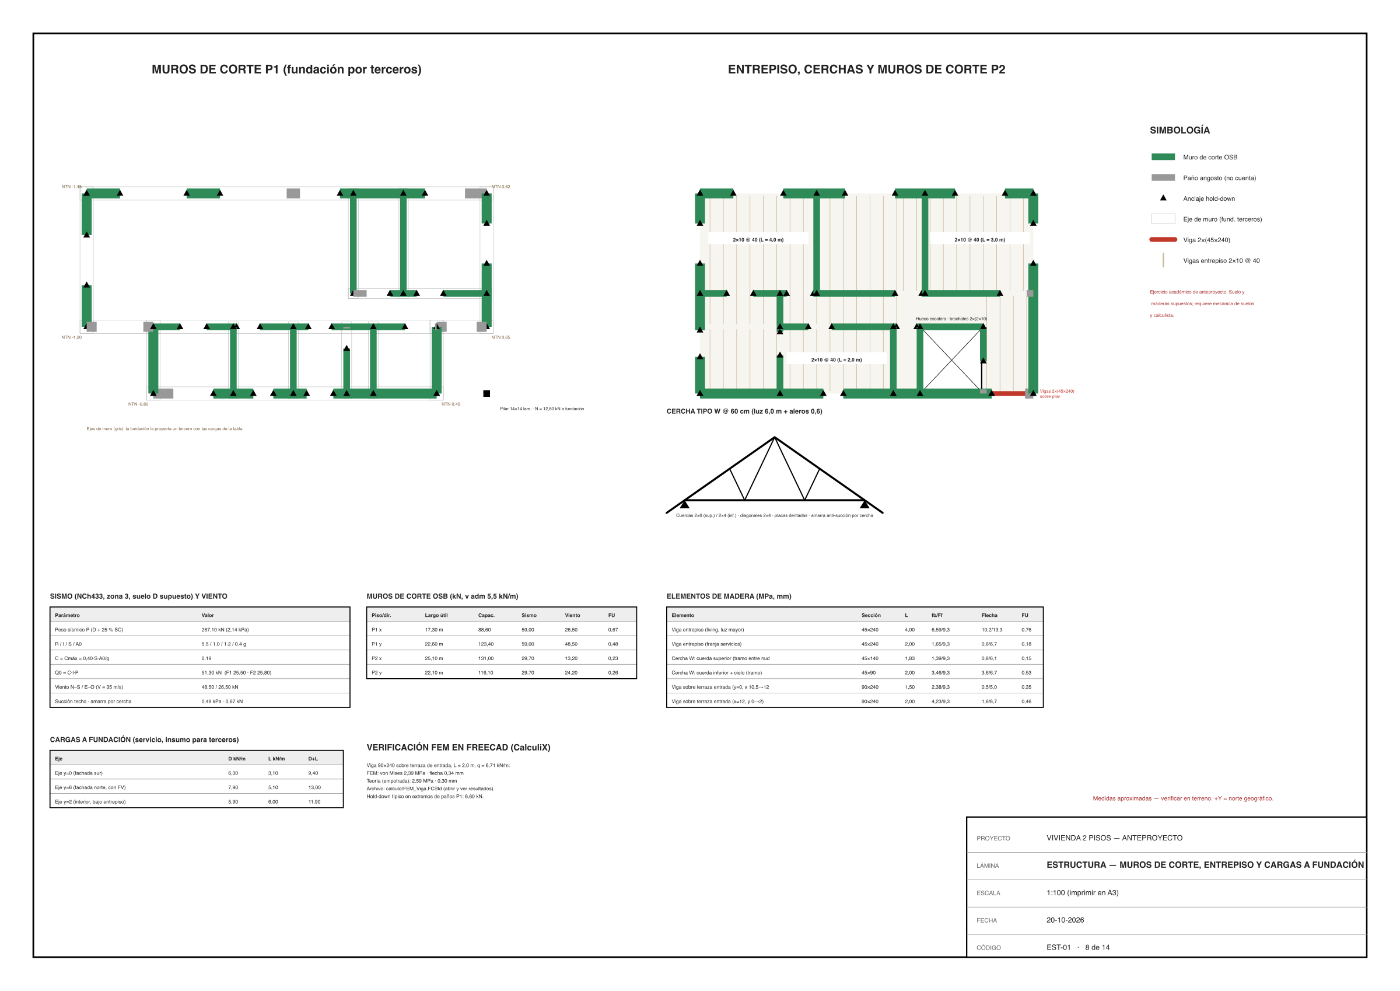
laminas/08_estructura.png
