omaru-san/casa-freecad/laminas/09_topografia.png

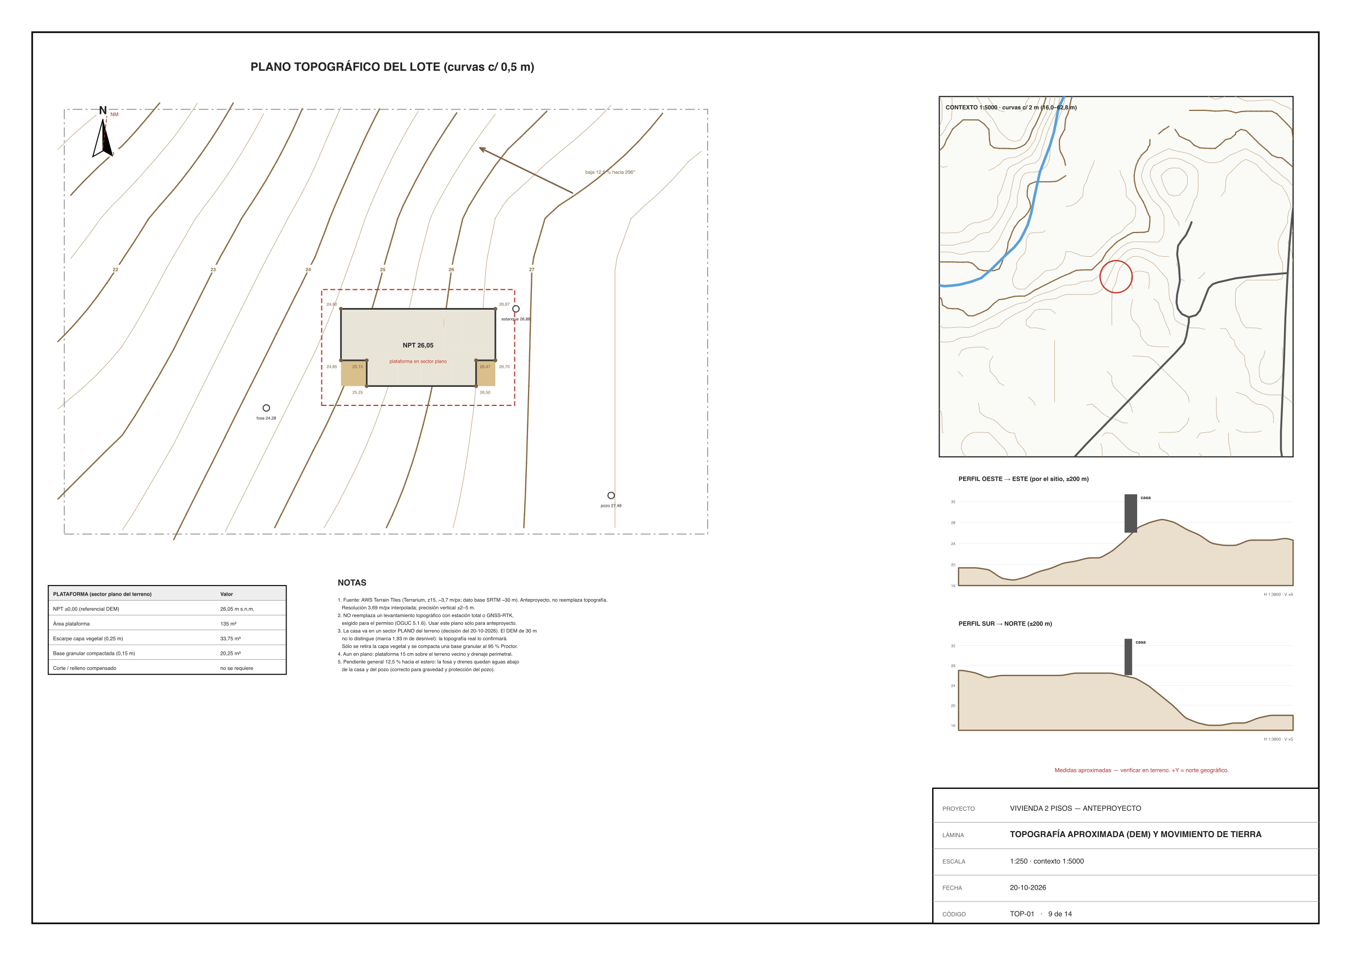
laminas/09_topografia.png
