omaru-san/casa-freecad/laminas/10_interiorismo.png

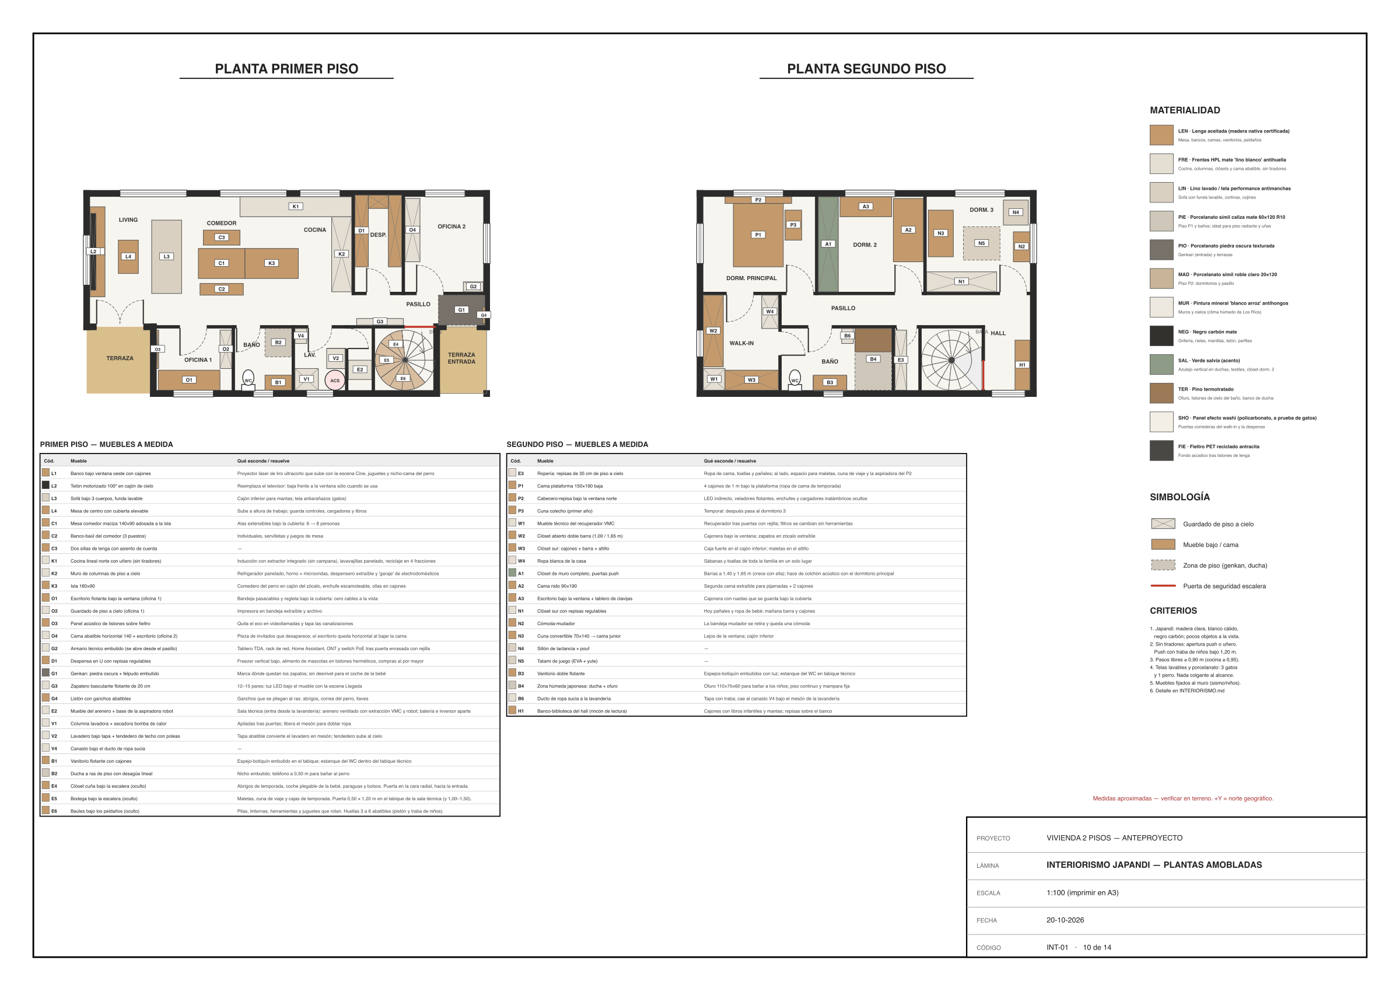
laminas/10_interiorismo.png
