omaru-san/casa-freecad/laminas/11_iluminacion_domotica.png

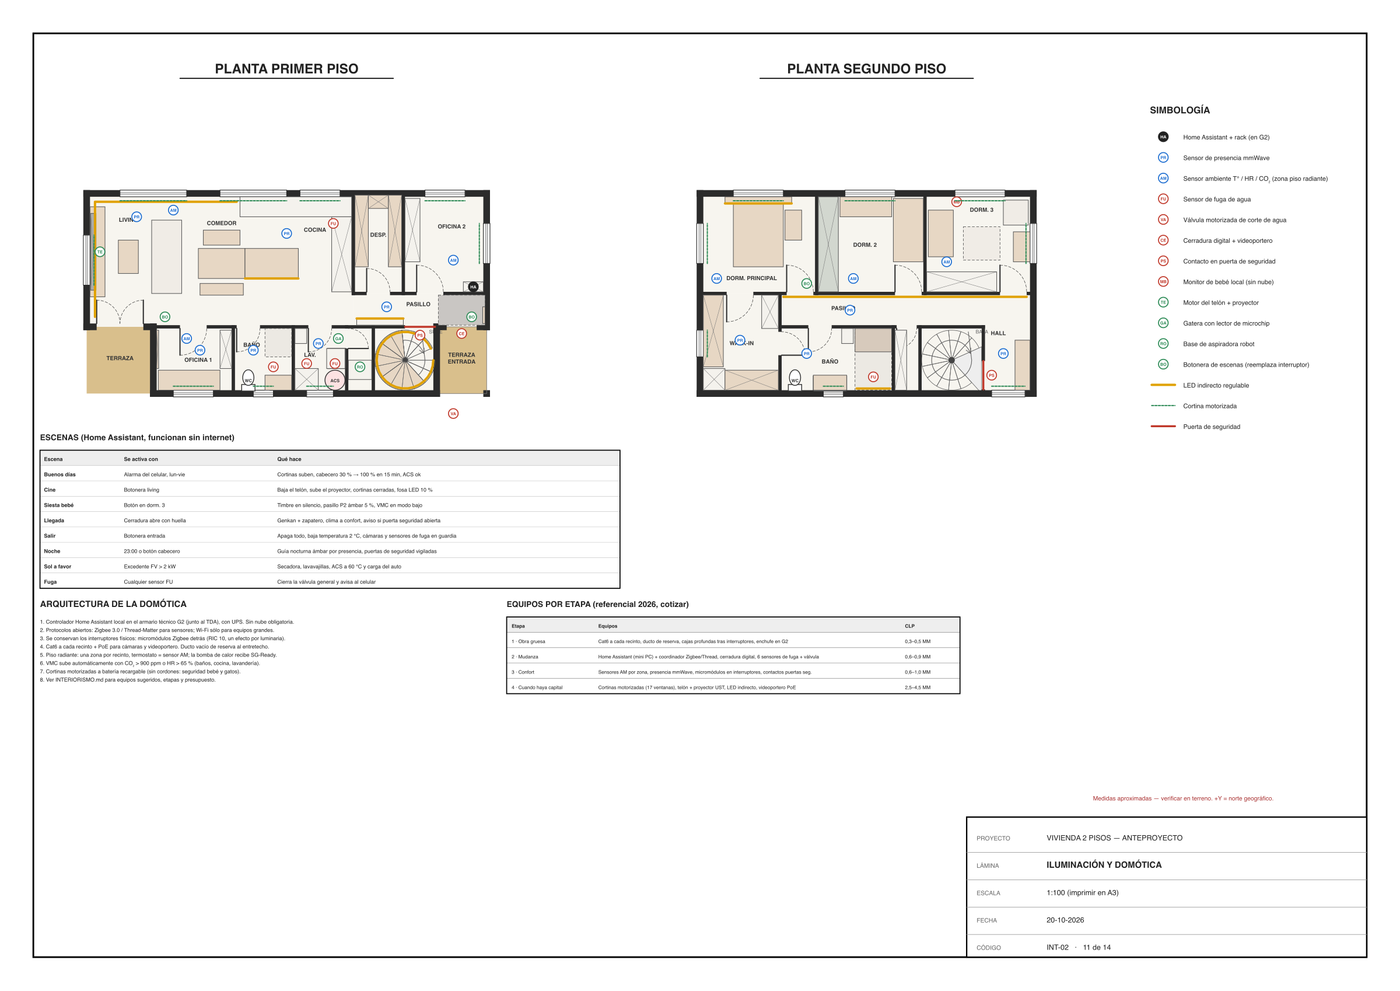
laminas/11_iluminacion_domotica.png
