omaru-san/casa-freecad/laminas/12_tablero_electrico.png

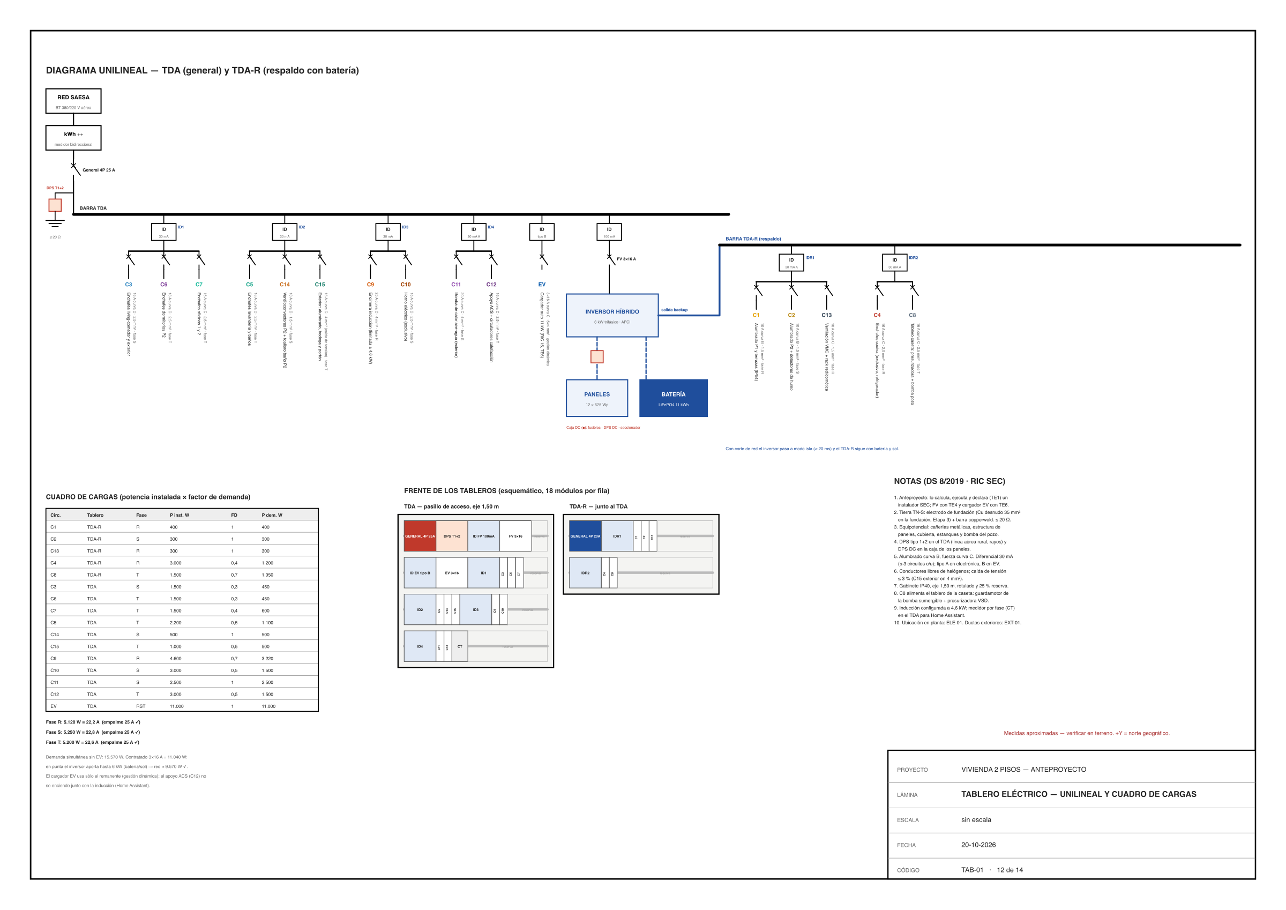
laminas/12_tablero_electrico.png
