omaru-san/casa-freecad/laminas/13_obras_exteriores.png

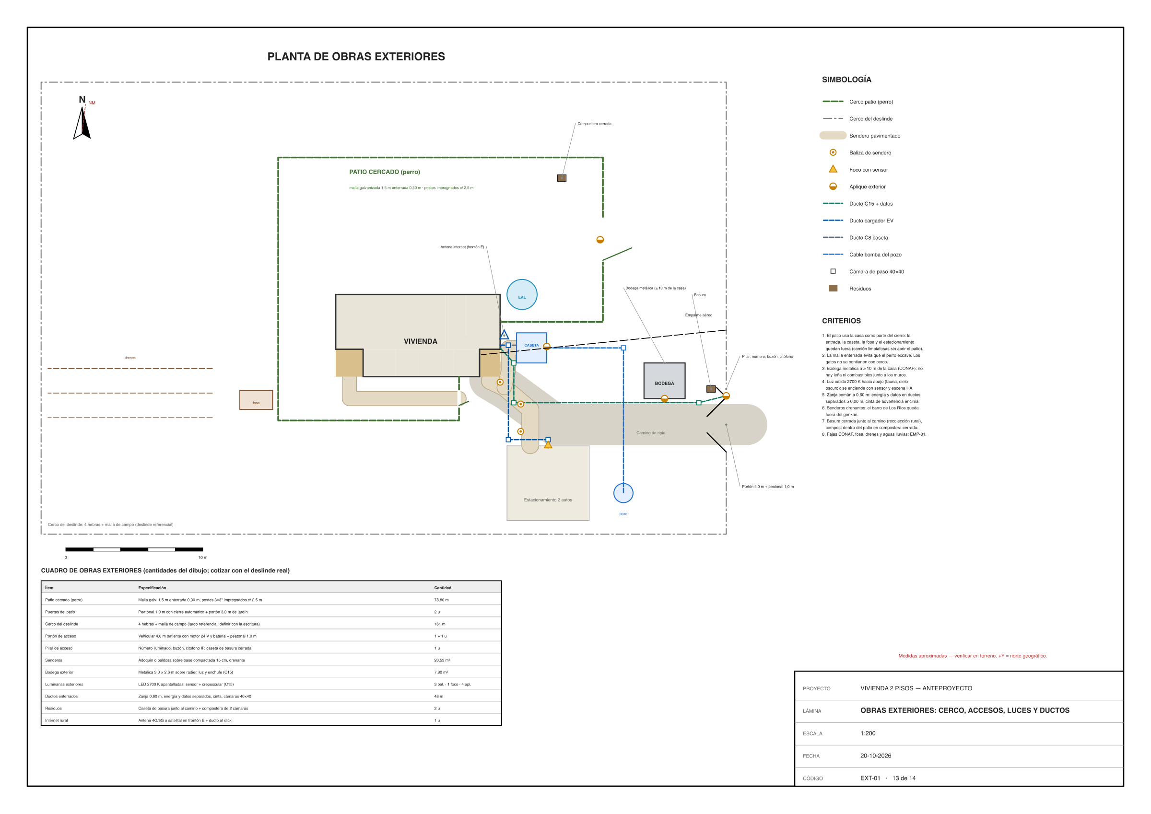
laminas/13_obras_exteriores.png
