omaru-san/casa-freecad/laminas/14_escaleras.png

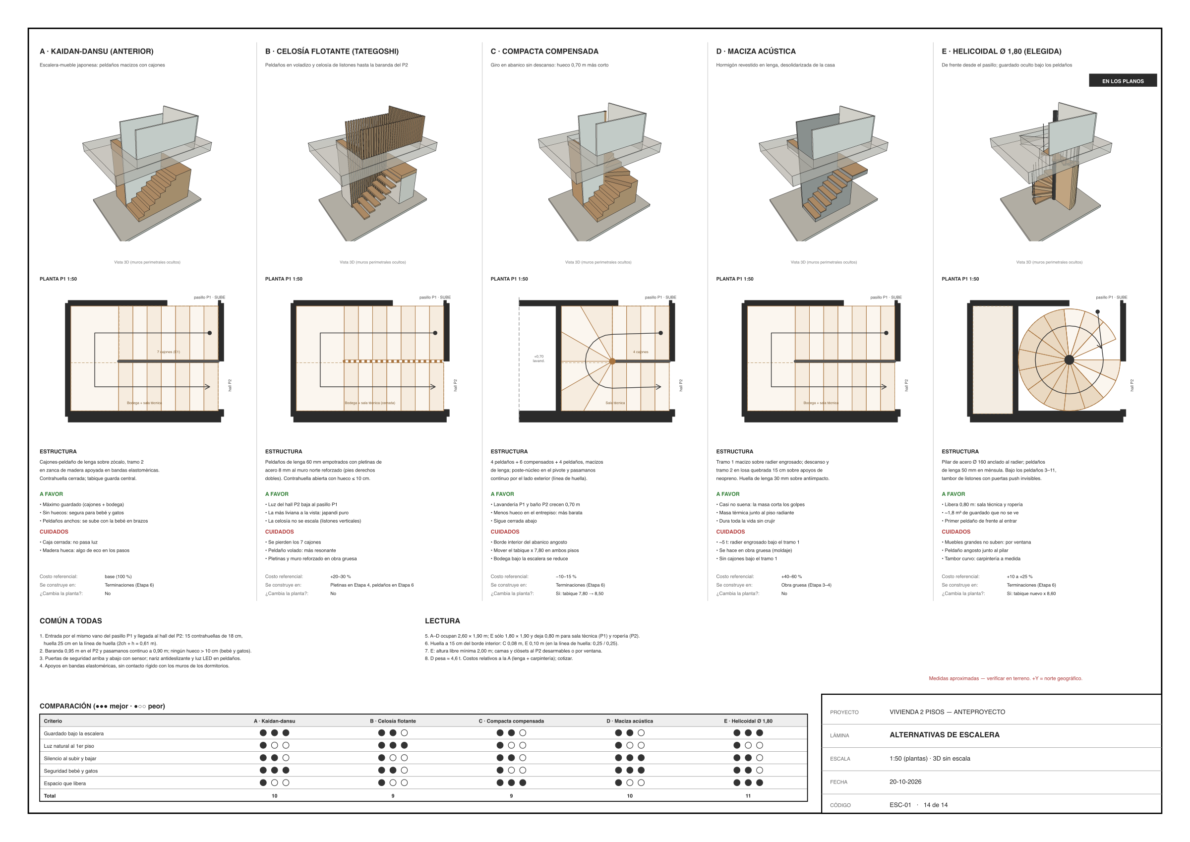
laminas/14_escaleras.png
