omaru-san/casa-freecad/laminas/escalera_A.png

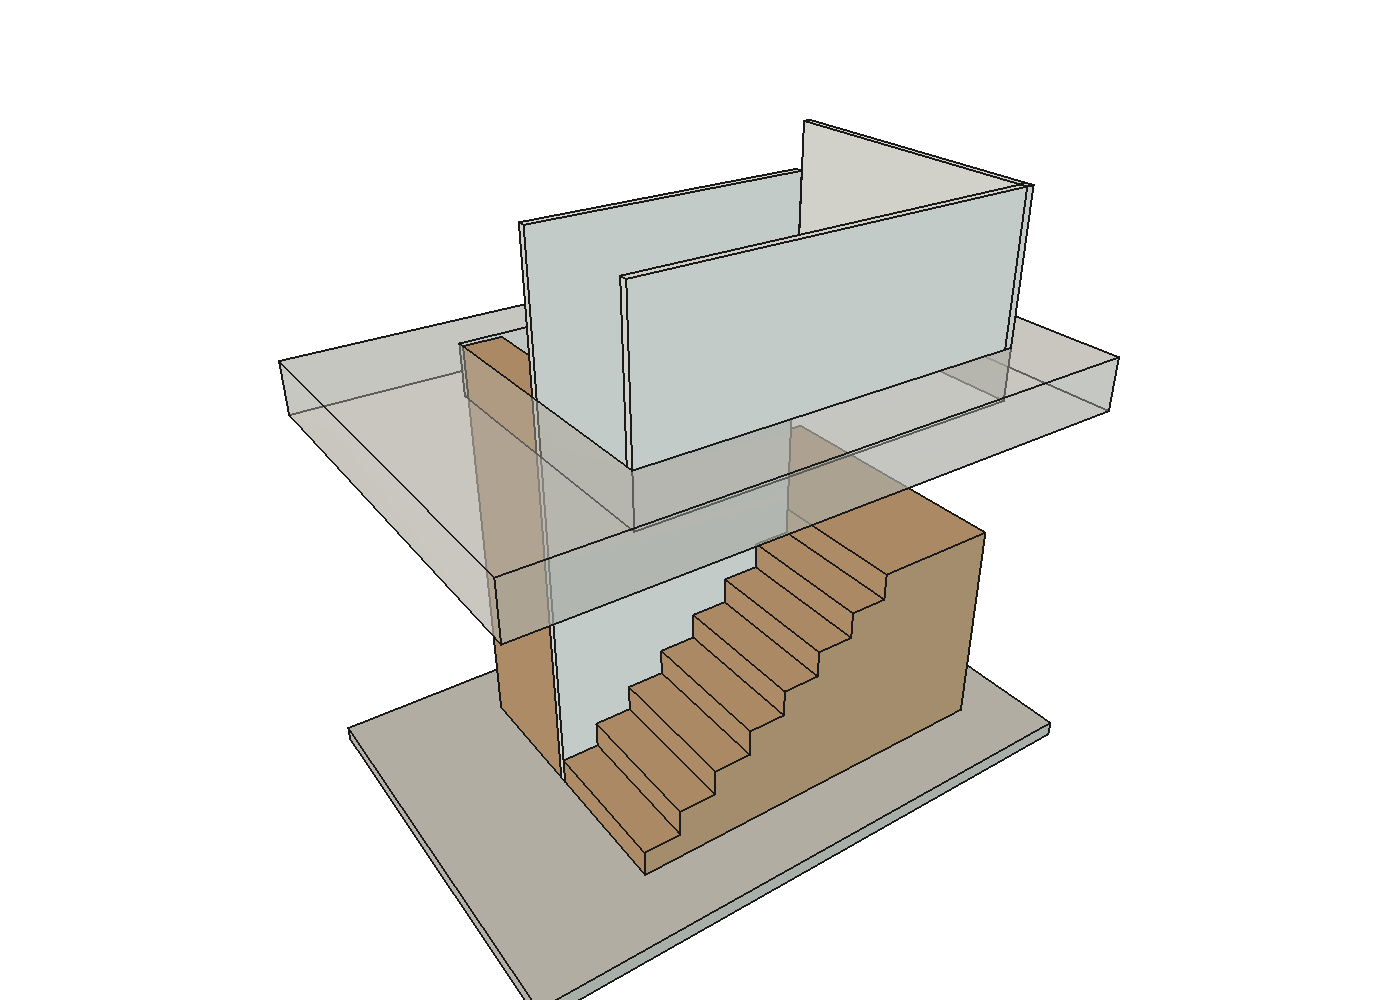
laminas/escalera_A.png
