omaru-san/casa-freecad/laminas/escalera_B.png

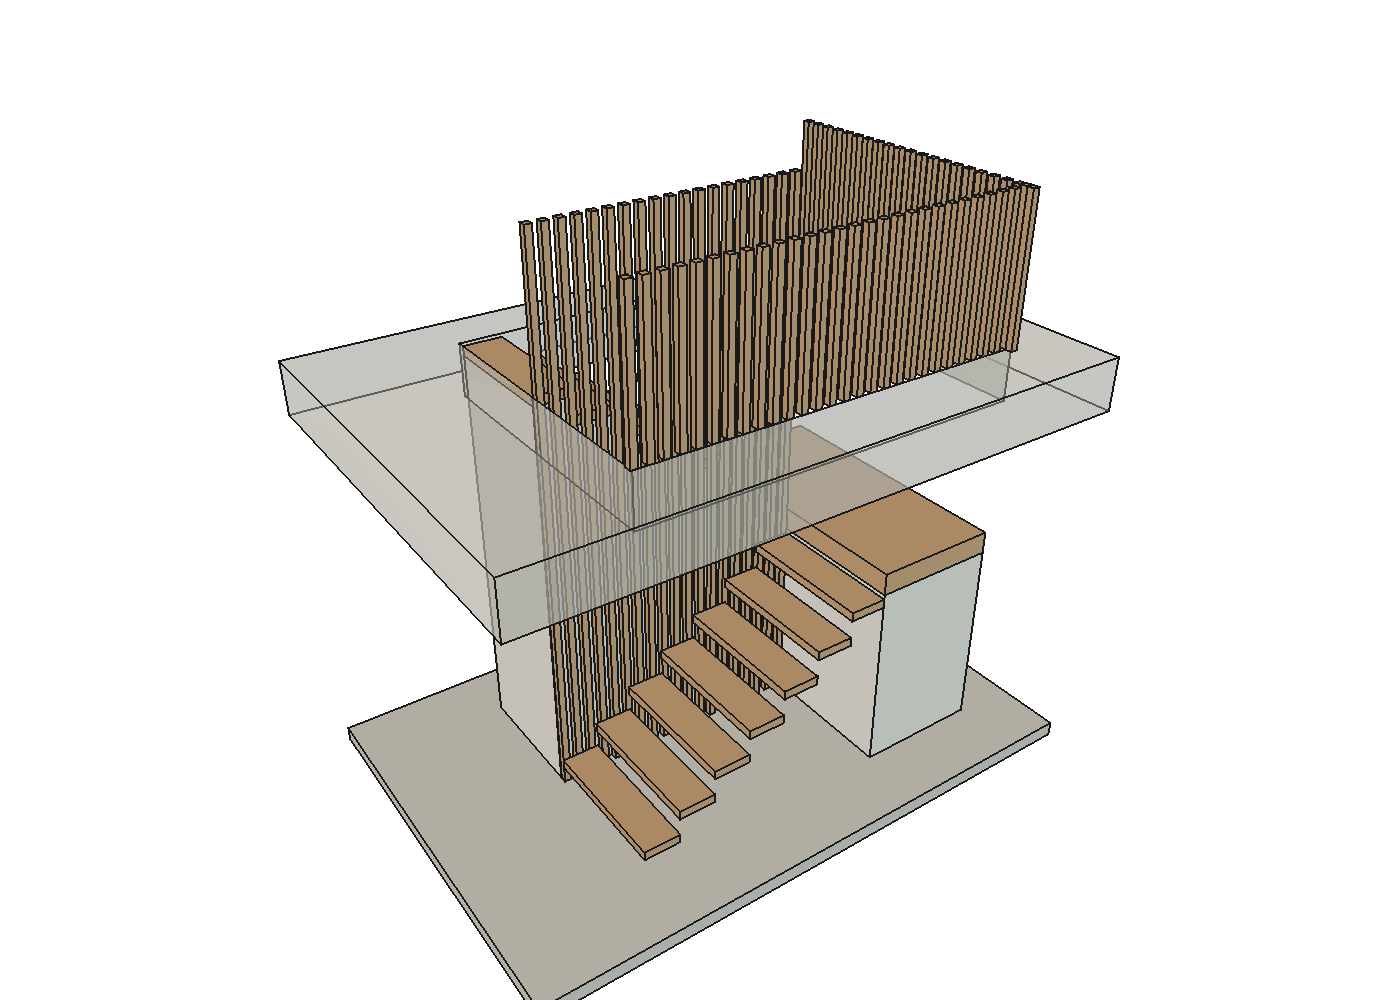
laminas/escalera_B.png
