omaru-san/casa-freecad/laminas/escalera_E.png

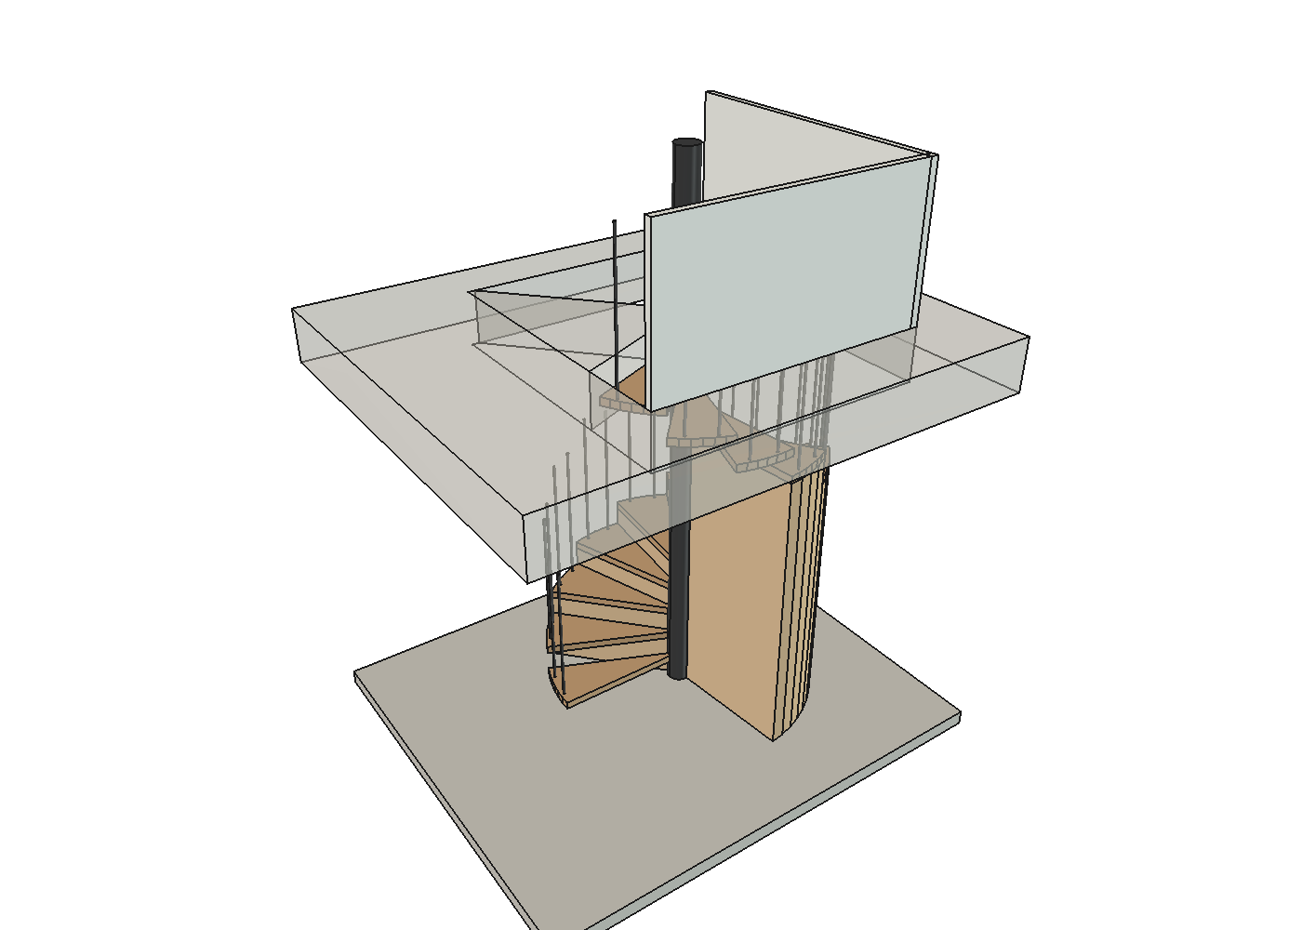
laminas/escalera_E.png
