omaru-san/casa-freecad/laminas/vista_3d.png

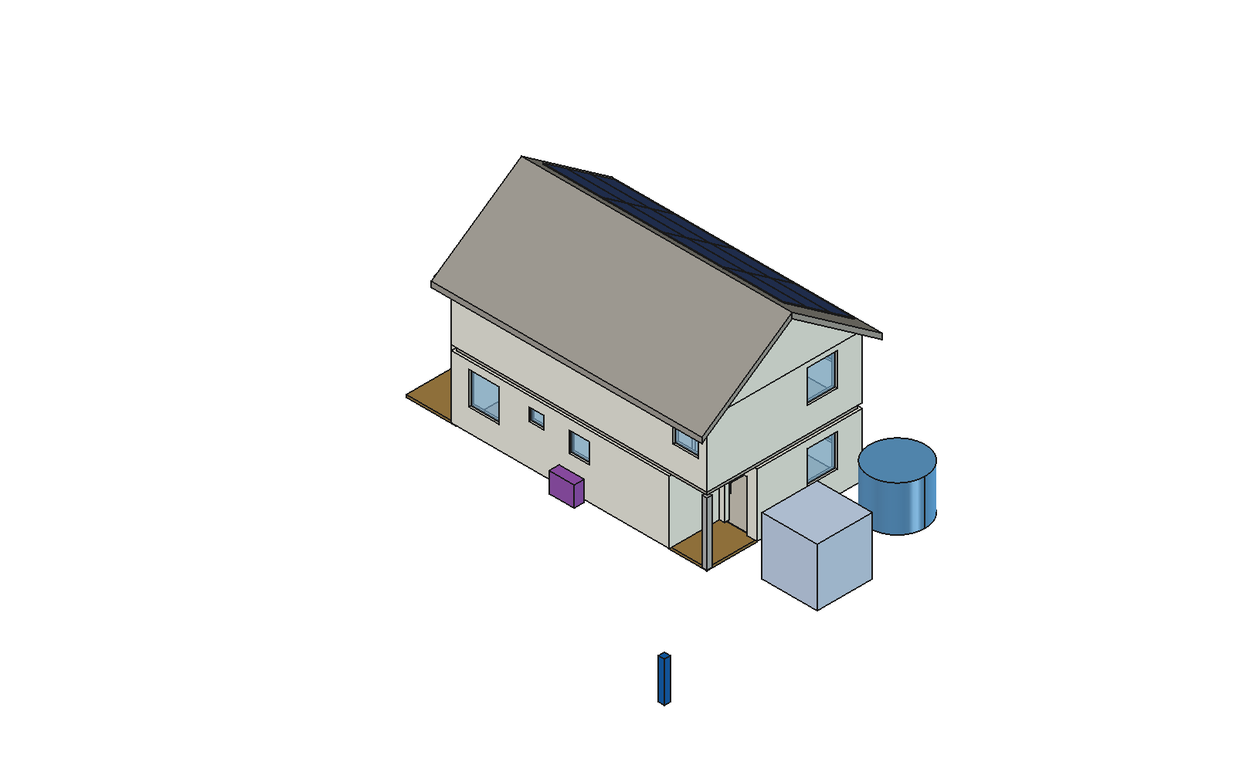
laminas/vista_3d.png
