omaru-san/casa-freecad/sitio/raw/dem/t_15_9738_20300.png

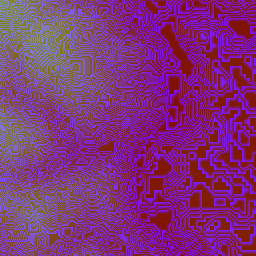
sitio/raw/dem/t_15_9738_20300.png
