omaru-san/casa-freecad/sitio/raw/dem/t_15_9739_20301.png

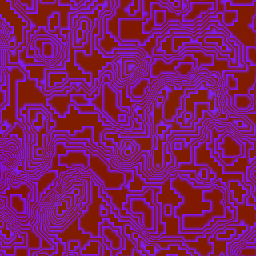
sitio/raw/dem/t_15_9739_20301.png
