omaru-san/casa-freecad/sitio/raw/dem/t_15_9740_20300.png

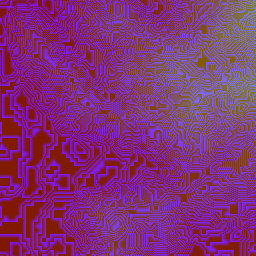
sitio/raw/dem/t_15_9740_20300.png
