omaru-san/casa-freecad/calculo/FEM_Viga.FCStd

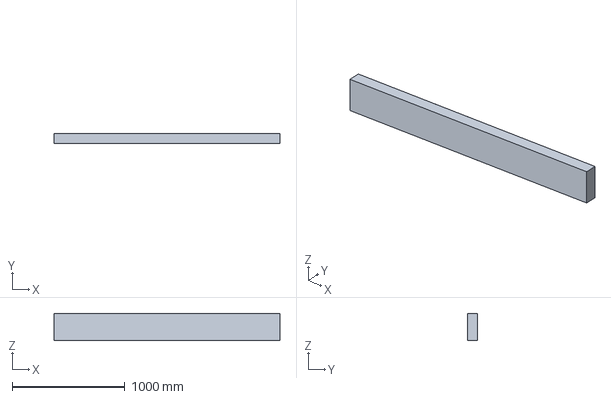
[picture p93: CAD file, 2026-10-20]
calculo/FEM_Viga.FCStd
2000.0 x 90.0 x 240.0 mm
