omaru-san/casa-freecad/Casa.FCStd

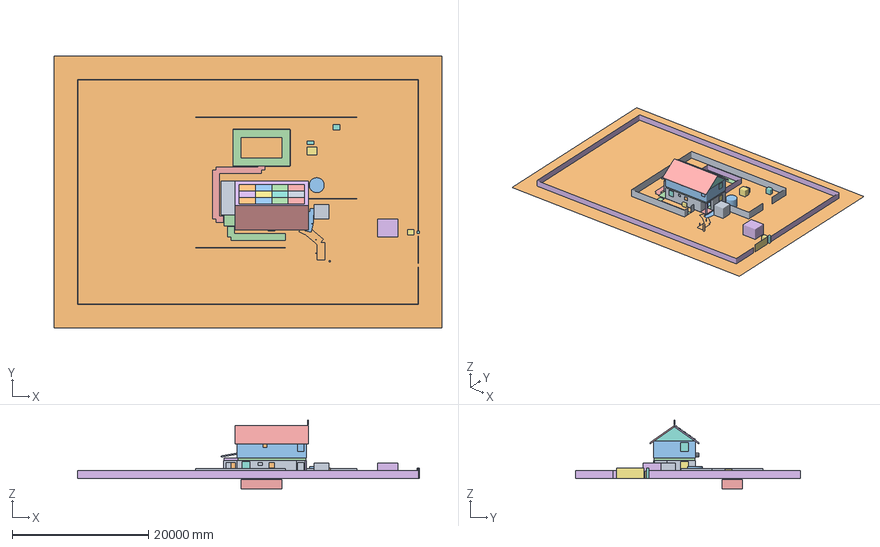
[picture p94: CAD file, 2026-10-21]
Casa.FCStd
57000.0 x 40000.0 x 10100.6 mm
Muros_P1
Vidrio_P1_1
Vidrio_P1_2
Vidrio_P1_3
Vidrio_P1_4
Vidrio_P1_5
Vidrio_P1_6
Vidrio_P1_7
Vidrio_P1_8
Vidrio_P1_9
Radier_P1
Terraza_1
Terraza_2
Techo_Living
Escalera_Helicoidal
Escalera_Pilar
Escalera_Baranda
Escalera_Guardado_Oculto
Muros_P2
Vidrio_P2_1
Vidrio_P2_2
Vidrio_P2_3
Vidrio_P2_4
Vidrio_P2_5
Vidrio_P2_6
Vidrio_P2_7
Vidrio_P2_8
Losa_P2
Faldon_Sur
Faldon_Norte
Fronton_x2
Fronton_x12
Techo_Bajo
Panel_E1_01
Panel_E1_02
Panel_E1_03
Panel_E1_04
Panel_E1_05
Panel_E1_06
Panel_E1_07
Panel_E1_08
Panel_E1_09
Panel_E1_10
Panel_E1_11
Panel_E1_12
Pilar_1
Bomba_Calor
Acumulador_ACS_300L
Caseta_Presurizacion
Cargador_EV
Estanque_Lluvias
Inversor_Hibrido
Bateria_11kWh
Cerco_Deslinde
Porton_Acceso
Pilar_Acceso
Cerco_Patio
Sendero_1
Sendero_2
Sendero_3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
