omaru-san/casa-freecad/Escaleras.FCStd

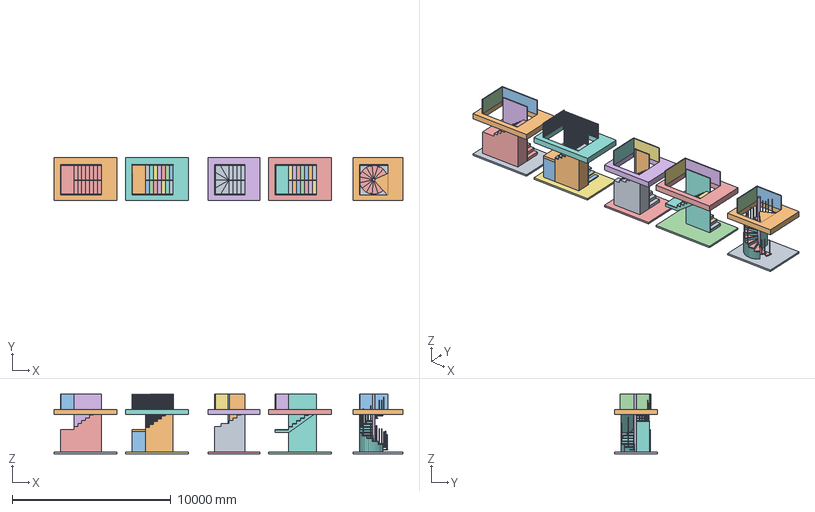
[picture p95: CAD file, 2026-10-21]
Escaleras.FCStd
21950.0 x 2700.0 x 3750.0 mm
Escalera_A_Radier
Escalera_A_Losa_P2
Escalera_A_Baranda_P2_7_85_1_90
Escalera_A_Baranda_P2_7_85_0_05
Escalera_A_Peldanos
Escalera_A_Guarda_Central
Escalera_B_Radier
Escalera_B_Losa_P2
Escalera_B_Celosia_P2_7_85_1_90
Escalera_B_Celosia_P2_7_85_0_05
Escalera_B_Peldano_01
Escalera_B_Peldano_02
Escalera_B_Peldano_03
Escalera_B_Peldano_04
Escalera_B_Peldano_05
Escalera_B_Peldano_06
Escalera_B_Peldano_07
Escalera_B_Peldano_08
Escalera_B_Peldano_09
Escalera_B_Peldano_10
Escalera_B_Peldano_11
Escalera_B_Peldano_12
Escalera_B_Peldano_13
Escalera_B_Peldano_14
Escalera_B_Peldano_15
Escalera_B_Bodega_Tramo2
Escalera_B_Bodega_Descanso
Escalera_B_Celosia_Central
Escalera_C_Radier
Escalera_C_Losa_P2
Escalera_C_Baranda_P2_8_55_1_90
Escalera_C_Baranda_P2_8_55_0_05
Escalera_C_Peldanos
Escalera_C_Guarda_Central
Escalera_C_Poste_Nucleo
Escalera_D_Radier
Escalera_D_Losa_P2
Escalera_D_Baranda_P2_7_85_1_90
Escalera_D_Baranda_P2_7_85_0_05
Escalera_D_Hormigon
Escalera_D_Huella_01
Escalera_D_Huella_02
Escalera_D_Huella_03
Escalera_D_Huella_04
Escalera_D_Huella_05
Escalera_D_Huella_06
Escalera_D_Huella_07
Escalera_D_Huella_08
Escalera_D_Huella_09
Escalera_D_Huella_10
Escalera_D_Huella_11
Escalera_D_Huella_12
Escalera_D_Huella_13
Escalera_D_Huella_14
Escalera_D_Huella_15
Escalera_D_Guarda_Central
Escalera_E_Radier
Escalera_E_Losa_P2
Escalera_E_Baranda_P2_8_65_1_90
Escalera_E_Baranda_P2_8_65_0_05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
