omaru-san/casa-freecad/(commit log)

2026-10-20 Proyecto casa FreeCAD: modelo 3D, 9 láminas, memorias de cálculo y datos del sitio
    Vivienda 2 pisos en Puringue Pobre (Mariquina, Los Ríos) diseñada por código:
    modelo FreeCAD, láminas de arquitectura, instalaciones, techumbre FV, ventilación,
    elevaciones, estructura y topografía; memorias estructural (con FEM CalculiX),
    de condensación, FV + batería y clima del sitio 1995–2025.
    [Casa.FCStd, FEM_Viga.FCStd]
2026-10-20 Ajusta el diseño a la normativa chilena: casa todo eléctrica y verificación automática
    - Sin gas ni combustión: bomba de calor aire-agua con piso radiante, ACS 300 L
    con válvula termostática, inducción y VMC con recuperador (NCh 3309).
    - Eléctrico según RIC SEC: 15 circuitos, diferenciales de máximo 3 circuitos,
    enchufes de baño fuera de volúmenes 0-2, un interruptor por centro,
    detectores de humo, empalme trifásico y cargador EV (RIC 15).
    - Sanitario: pendiente 3 % (RIDAA art. 88), estanque + presurizadora,
    llaves de paso por recinto húmedo.
    - Seguridad: antepecho P2 1,00 m, fajas CONAF, estacionamiento 2 autos.
    - Fundaciones fuera de alcance: se entregan cargas a fun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
    [Casa.FCStd]
2026-10-20 Interiorismo japandi: plantas amobladas, materialidad, iluminación y domótica
    - interiorismo_datos.py: muebles a medida que esconden (telón + proyector,
    kaidan-dansu, bodega bajo escalera con arenero, cama abatible, armario
    técnico), materialidad con lenga, luz indirecta, domótica y escenas.
    - Láminas 10 (plantas amobladas) y 11 (iluminación y domótica); juego de 11.
    - construir_interior.py: muebles en el modelo FreeCAD (Interior_P1/P2).
    - INTERIORISMO.md: concepto, recinto por recinto, cambios a coordinar
    con los proyectistas y presupuesto por etapas.
    [Casa.FCStd]
2026-10-20 Entrepiso acústico, tablero eléctrico, instalaciones pendientes y obras exteriores
    - Entrepiso flotante de 34 cm (meta L'nT,w ≤ 55 dB); cielo P1 a 2,36 m, Z2 sin cambio.
    - P2 sin piso radiante: ventiloconvectores por dormitorio y toallero en el baño.
    - Plataforma en sector plano (escarpe + base granular); terreno 3D plano.
    - AF/AC fuera del radier (muros y entrepiso); sólo descargas bajo radier con camisas.
    - Lámina 12: unilineal TDA + TDA-R de respaldo, DPS T1+2, frentes y cuadro de cargas.
    - Lámina 13: cercos, portón, senderos, bodega, luces, residuos, antena y ductos.
    - Desgrasadora, tratamiento Fe/Mn, impermeabilización de baños.
    - Canalizaciones por circuito en lámina 02; ju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
    [Casa.FCStd]
2026-10-21 Escalera helicoidal Ø 1,80 m con guardado oculto y lámina de alternativas
    - Lámina 14 (ESC-01) y modelo Escaleras.FCStd: la helicoidal elegida y 4
    alternativas comparadas (3D, planta 1:50, estructura).
    - La helicoidal libera una franja de 0,80 m: sala técnica en el P1 (batería,
    inversor, arenero) y ropería en el P2.
    - Guardado oculto bajo los peldaños 3–11 (E4 clóset, E5 bodega, E6 baúles).
    - Nuevas verificaciones de altura libre y de las alternativas; láminas,
    memorias y documentación regeneradas.
    [Casa.FCStd, Escaleras.FCStd]
